alleybeachelectric/Gen6/ACB/ACB/ACB/jpg/ecam test.png

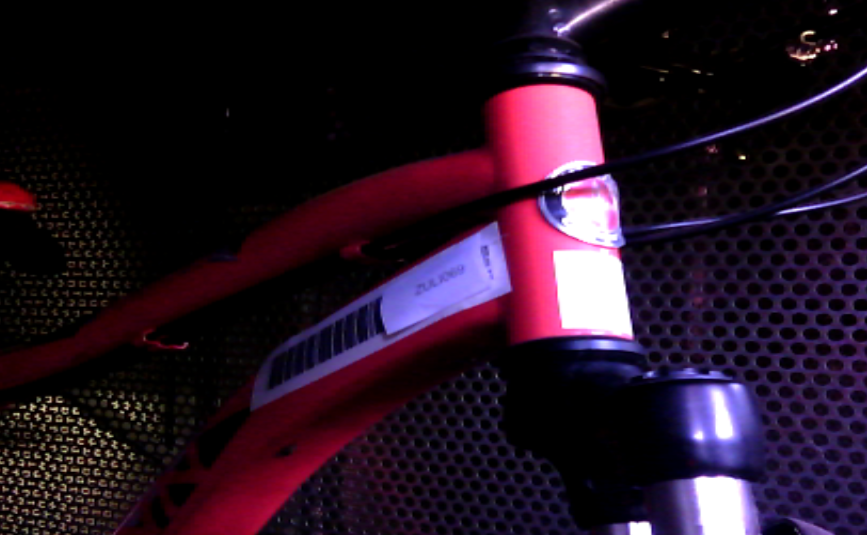
ACB/ACB/ACB/jpg/ecam test.png
