alleybeachelectric/Gen6/ACB/ACB/ACB/jpg/cam1 12 in from top no IR.jpg

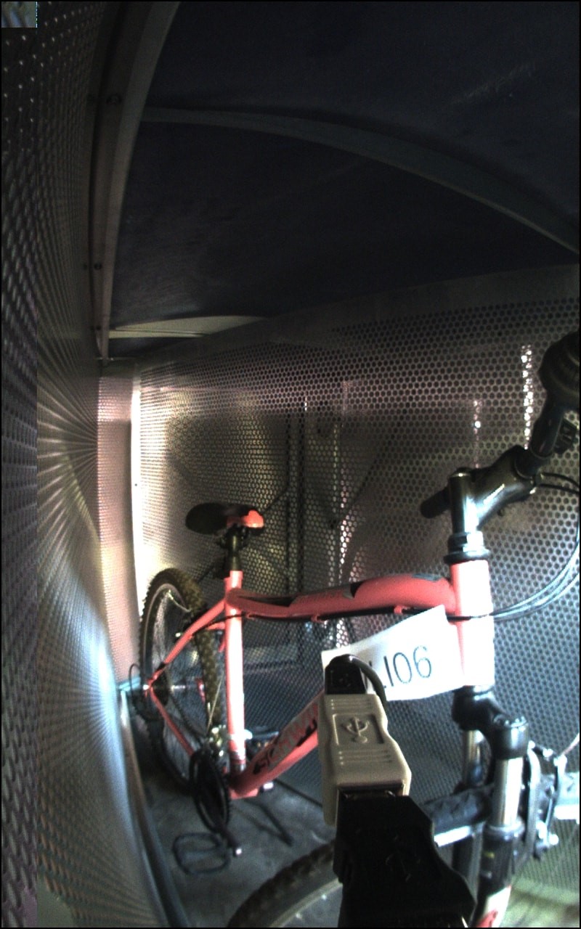
ACB/ACB/ACB/jpg/cam1 12 in from top no IR.jpg
