alleybeachelectric/Gen6/ACB/ACB/ACB/jpg/cam1 12 in from bottom rotated closer to center devider pitched 14.3degrees.jpg

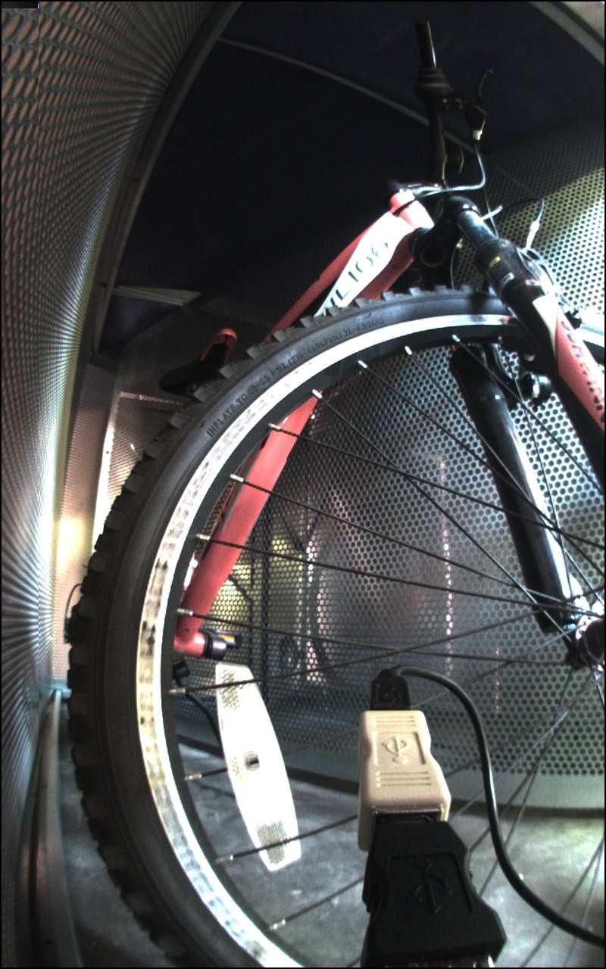
ACB/ACB/ACB/jpg/cam1 12 in from bottom rotated closer to center devider pitched 14.3degrees.jpg
