alleybeachelectric/Gen6/ACB/ACB/ACB/jpg/cam1 12 in from bottom, no IR .jpg

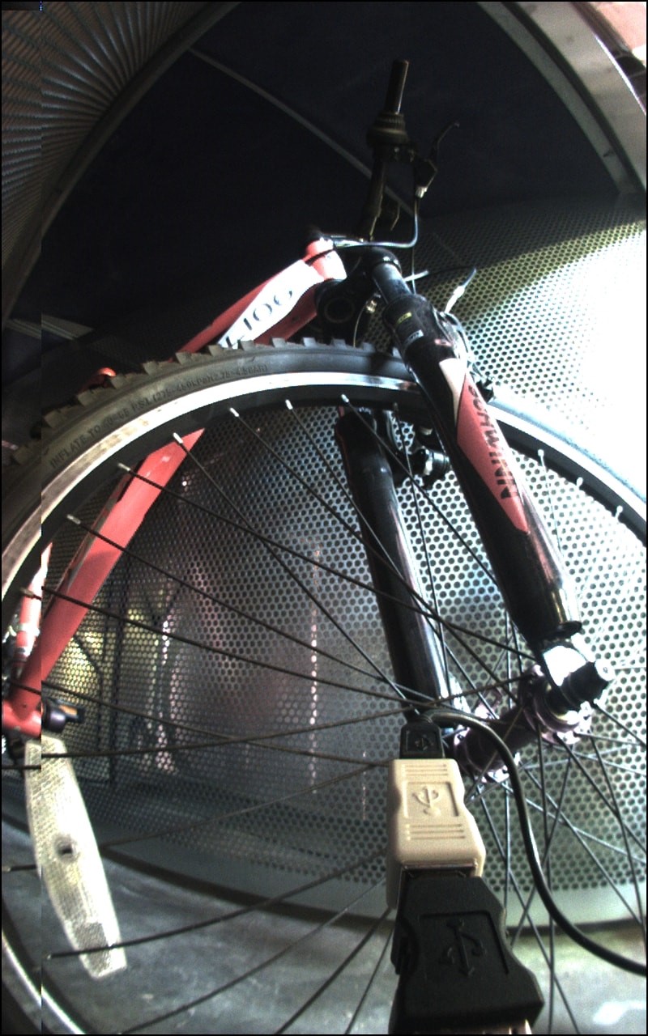
ACB/ACB/ACB/jpg/cam1 12 in from bottom, no IR .jpg
