alleybeachelectric/Gen6/ACB/ACB/ACB/jpg/ecam 1 in.png

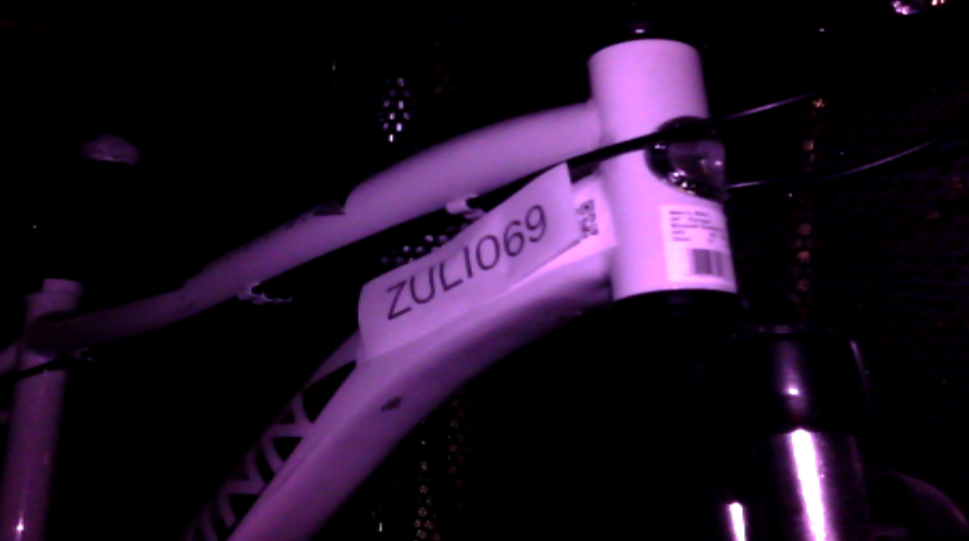
ACB/ACB/ACB/jpg/ecam 1 in.png
