alleybeachelectric/Gen6/ACB/ACB/ACB/jpg/ecam 2 in.png

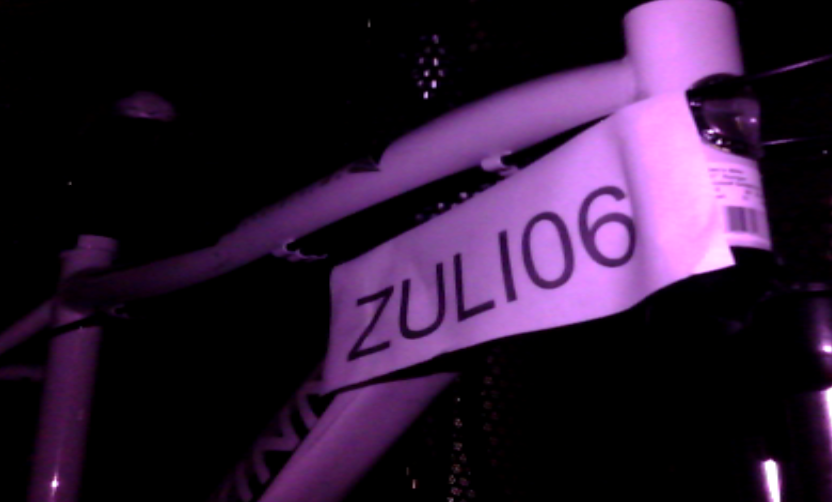
ACB/ACB/ACB/jpg/ecam 2 in.png
