alleybeachelectric/Gen6/ACB/ACB/ACB/jpg/ecam .5 in.png

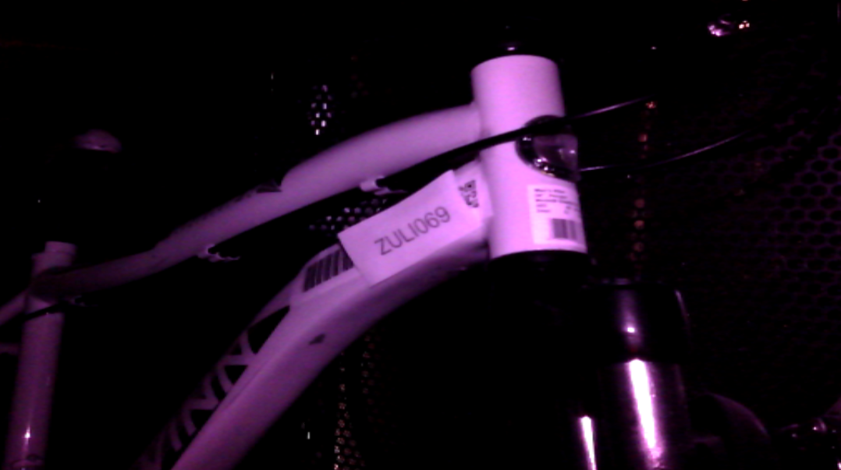
ACB/ACB/ACB/jpg/ecam .5 in.png
