alleybeachelectric/Gen6/ACB/ACB/ACB/jpg/ecam .25 in.png

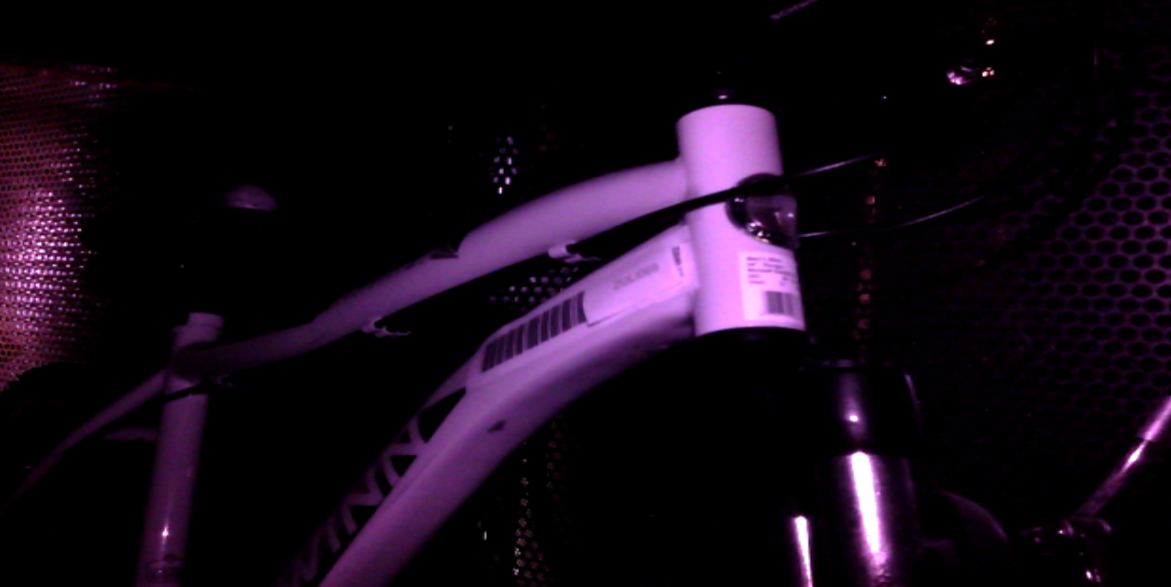
ACB/ACB/ACB/jpg/ecam .25 in.png
