alleybeachelectric/Gen6/ACB/ACB/ACB/jpg/r2/ecam 2 in mid.png

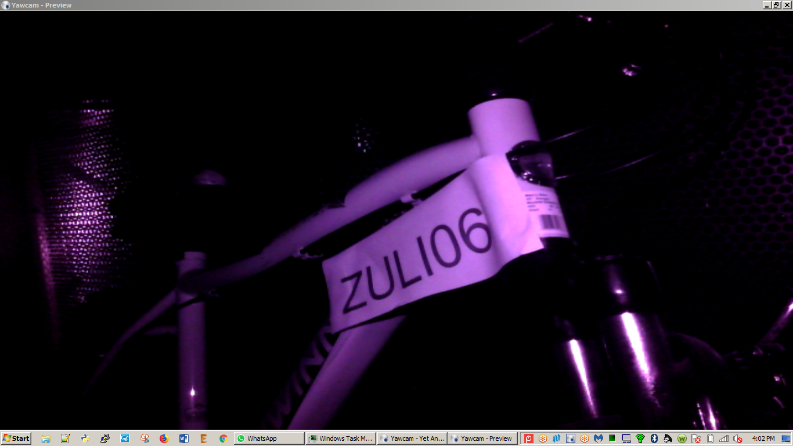
ACB/ACB/ACB/jpg/r2/ecam 2 in mid.png
