alleybeachelectric/Gen6/ACB/ACB/GMB dims.PNG

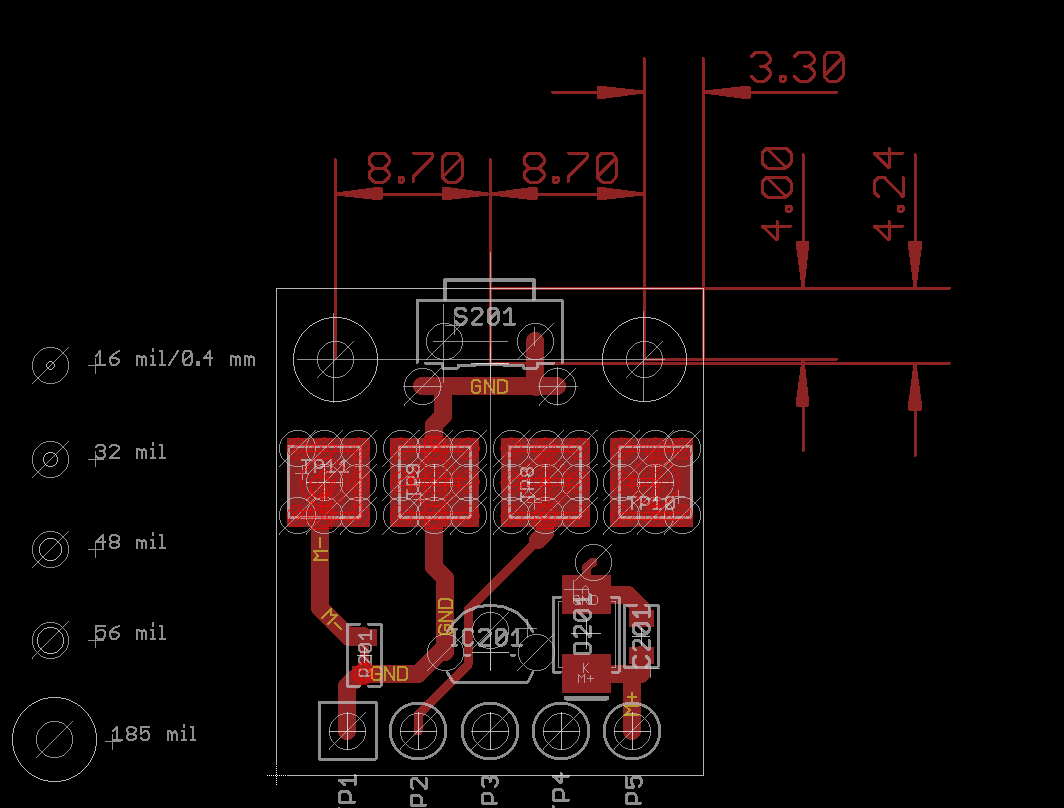
ACB/ACB/GMB dims.PNG
