alleybeachelectric/Gen6/ACB/ACB-LITE-3.2/Fab file release for quote/rd.ACB LITE R3.2 BOM.xlsx

Qty | Value | Device | Package | Parts | Description | digikey link
1 | 0.025R | R-0805 | 0805 | R39 |  | https://www.digikey.com/product-detail/en/vishay-dale/WSL0805R0250FEA18/WSLB-.025CT-ND/713391
2 | 0.12R | R-0805 | 0805 | R4, R5 |  | https://www.digikey.com/product-detail/en/yageo/RL0805FR-070R12L/311-.12SCT-ND/1037213
5 | 100K | EXB-38 | 0603-ARRAY | R1, R9, R50, R53, R54 | Resistor array 4x | https://www.digikey.com/product-detail/en/panasonic-electronic-components/EXB-38V104JV/Y9104CT-ND/256616
1 | 100R | R-0603 | 0603 | R28 |  | https://www.digikey.com/product-detail/en/yageo/RC0603FR-07100RL/311-100HRCT-ND/729835
3 | 100k | R-0603 | 0603 | R24, R75, R130 |  | https://www.digikey.com/product-detail/en/yageo/RC0603FR-07100KL/311-100KHRCT-ND/729836
1 | 100k->180k | R-0603 | 0603 | R47 |  | https://www.digikey.com/product-detail/en/yageo/RC0603JR-07180KL/311-180KGRCT-ND/729670
16 | 100n | C-0603 | 0603 | C8, C27, C28, C33, C35, C36, C39, C40, C41, C47, C49, C51, C55, C58, C64, C85 |  | https://www.digikey.com/product-detail/en/kemet/C0603C104J4RACTU/399-1097-1-ND/411372
1 | 100n->10n | C-0603 | 0603 | C57 |  | https://www.digikey.com/product-detail/en/kemet/C0603C103K5RACTU/399-1091-1-ND/411366
2 | 10K | EXB-38 | 0603-ARRAY | R2, R11 | Resistor array 4x | https://www.digikey.com/product-detail/en/panasonic-electronic-components/EXB-38V103JV/Y9103CT-ND/256604
1 | 10R | R-0603 | 0603 | R92 |  | https://www.digikey.com/product-detail/en/vishay-beyschlag/MCT06030C1009FP500/MCT0603-10.0-CFCT-ND/2607880
7 | 10k | R-0603 | 0603 | R18, R26, R27, R30, R71, R91, R128 |  | https://www.digikey.com/product-detail/en/vishay-beyschlag/MCT06030C1002FP500/MCT0603-10.0K-CFCT-ND/2607933
1 | 10n | C-0603 | 0603 | C66 |  | https://www.digikey.com/product-detail/en/kemet/C0603C103K5RACTU/399-1091-1-ND/411366
13 | 10nF | C-0603 | 0603 | C2, C3, C4, C5, C6, C7, C9, C10, C11, C12, C13, C43, C44 |  | https://www.digikey.com/product-detail/en/kemet/C0603C103K5RACTU/399-1091-1-ND/411366
1 | 10p | C-0603 | 0603 | C26 |  | https://www.digikey.com/product-detail/en/murata-electronics-north-america/GRM1885C1H100JA01D/490-1403-1-ND/587642
3 | 10u | C-0603 | 0603 | C53, C67, C88 |  | https://www.digikey.com/product-detail/en/murata-electronics-north-america/GRM188R61A106KE69D/490-10474-1-ND/5026392
3 | 10uTA | CT-1206 | 1206-POL-C | C54, C56, C86 |  | https://www.digikey.com/product-detail/en/kemet/T491A106K010AT/399-3684-1-ND/819009
1 | 166087-4 | 166087-4 | 166087-4 | CON2 |  | https://www.digikey.com/product-detail/en/te-connectivity-amp-connectors/166087-4/166087-4-ND/2327272
2 | 180k | R-0603 | 0603 | R94, R97 |  | https://www.digikey.com/product-detail/en/yageo/RC0603JR-07180KL/311-180KGRCT-ND/729670
2 | 18p | C-0603 | 0603 | C60, C61 |  | https://www.digikey.com/product-detail/en/samsung-electro-mechanics/CL10C180FB8NNNC/1276-2206-1-ND/3890292
1 | 1M | EXB-38 | 0603-ARRAY | R10 | Resistor array 4x | https://www.mouser.com/ProductDetail/Panasonic/EXB-38V105JV | out of stock on digikey
19 | 1M | R-0603 | 0603 | R12, R13, R20, R21, R23, R25, R31, R32, R34, R41, R42, R44, R45, R48, R65, R72, R73, R82, R132 |  | https://www.digikey.com/product-detail/en/yageo/RC0603FR-071ML/311-1.00MHRCT-ND/729791
2 | 1R | R-0805 | 0805 | R105, R106 |  | https://www.digikey.com/product-detail/en/susumu/RL1220S-1R0-F/RL12S1.00FCT-ND/433032
2 | 1k | R-0603 | 0603 | R90, R102 |  | https://www.digikey.com/product-detail/en/yageo/RC0603FR-071KL/311-1.00KHRCT-ND/729790
4 | 1k | R-0805 | 0805 | R35, R36, R37, R38 |  | https://www.digikey.com/product-detail/en/yageo/RC0805JR-071KL/311-1.0KARCT-ND/731165
7 | 1n | C-0603 | 0603 | C24, C34, C62, C63, C65, C69, C70 |  | https://www.digikey.com/product-detail/en/kemet/C0603C102F3GACTU/399-7825-1-ND/3471548
3 | 1u | C-0603 | 0603 | C48, C50, C52 |  | https://www.digikey.com/product-detail/en/taiyo-yuden/EMK107BJ105KA-T/587-1251-1-ND/931028
1 | 1u->100n | C-0603 | 0603 | C59 |  | https://www.digikey.com/product-detail/en/kemet/C0603C104J4RACTU/399-1097-1-ND/411372
1 | 1u/16V | C-0603 | 0603 | C37 |  | https://www.digikey.com/product-detail/en/taiyo-yuden/EMK107BJ105KA-T/587-1251-1-ND/931028
2 | 220u/25V | CAP-ELEC-SMD-8MM | CAP_8MM_DIA_SMT | C83, C84 |  | https://www.digikey.com/product-detail/en/nichicon/UWT1E221MNL1GS/493-2192-1-ND/590167
2 | 24LC32A-I/MS | 24-I/MS | MSOP-08 | IC7, IC11 | Serial EEPROM | https://www.digikey.com/products/en?keywords=24LC32A-I%2FMS
6 | 2K | R-0603 | 0603 | R6, R8, R15, R16, R51, R52 |  | https://www.digikey.com/product-detail/en/yageo/RC0603FR-072KL/311-2.00KHRCT-ND/729956
2 | 2k2 | R-0603 | 0603 | R100, R101 |  | https://www.digikey.com/product-detail/en/yageo/RC0603FR-072K2L/311-2.20KHRCT-ND/729963
6 | 3-641215-2 | 3-641215-2 | 3-641215-2 | J1, J2, J5, J6, J7, J13 | header 2 pin 100mil spacing | https://www.digikey.com/products/en?keywords=3-641215-2
2 | 3-641215-5 | 3-641215-5 | 3-641215-5 | J14, J15 |  | https://www.digikey.com/products/en?keywords=3-641215-5
1 | 3.3K | EXB-38 | 0603-ARRAY | R7 | Resistor array 4x | https://www.digikey.com/product-detail/en/panasonic-electronic-components/EXB-38V332JV/Y9332CT-ND/256598
4 | 300R | R-0603 | 0603 | R3, R29, R93, R103 |  | https://www.digikey.com/product-detail/en/yageo/RC0603JR-07300RL/311-300GRCT-ND/729712
3 | 300k | R-0603 | 0603 | R14, R40, R43 |  | https://www.digikey.com/product-detail/en/yageo/RC0603FR-07300KL/311-300KHRCT-ND/730092
2 | 4.7u/16V | C-0805 | 0805 | C1, C38 |  | https://www.digikey.com/product-detail/en/yageo/CC0603KRX5R7BB475/311-1785-1-ND/5195687
1 | 470n/25 | C-0603 | 0603 | C25 |  | https://www.digikey.com/product-detail/en/murata-electronics-north-america/GRM188R71E474KA12D/490-3291-1-ND/702832
2 | 47k | R-0603 | 0603 | R17, R77 |  | https://www.digikey.com/product-detail/en/yageo/RC0603JR-0747KL/311-47KGRCT-ND/729741
1 | 47u/6.3 | C-1206 | 1206 | C30 | Capacitor 1206 | https://www.digikey.com/product-detail/en/samsung-electro-mechanics/CL31A476MQHNNNE/1276-1167-1-ND/3889253
2 | 47uTC | CT-C | CT-C | C31, C81 |  | https://www.digikey.com/product-detail/en/avx-corporation/TPSC476K016R0350/478-1773-1-ND/564805
4 | 4M99 | R-0603 | 0603 | R22, R33, R95, R98 |  | https://www.digikey.com/product-detail/en/vishay-dale/CRCW06034M99FKEA/541-4.99MHCT-ND/1180231
3 | 4u7/50 | C-1206 | 1206 | C22, C23, C29 | Capacitor 1206 | https://www.digikey.com/product-detail/en/taiyo-yuden/UMK316AB7475KL-T/587-2994-6-ND/2714203
4 | 560k | R-0603 | 0603 | R19, R49, R96, R99 |  | https://www.digikey.com/product-detail/en/yageo/RC0603FR-07560KL/311-560KHRCT-ND/730252
1 | 560k->750k | R-0603 | 0603 | R46 |  | https://www.digikey.com/product-detail/en/yageo/RC0603JR-07750KL/311-750KGRCT-ND/729773
1 | 8MHz-5x3.2mm | XTAL-7B | 7B | X1 |  | https://www.digikey.com/product-detail/en/abracon-llc/ASFL1-8.000MHZ-EC-T/300-8241-1-ND/687934
1 | AT25SF321-SSHD | M25P16-VMN6P | SO-08 | IC9 | 16Mbit low voltage SPI Flash | https://www.digikey.com/product-detail/en/adesto-technologies/AT25SF321-SSHD-T/1265-1279-1-ND/6827527
1 | BAT54S | BAT54S | SOT-23 | D1 | Schottky diode dual 30V 200mA | https://www.digikey.com/product-detail/en/on-semiconductor/BAT54SLT1G/BAT54SLT1GOSCT-ND/917811
1 | BZX84C6V2 | BZX84C6V2 | SOT-23 | D9 | Diode Zener SOT23 | https://www.digikey.com/product-detail/en/diodes-incorporated/BZX84C6V2S-7-F/BZX84C6V2S-FDICT-ND/815459
1 | DNP | L-0805-0R | 0805-0RTOP | L2 |  | https://www.digikey.com/product-detail/en/yageo/RC0805JR-070RL/311-0.0ARCT-ND/731163
1 | DNP-TestPoint | ROUND_SMD1MM | SMD_ROUND_1MM | TP1 | Generic round SMD testpad
2 | DNP-TestPoint | ROUND_SMDTH1.4MM | TH_ROUND_14MM08MM | TP2, TP4 | Generic round SMD testpad
1 | DNP-open-hole | MA05-1 | MA05-1 | J17
1 | DNP/0R | R-0603 | 0603 | R129 |  | https://www.digikey.com/product-detail/en/yageo/RC0603JR-070RL/311-0.0GRCT-ND/729622
1 | FDC6330L | FDC6330L | SSOT-6 | Q3 | IC LOAD SWITCH INT 20VIN SSOT-6, 80mOhm, 2.5A | https://www.digikey.com/product-detail/en/on-semiconductor/FDC6330L/FDC6330LCT-ND/1626189
2 | FDC6506P | FDC6506D | SSOT-6 | Q5, Q7 | Dual P-Channel Logic Level PowerTrench MOSFET | https://www.digikey.com/product-detail/en/on-semiconductor/FDC6506P/FDC6506PCT-ND/965588
2 | FDG6303N | FDG6303N | SC70-6 | Q4, Q6 | Dual N-channel digital FET 25V/0.5A 0.45Ohm | https://www.digikey.com/product-detail/en/on-semiconductor/FDG6303N/FDG6303NCT-ND/965594
5 | HI1206T500R | L-1206 | 1206 | L7, L8, L10, L11, L12 |  | https://www.digikey.com/product-detail/en/laird-signal-integrity-products/HI1206T500R-10/240-2412-1-ND/806772
1 | JP3CLOSE12 | JP3CLOSE12 | JP3CLOSE12 | JP1
1 | L6227Q | L6227Q | SQFP-S-5X5-32 | IC2 | DMOS dual full bridge driver | https://www.digikey.com/product-detail/en/stmicroelectronics/L6227Q/497-14755-ND/1852199
1 | LED-GREEN | LED-0805 | 0805-POL-D | D5 |  | https://www.digikey.com/product-detail/en/lite-on-inc/LTST-C171GKT/160-1423-1-ND/386792
1 | LQM31PN3R3M00L | L-1206 | 1206 | L13 |  | https://www.digikey.com/product-detail/en/murata-electronics-north-america/LQM31PN3R3M00L/490-6705-1-ND/3845902
1 | LT3971EMSE | LT3971EMSE | MSOP10EXP | IC3 | Stepdown 1,2A 4,3-38Vin 1,2-30Vout 0,2-2Mhz 2,5uAquesc, SS, accurate EN 1,0V 5,6$ | https://www.digikey.com/product-detail/en/linear-technology-analog-devices/LT3971EMSE-5-PBF/LT3971EMSE-5-PBF-ND/2485809
1 | MAX9938HEUK+T | TSM9938HEUK+T | SOT23-5 | IC10 | IC OPAMP CURRENT SENSE SOT23-5 | https://www.digikey.com/product-detail/en/maxim-integrated/MAX9938HEUK-T/MAX9938HEUK-TCT-ND/2234739
1 | MCP6042-I/MS | MCP6042-I/MS | MSOP-08 | IC16 | OAMP 14kHz LowPower 0,6uA G=1 stable OutCapLoad 70p/50k 10n/10k RailToRail VSS+0,4V VDD-0,5V | https://www.digikey.com/products/en?keywords=MCP6042-I%2FMS
1 | MIC841LYC | MIC841LYC | SC-70-5 | IC6 | Comparator intREF 1,24V 1,5-5,5V 1,5uA | https://www.digikey.com/product-detail/en/microchip-technology/MIC841LYC5-TR/576-2924-1-ND/1822084
1 | NR6028T4R7M | NR6028 | NR6028 | L9 | NR6028, NRS6028 6x6x2,5mm, NR6045, NRS6045 6x6x4,5mm | https://www.digikey.com/product-detail/en/taiyo-yuden/NR6028T4R7M/587-2100-1-ND/1866240
1 | P6SMB16A | P6SMB | SMB | D8 | P6SMB20A TVS Unidirectional 17.1V 1uA, 19.0-21.0V@1mA breakdown, 27.7V@22A P6SMB16A TVS Unidirectional 13.6V 1uA, 15.2-16.8V@1mA breakdown, 22.5V@27A | https://www.digikey.com/product-detail/en/littelfuse-inc/P6SMB16A/P6SMB16ALFCT-ND/1766665
2 | P6SMB20A | P6SMB | SMB | D3, D4 | P6SMB20A TVS Unidirectional 17.1V 1uA, 19.0-21.0V@1mA breakdown, 27.7V@22A P6SMB16A TVS Unidirectional 13.6V 1uA, 15.2-16.8V@1mA breakdown, 22.5V@27A | https://www.digikey.com/product-detail/en/vishay-semiconductor-diodes-division/P6SMB20A-E3-52/P6SMB20A-E3-52GICT-ND/3306494
14 | PIC-OUT | PIC-OUT | TEMP-PAD | O1, O23, O31, O44, T1, T5, T7, T15, T27, T32, T33, T36, T42, T44 | Docasna soucastka na smerovani wire k procesoru bez pripojeni k procesoru
19 | PIC-RPX | PIC-RPX | TEMP-PAD | O5, O6, O7, O8, O12, O13, O15, O16, O29, O30, O41, O42, T3, T13, T14, T40, T41, T43, T45 | Docasna soucastka na smerovani wire k procesoru bez pripojeni k procesoru
1 | PIC32MX470F512L-I/PF | PIC32MX470F512L-I/PF | TQFP100_14X14_0,5MM | IC1 | Jara 6.6.2017 sym, pac12x12 a pac 14x14 a zapojeni dev importovano z PIC32MX470F512L-80I_PF.bxl ...._PT.bxl | https://www.digikey.com/products/en?keywords=PIC32MX470F512L-I%2FPF
3 | PIN-AN | PIN-AN | TEMP-PAD | T37, T38, T39 | Docasna soucastka na smerovani wire k procesoru bez pripojeni k procesoru
2 | REF | REF | REF | REF1, REF2
1 | REF3025 | REF3025 | SOT23 | IC13 | REF3025 | https://www.digikey.com/product-detail/en/texas-instruments/REF3025AIDBZR/296-26322-1-ND/2254965
2 | RJ8-8-180 | RJ8-8-180 | RJ8-8-180 | J3, J4
1 | SMLVT3V3 | SMLVT3V3 | SMA | D2 | TVS 600W 4.1 Breakdown | https://www.digikey.com/product-detail/en/stmicroelectronics/SMLVT3V3/497-2496-1-ND/603878
1 | SN65HVD12D | SN65HVD3082ED | SO08 | IC12 | RS-422/485 TRX 1RX 1TX | https://www.digikey.com/product-detail/en/texas-instruments/SN65HVD12DR/296-26338-1-ND/2254975
2 | SS14 | DS-SMA | SMA | D6, D7 | Diody schotki: | https://www.digikey.com/product-detail/en/on-semiconductor/SS14/SS14CT-ND/965729
2 | SSM6P49NU,LFPZ | SSM6P49NU,LFPZ | MICRO_FET | Q1, Q2 | MOSFET P-CH DUAL 30V UDFN6, 4A, 20V | https://www.digikey.com/product-detail/en/toshiba-semiconductor-and-storage/SSM6P49NULF/SSM6P49NULFCT-ND/3522420
1 | T1A-LITTLEFUSE0154 | POJISTKA-LITTLEFUSE0154 | LITTLEFUSE0154 | F1 | Pojistka | https://www.digikey.com/product-detail/en/littelfuse-inc/0154003.DR/F1226CT-ND/183375
2 | TPD2E001DZDR | SR05.TCT | SOT-143 | IC14, IC15 | IC TVS ARRAY 2-LINE 5V SOT-143 | https://www.digikey.com/product-detail/en/texas-instruments/TPD2E001DZDR/296-24770-1-ND/2092592
1 | USB_A_180 | USB_B_180 | USB_B_180 | J12 | USB connector Type A/B 90/180 | https://www.digikey.com/product-detail/en/harwin-inc/M701-330442/952-1767-ND/3727736
238
