alleybeachelectric/Gen6/ACB/ACB/ACB/ACB-R1.0-43-CH04.dxf

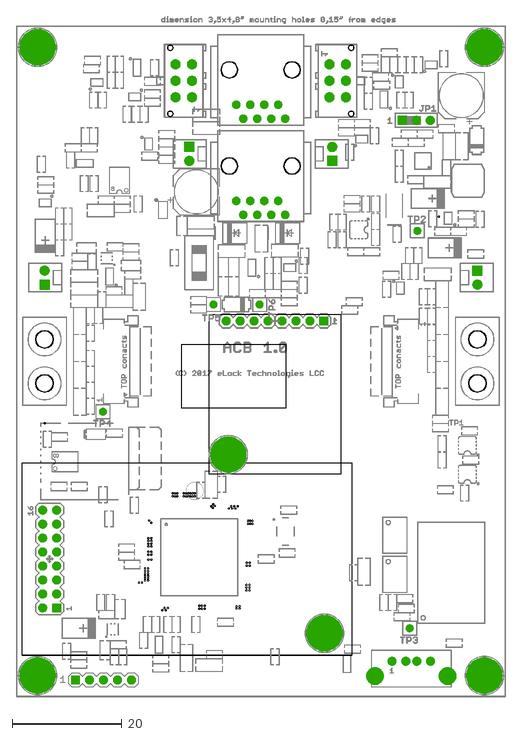
[picture p11: CAD file, 2018-02-02]
ACB/ACB/ACB/ACB-R1.0-43-CH04.dxf
89.1 x 123.9
