alleybeachelectric/Gen6/ACB/ACB/ACB/vps-r2.0-20-with-description.dxf

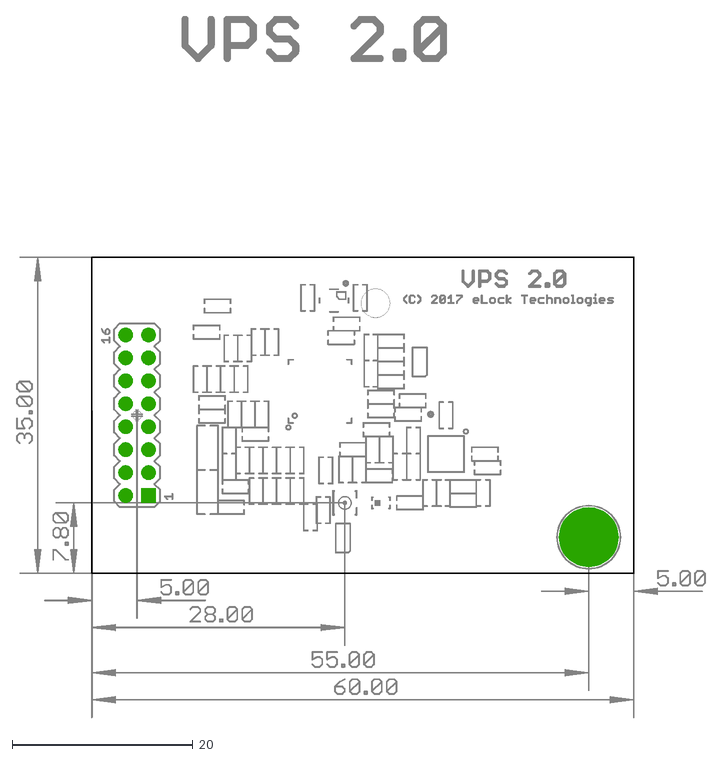
[picture p12: CAD file, 2018-02-02]
ACB/ACB/ACB/vps-r2.0-20-with-description.dxf
76.3 x 77.7
