alleybeachelectric/Gen6/BT BOARD/BlueToothModuleConnectors.02.25.18.PDF

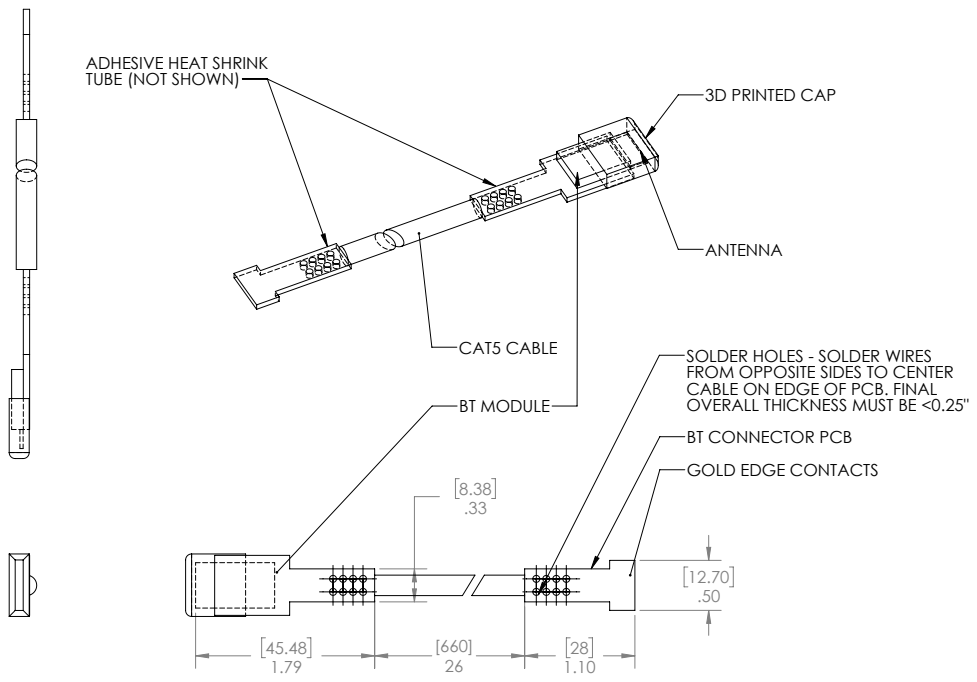
[picture p13: page 1]
3D PRINTED CAP; BT MODULE; OVERALL THICKNESS MUST BE <0.25"; CAT5 CABLE

ADHESIVE HEAT SHRINK
TUBE (NOT SHOWN)

SOLDER HOLES - SOLDER WIRES
FROM OPPOSITE SIDES TO CENTER
CABLE ON EDGE OF PCB. FINAL

BT CONNECTOR PCB
GOLD EDGE CONTACTS
