alleybeachelectric/Gen6/CONSOLE/rev1.0/PCB_ICBExt-R1.0-J36-CH01.brd

## EAGLE design CONSOLE/rev1.0/PCB_ICBExt-R1.0-J36-CH01.brd (2018-03-08)

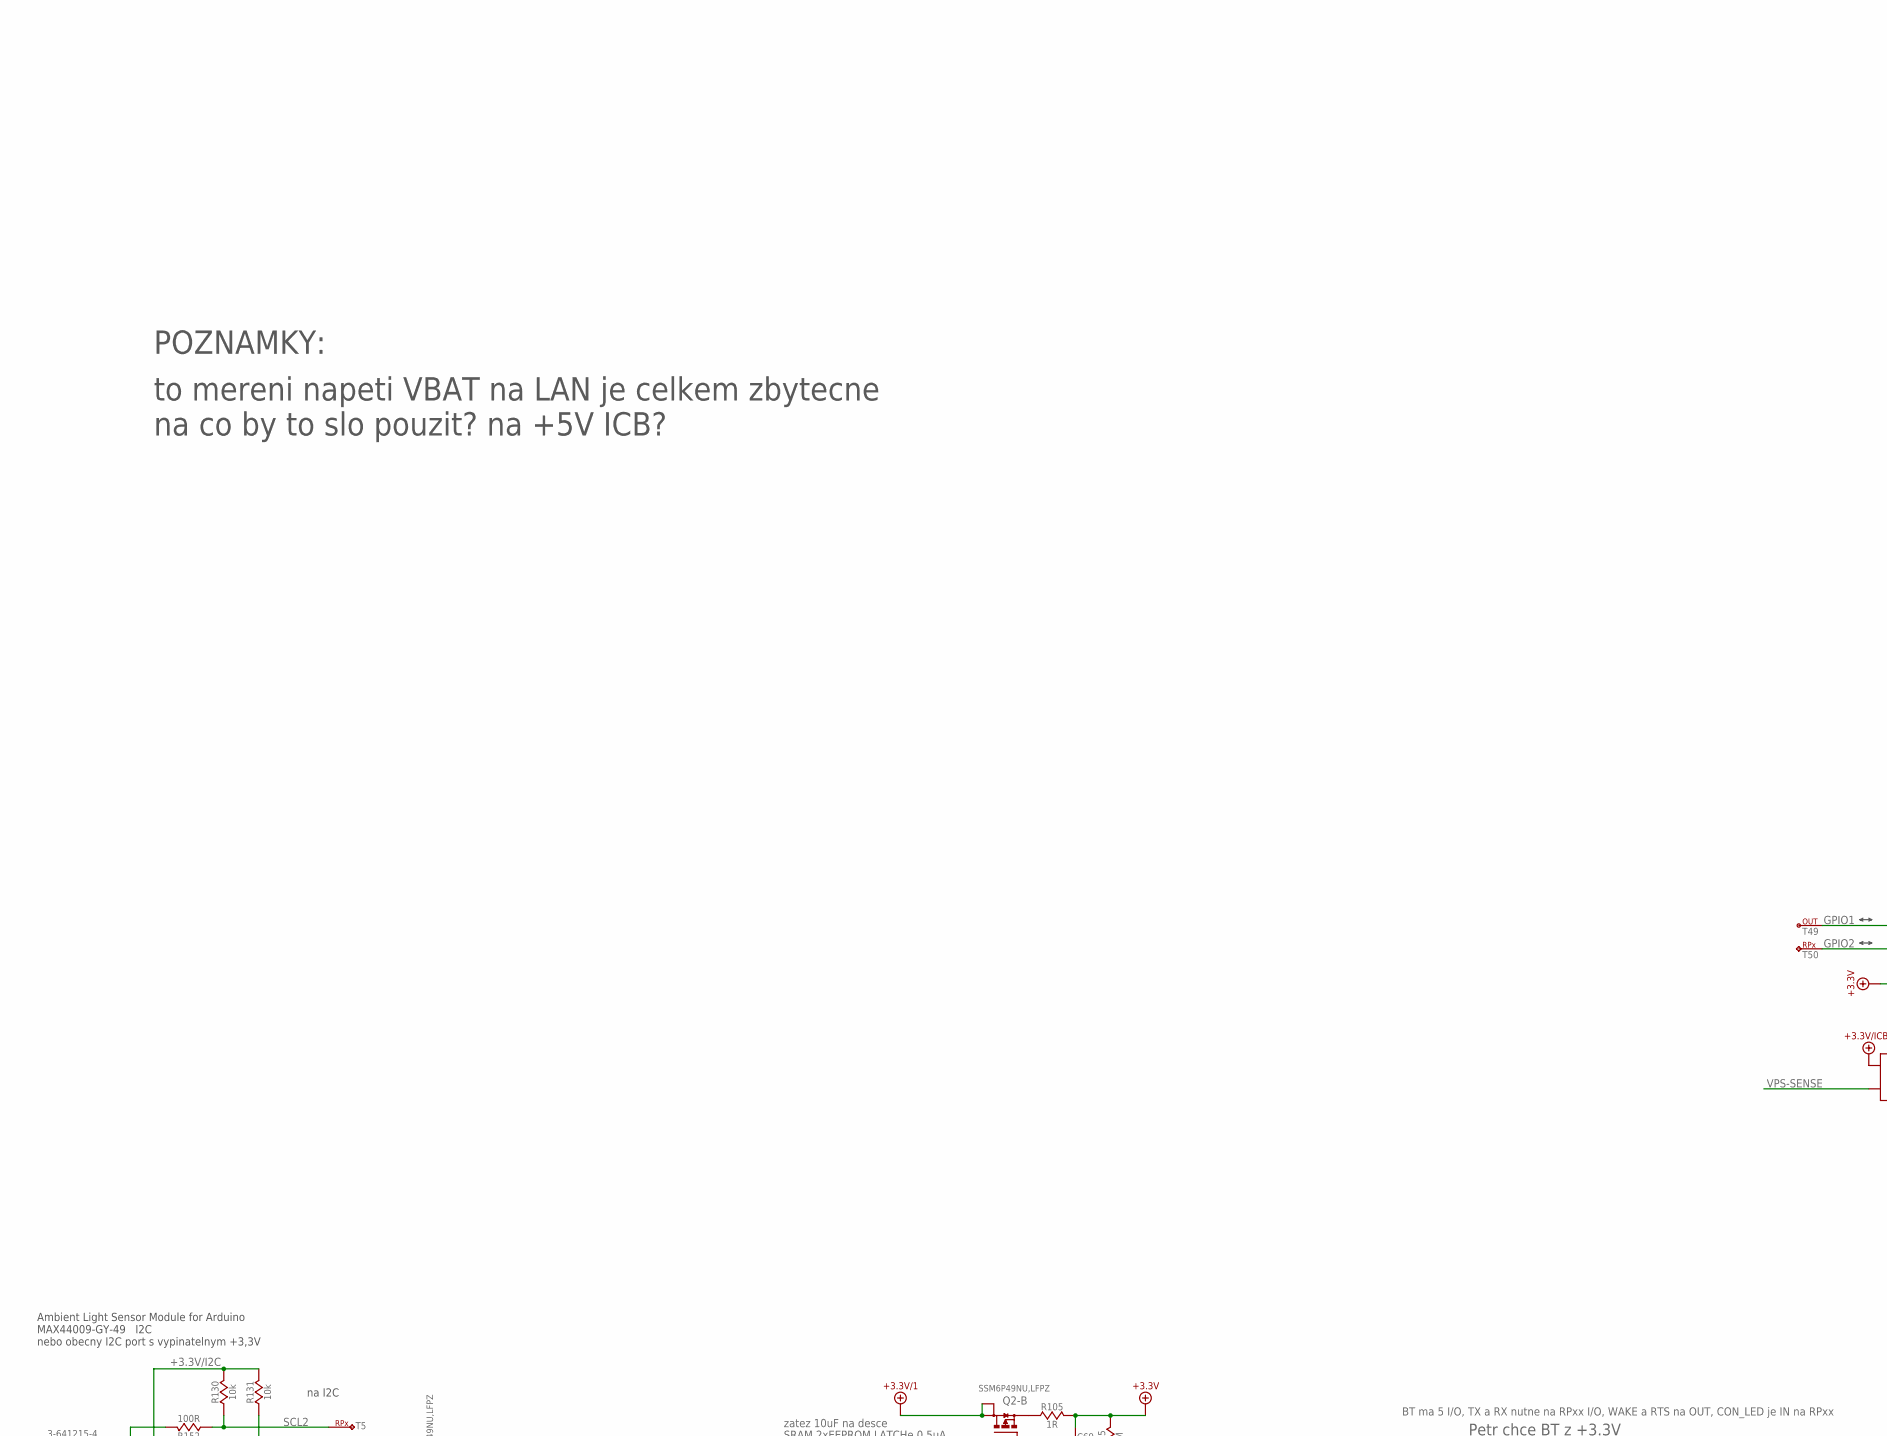
[picture p14: schematic PCB_ICBExt-R1.0-J36-CH01.sch, part in row 1, column 1]

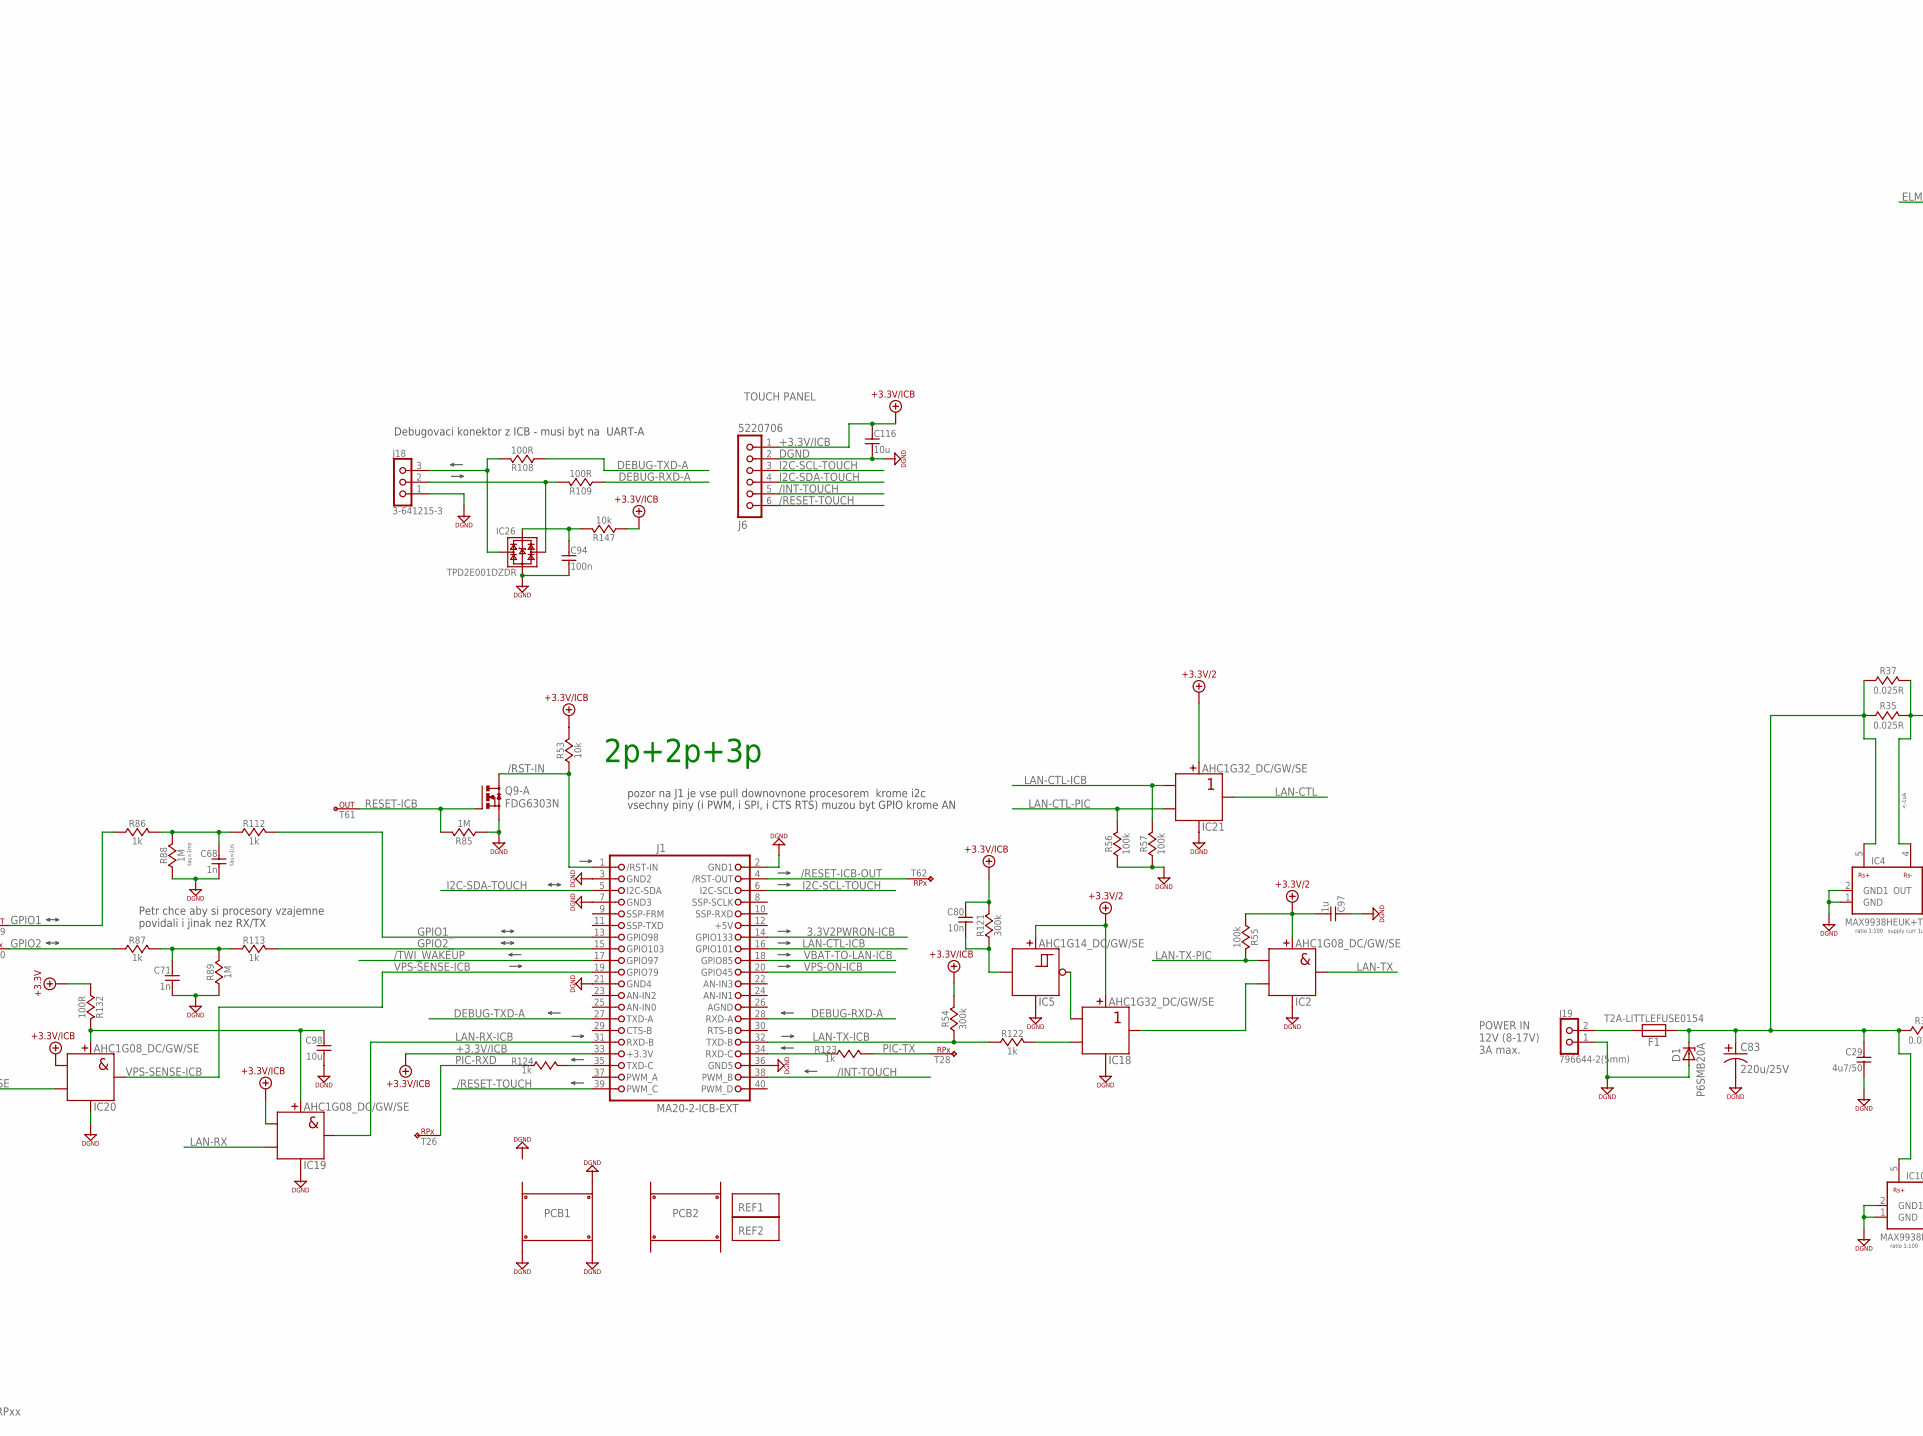
[picture p15: schematic PCB_ICBExt-R1.0-J36-CH01.sch, part in row 1, column 2]

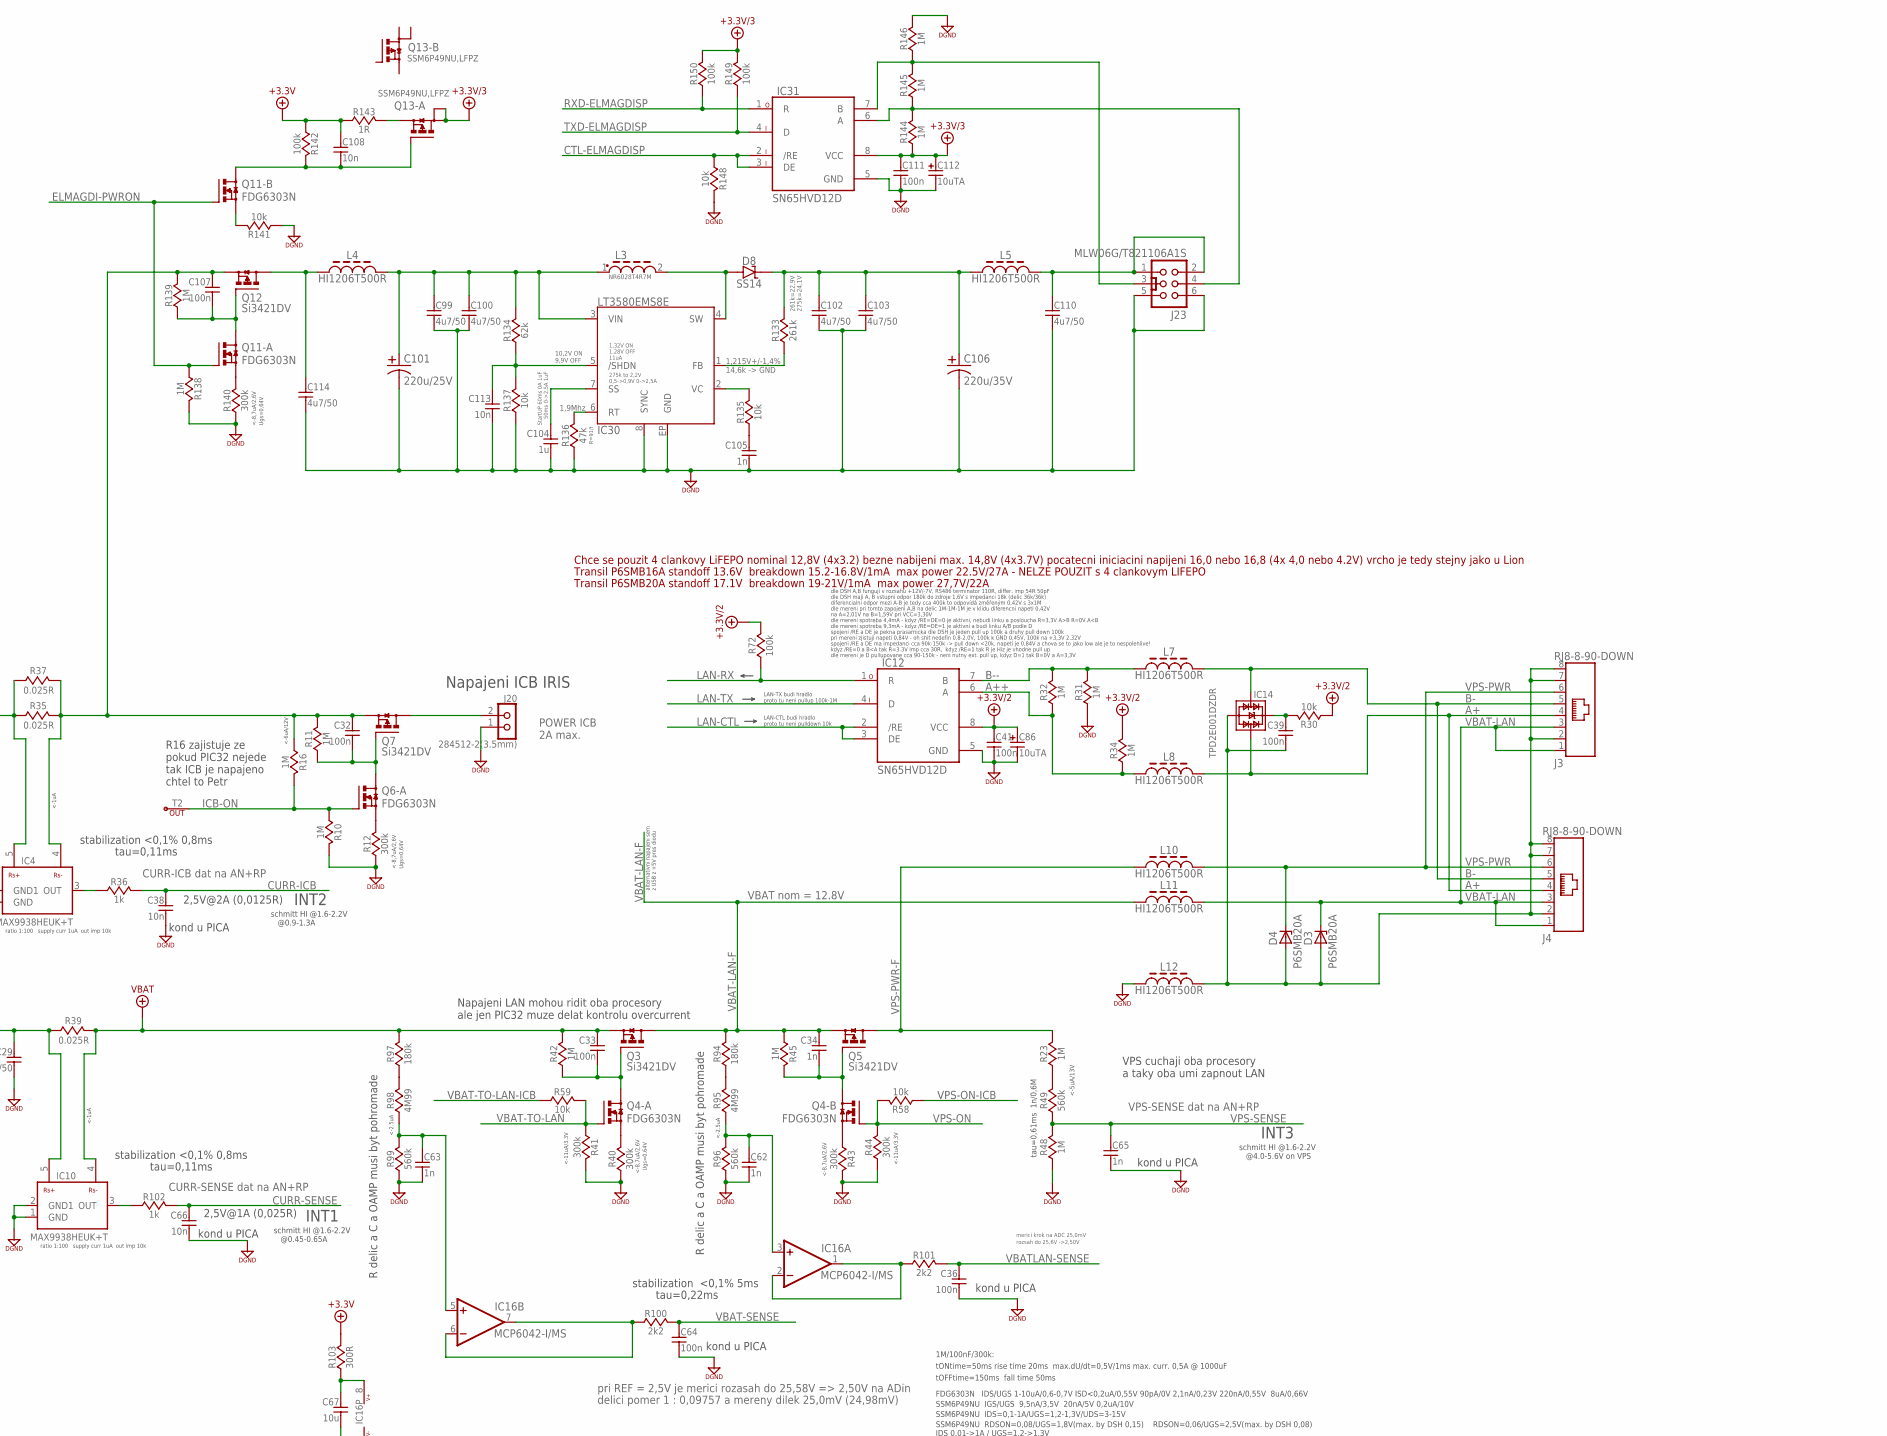
[picture p16: schematic PCB_ICBExt-R1.0-J36-CH01.sch, part in row 1, column 3]

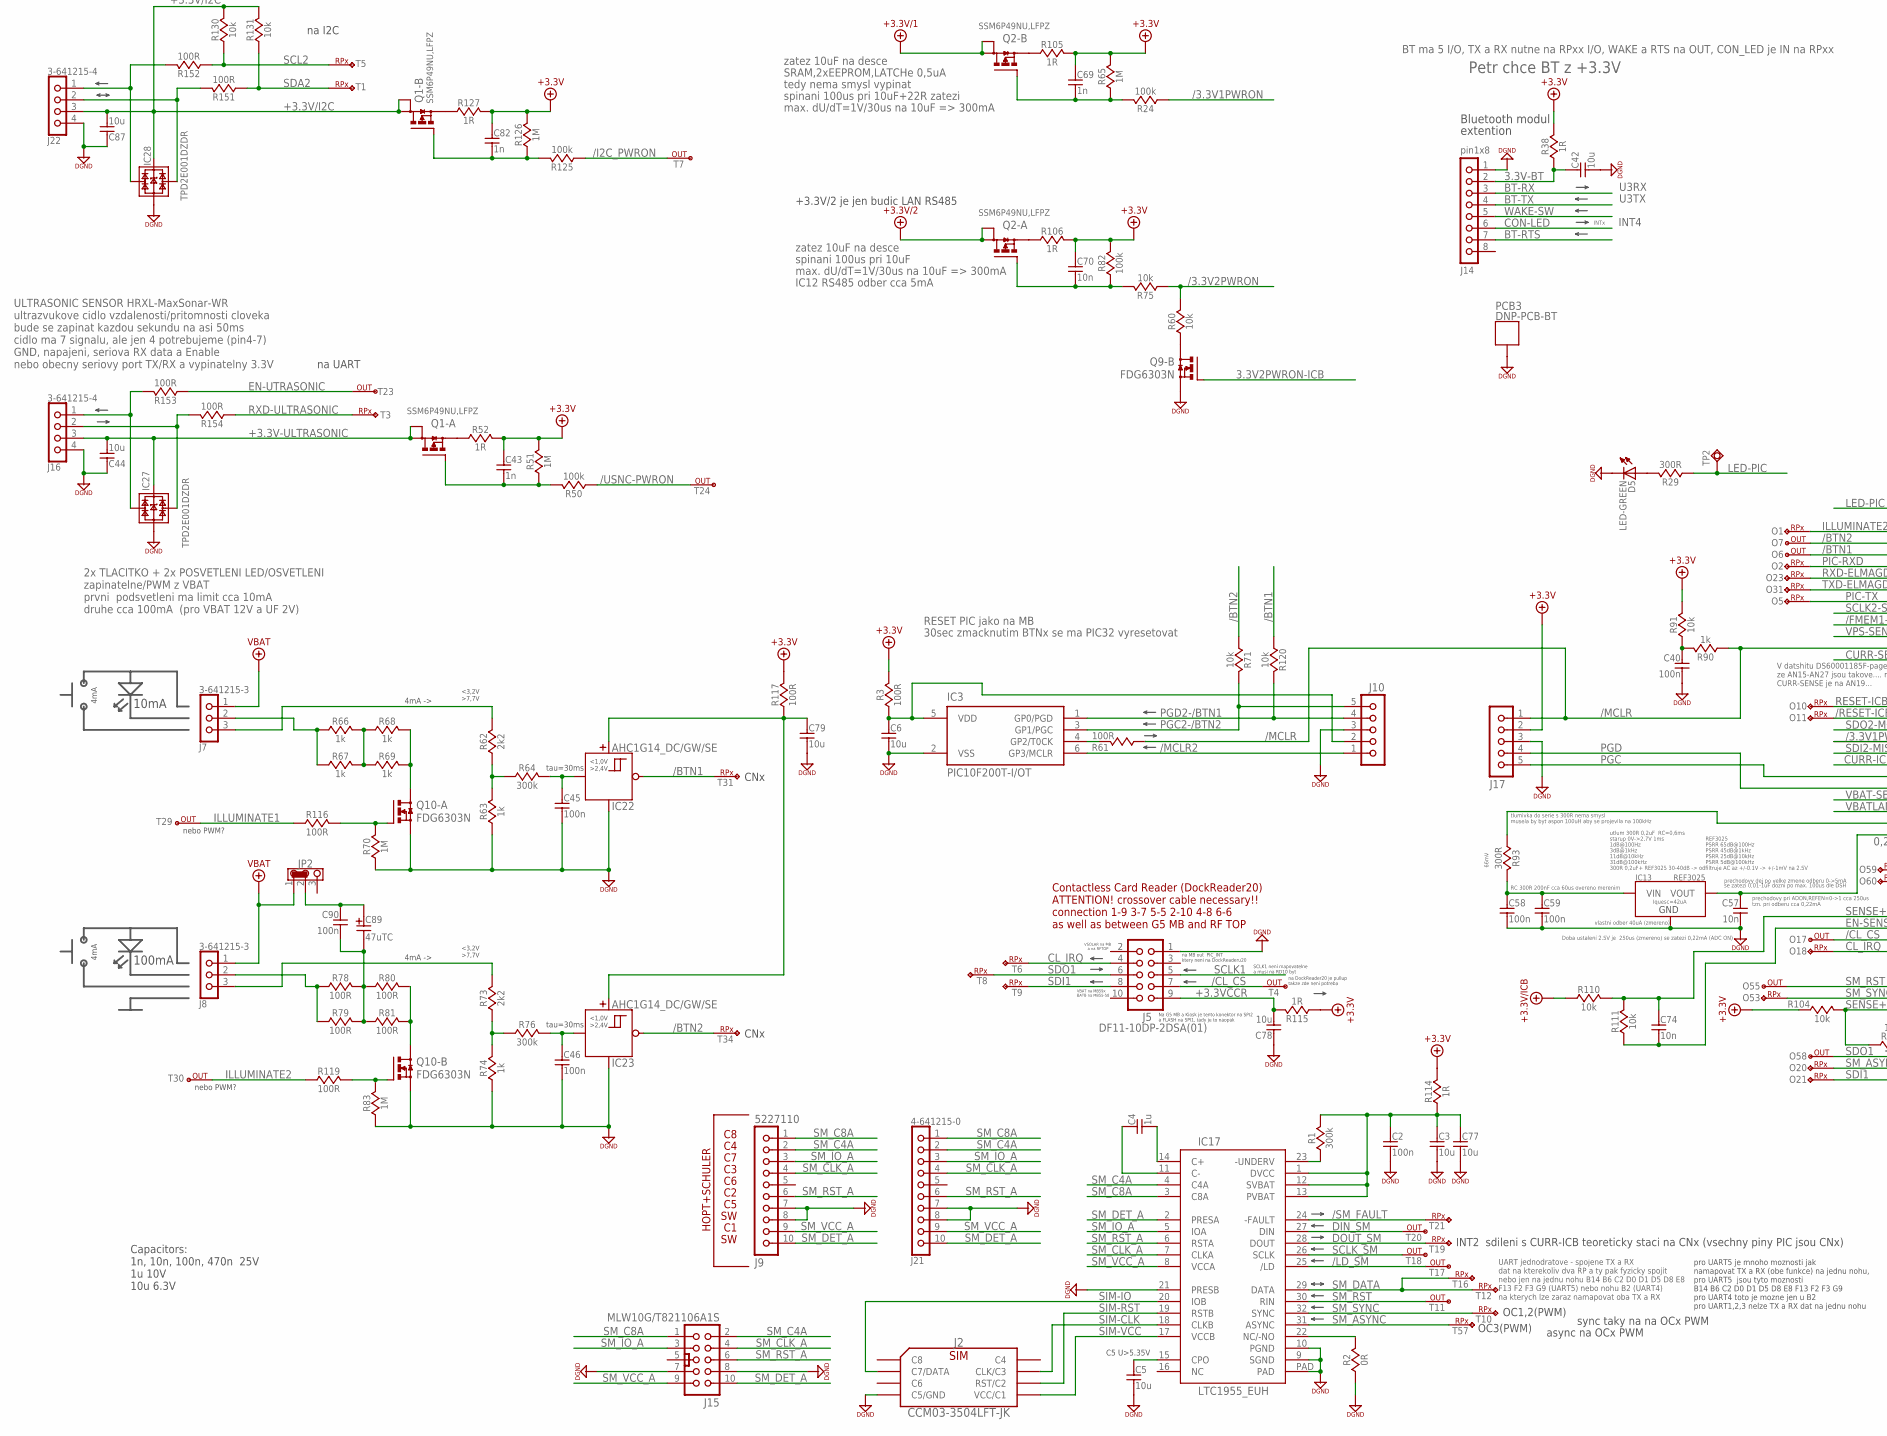
[picture p17: schematic PCB_ICBExt-R1.0-J36-CH01.sch, part in row 2, column 1]

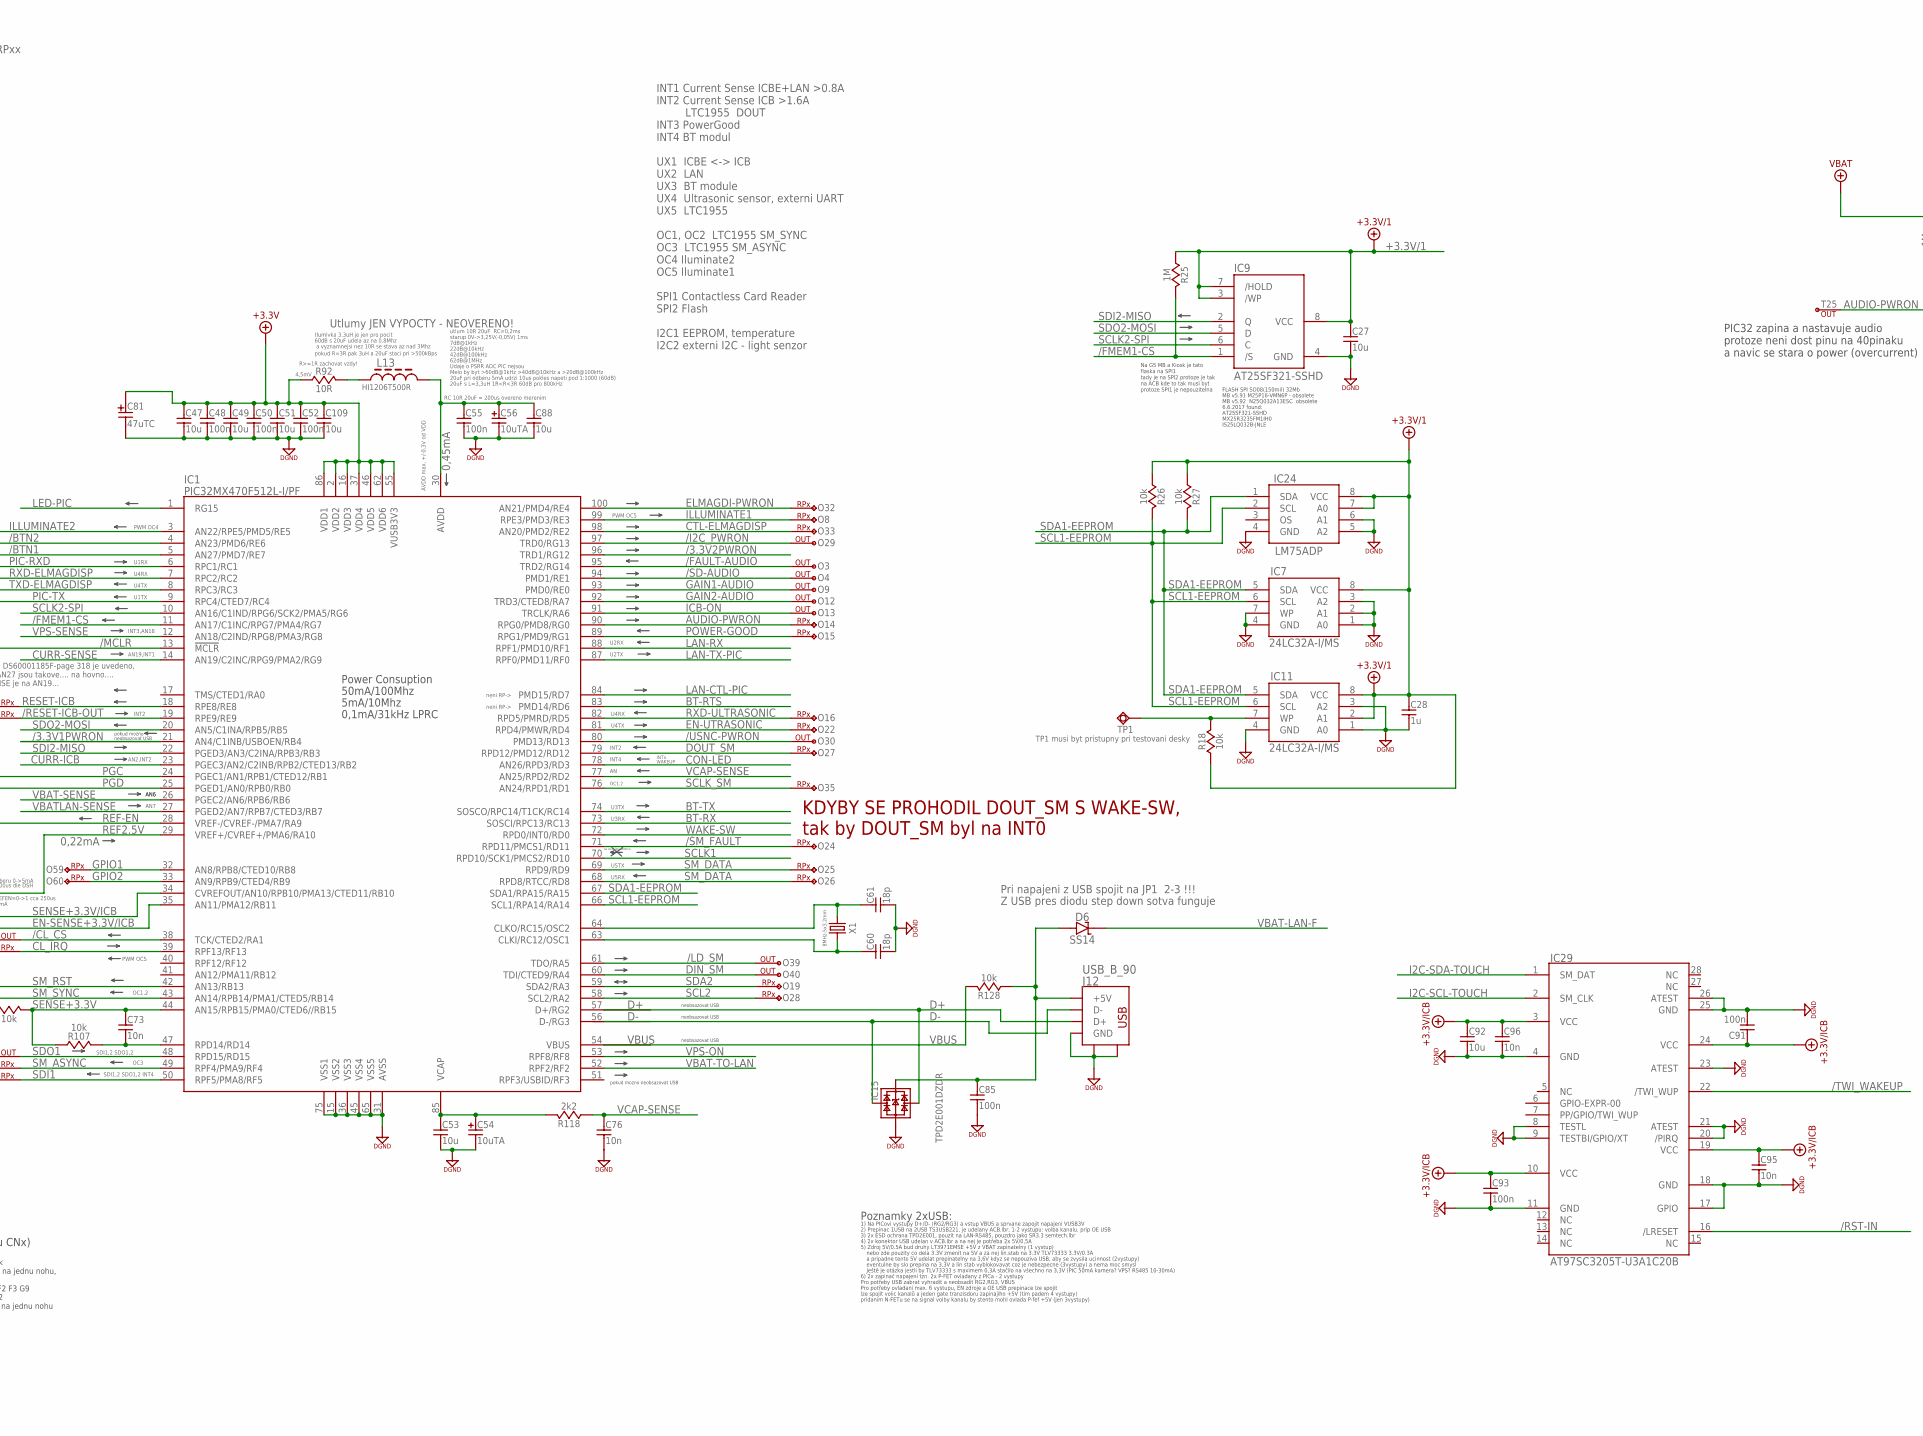
[picture p18: schematic PCB_ICBExt-R1.0-J36-CH01.sch, part in row 2, column 2]

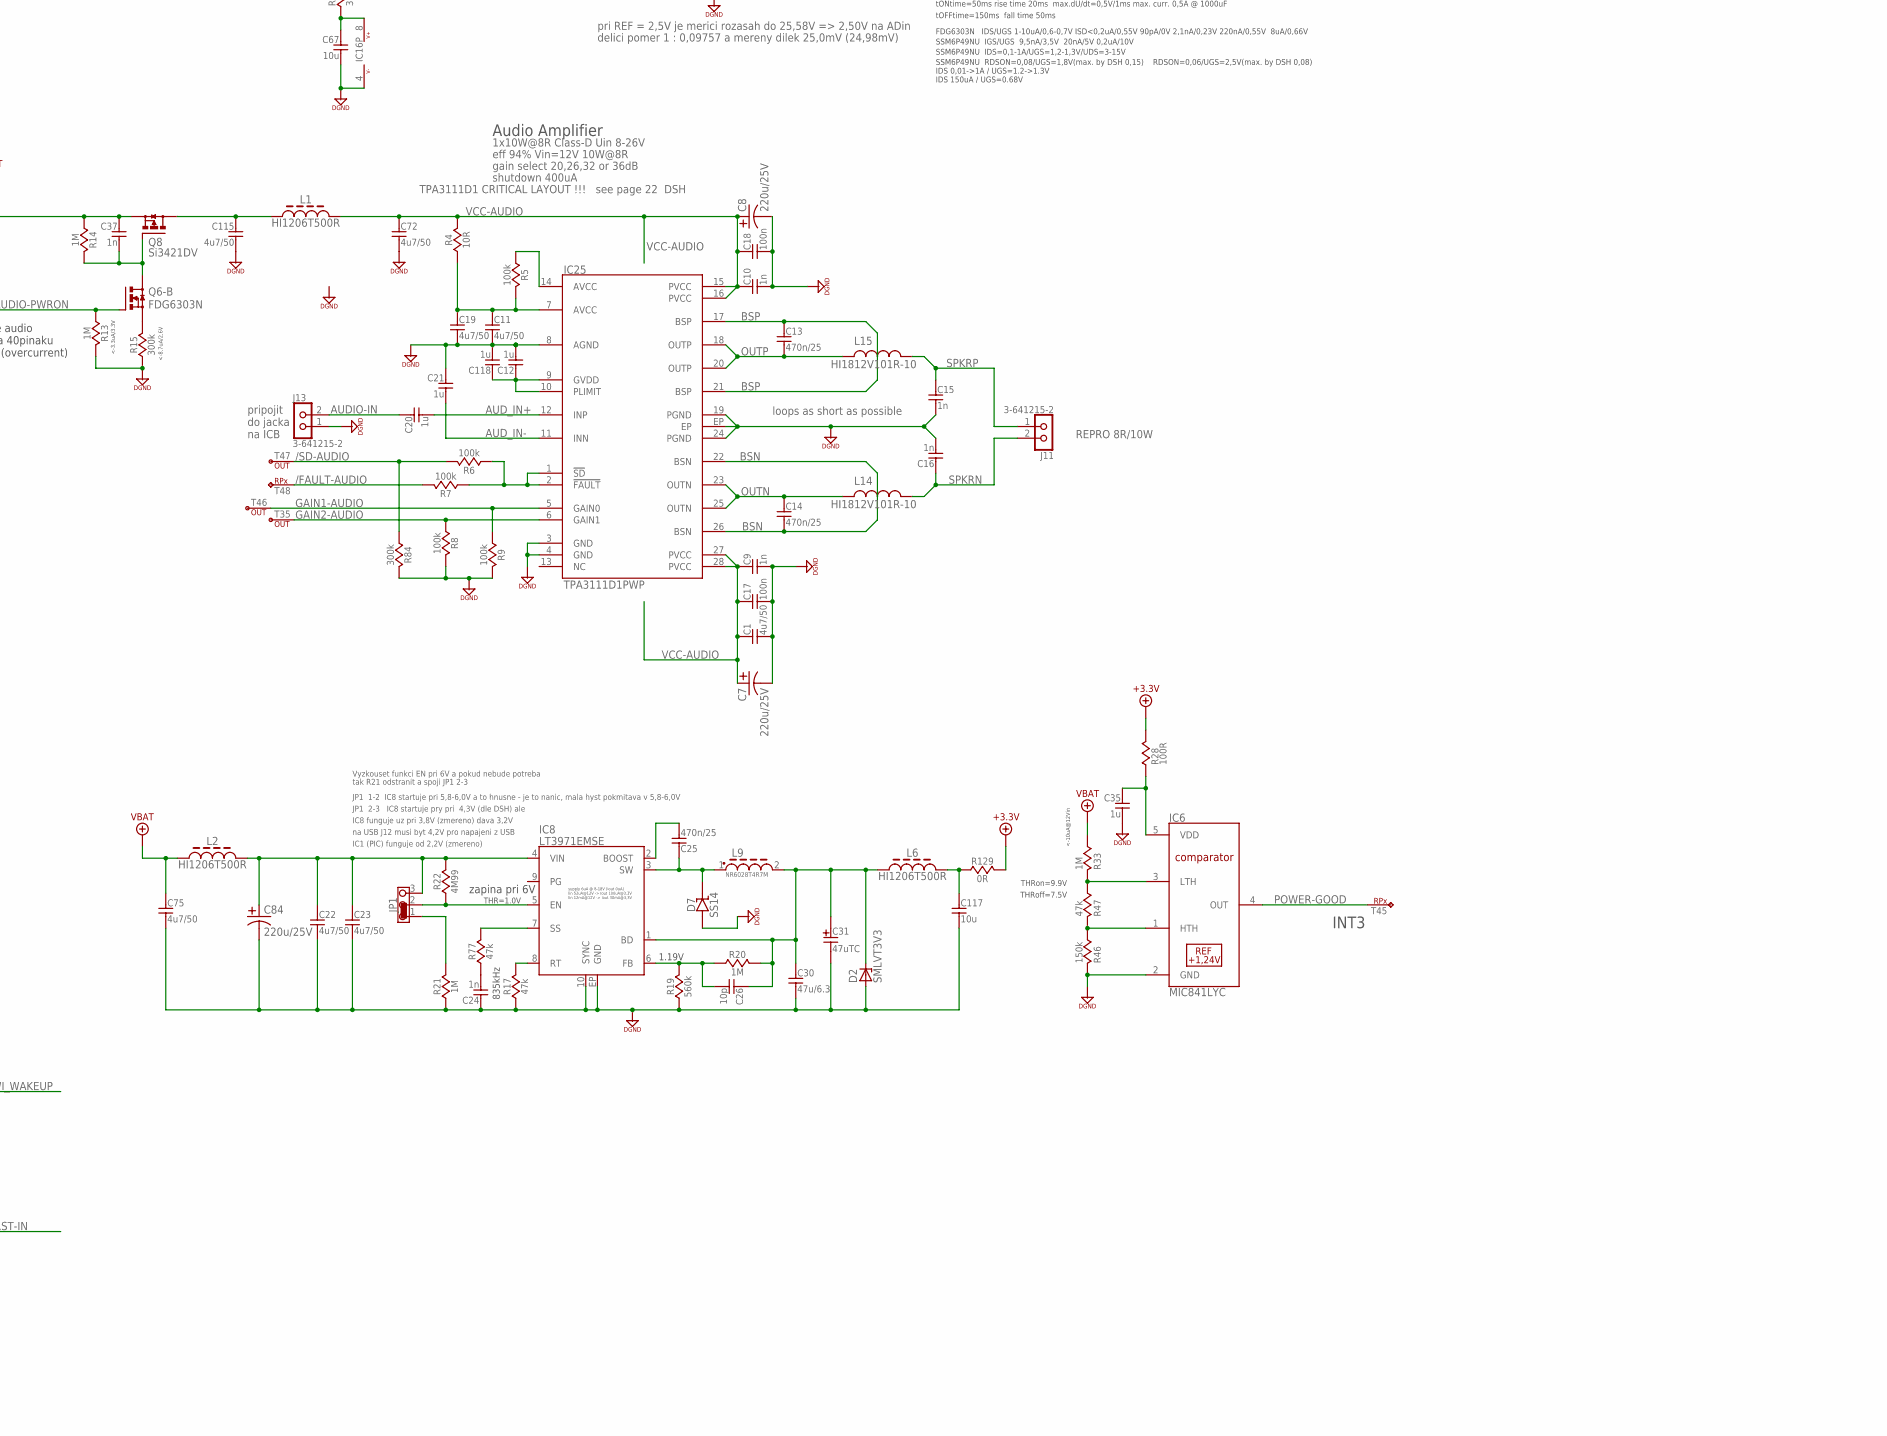
[picture p19: schematic PCB_ICBExt-R1.0-J36-CH01.sch, part in row 2, column 3]

Parts:
C1, C11, C19, C22, C23, C29, C72, C75, C99, C100, C102, C103, C110, C114, C115: 4u7/50; 1206
C2, C17, C18, C32, C33, C36, C39, C40, C41, C45, C46, C48, C50, C52, C55, C58, C59, C64, C85, C90, C91, C93, C94, C107, C111: 100n; 0603
C3, C5, C6, C27, C42, C44, C47, C49, C51, C53, C67, C77, C78, C79, C87, C88, C92, C98, C109, C116, C117: 10u; 0603
C4, C12, C20, C21, C28, C35, C97, C104, C118: 1u; 0603
C7, C8, C83, C84, C101: 220u/25V; CAP_8MM_DIA_SMT
C9, C10, C15, C16, C24, C34, C37, C43, C62, C63, C65, C68, C69, C71, C82, C105: 1n; 0603
C13, C14, C25: 470n/25; 0603
C26: 10p; 0603
C30: 47u/6.3; 1206
C31, C81, C89: 47uTC; CT-C
C38, C57, C66, C70, C73, C74, C76, C80, C95, C96, C108, C113: 10n; 0603
C54, C56, C86, C112: 10uTA; 1206-POL-C
C60, C61: 18p; 0603
C106: 220u/35V; CAP_8MM_DIA_SMT
D1, D3, D4: P6SMB20A; SMB
D2: SMLVT3V3; SMA
D5: LED-GREEN; 0805-POL-D
D6, D7, D8: SS14; SMA
F1: T2A-LITTLEFUSE0154; LITTLEFUSE0154
IC1: PIC32MX470F512L-I/PF; TQFP100_14X14_0,5MM
IC2, IC19, IC20: AHC1G08_DC/GW/SE; SC70-5,SOT353,TSSOP5
IC3: PIC10F200T-I/OT; SOT23-6
IC4, IC10: MAX9938HEUK+T; SOT23-5
IC5, IC22, IC23: AHC1G14_DC/GW/SE; SC70-5,SOT353,TSSOP5
IC6: MIC841LYC; SC-70-5
IC7, IC11: 24LC32A-I/MS; MSOP-08
IC8: LT3971EMSE; MSOP10EXP
IC9: AT25SF321-SSHD; SO-08
IC12, IC31: SN65HVD12D; SO08
IC13: REF3025; SOT23
IC14, IC15, IC26, IC27, IC28: TPD2E001DZDR; SOT-143
IC16: MCP6042-I/MS; MSOP-08
IC17: LTC1955_EUH; QFN32
IC18, IC21: AHC1G32_DC/GW/SE; SC70-5,SOT353,TSSOP5
IC24: LM75ADP; TSSOP08-3
IC25: TPA3111D1PWP; TSSOP28_EP
IC29: AT97SC3205T-U3A1C20B; TSSOP28
IC30: LT3580EMS8E; MSOP8EXP
J1: MA20-2-ICB-EXT; MA20-2
J2: CCM03-3504LFT-JK
J3, J4: RJ8-8-90-DOWN
J5: DF11-10DP-2DSA(01); DF11-10DP-2DSA
J6: 5220706; 5220706/1.LEFT
J7, J8, J18: 3-641215-3
J9: 5227110; 5227110/1.RIGHT
J10, J17: DNP-open-hole; MA05-1
J11, J13: 3-641215-2
J12: USB_B_90
J14: pin1x8; MA08-1-MALE
J15: MLW10G/T821106A1S; MLW10-5X2-PRIMY
J16, J22: 3-641215-4
J19: 796644-2(5mm); 796644-2-5MM
J20: 284512-2(3.5mm); 284512-2-3,5MM
J21: 4-641215-0
J23: MLW06G/T821106A1S; MLW06-3X2-PRIMY
JP1, JP2: JP3CLOSE12
L1, L2, L4, L5, L6, L7, L8, L10, L11, L12, L13: HI1206T500R; 1206
L3, L9: NR6028T4R7M; NR6028
L14, L15: HI1812V101R-10; L1812; MFR_PN HI1812V101R-10
O1, O2, O5, O8, O10, O11, O14, O15, O16, O18, O19, O20, O21, O22, O23, O24, O25, O26, O27, O28, O31, O32, O33, O35, O53, O59, O60: PIC-RPX; TEMP-PAD
O3, O4, O6, O7, O9, O12, O13, O17, O29, O30, O39, O40, O55, O58: PIC-OUT; TEMP-PAD
PCB1: PCB-ICBE
PCB2: DNP-PCB-ICB; PCB-ICB
PCB3: DNP-PCB-BT; BT_MODULE_BRD
Q1, Q2, Q13: SSM6P49NU,LFPZ; MICRO_FET
Q3, Q5, Q7, Q8, Q12: Si3421DV; SSOT-6
Q4, Q6, Q9, Q10, Q11: FDG6303N; SC70-6
R1, R12, R15, R40, R41, R43, R44, R54, R64, R76, R84, R121, R140: 300k; 0603
R2, R129: 0R; 0603
R3, R28, R61, R78, R79, R80, R81, R108, R109, R116, R117, R119, R132, R151, R152, R153, R154: 100R; 0603
R4, R92: 10R; 0603
R5, R6, R7, R8, R9, R24, R50, R55, R56, R57, R72, R82, R125, R142, R149, R150: 100k; 0603
R10, R11, R13, R14, R16, R20, R21, R23, R25, R31, R32, R33, R34, R42, R45, R48, R51, R65, R70, R83, R85, R88, R89, R126, R138, R139, R144, R145, R146: 1M; 0603
R17, R47, R77, R136: 47k; 0603
R18, R26, R27, R30, R53, R58, R59, R60, R71, R75, R91, R104, R107, R110, R111, R120, R128, R130, R131, R135, R137, R141, R147, R148: 10k; 0603
R19, R49, R96, R99: 560k; 0603
R22, R95, R98: 4M99; 0603
R29, R93, R103: 300R; 0603
R35, R37, R39: 0.025R; 0805
R36, R63, R66, R67, R68, R69, R74, R86, R87, R90, R102, R112, R113, R122, R123, R124: 1k; 0603
R38, R52, R105, R106, R114, R115, R127, R143: 1R; 0805
R46: 150k; 0603
R62, R73, R100, R101, R118: 2k2; 0603
R94, R97: 180k; 0603
R133: 261k; 0603
R134: 62k; 0603
REF1, REF2: REF
T1, T3, T5, T6, T8, T9, T10, T12, T16, T19, T21, T26, T28, T31, T34, T45, T48, T50, T57, T62: PIC-RPX; TEMP-PAD
T2, T4, T7, T11, T17, T18, T20, T23, T24, T25, T29, T30, T35, T46, T47, T49, T61: PIC-OUT; TEMP-PAD
TP1: DNP-TestPoint; SMD_ROUND_1MM
TP2: DNP-TestPoint; TH_ROUND_14MM08MM
X1: 8MHz-5x3.2mm; 7B

Connections:
3.3V2PWRON-ICB: J1.14 (GPIO133), Q9.5 (G)
3.3V-BT: C42.1, J14.2, R38.1
+3,3V-FILT: C35.1, IC6.5 (VDD), R28.1
+3.3V: C43.1, C47.1, C48.1, C49.1, C50.1, C51.1, C52.1, C69.1, C70.1, C81.+, C82.1, C108.1, C109.1, IC1.2 (VDD2), IC1.16 (VDD3), IC1.37 (VDD4), IC1.46 (VDD5), IC1.55 (VUSB3V3), IC1.62 (VDD6), IC1.86 (VDD1), J17.2, R3.1, R28.2, R38.2, R51.1, R52.2, R65.1, R82.1, R91.2, R92.1, R103.2, R104.1, R105.2, R106.2, R114.1, R115.2, R117.2, R126.1, R127.2, R129.1, R132.1, R142.1, R143.2
+3.3V-ULTRASONIC: C44.2, IC27.4, J16.3, Q1.6 (D), Q1.P1 (D1)
+3.3V/1: C27.1, C28.1, IC7.8 (VCC), IC9.3 (/WP), IC9.7 (/HOLD), IC9.8 (VCC), IC11.2 (A1), IC11.8 (VCC), IC24.7 (A0), IC24.8 (VCC), Q2.3 (D), Q2.P2 (D1), R18.1, R25.2, R26.1, R27.1
+3.3V/2: C41.1, C86.+, C97.2, IC2.5 (VCC), IC5.5 (VCC), IC12.8 (VCC), IC18.5 (VCC), IC21.5 (VCC), Q2.6 (D), Q2.P1 (D1), R30.2, R34.1, R55.1, R72.1
+3.3V/3: C111.1, C112.+, IC31.8 (VCC), Q13.6 (D), Q13.P1 (D1), R144.2, R149.2, R150.2
+3.3V/I2C: C87.2, IC28.4, J22.3, Q1.3 (D), Q1.P2 (D1), R130.1, R131.1
+3.3V/ICB: C80.1, C91.1, C92.1, C93.1, C95.1, C96.1, C116.1, IC19.1 (A), IC20.1 (A), IC29.3 (VCC), IC29.10 (VCC), IC29.19 (VCC), IC29.24 (VCC), J1.33 (+3.3V), J6.1, R53.2, R54.2, R110.1, R121.2, R147.1
+3.3VCCR: C78.2, J5.9, R115.1
/3.3V1PWRON: IC1.21 (AN4/C1INB/USBOEN/RB4), R24.2
/3.3V2PWRON: IC1.96 (TRD1/RG12), R60.2, R75.2
/BTN1: IC1.5 (AN27/PMD7/RE7), IC22.4 (OUT), O6.P$1, R120.2, T31.P$1
/BTN2: IC1.4 (AN23/PMD6/RE6), IC23.4 (OUT), O7.P$1, R71.2, T34.P$1
/CL_CS: IC1.38 (TCK/CTED2/RA1), J5.7, O17.P$1, T4.P$1
/FAULT-AUDIO: IC1.95 (TRD2/RG14), O3.P$1, R7.1, T48.P$1
/FMEM1-CS: IC1.11 (AN17/C1INC/RPG7/PMA4/RG7), IC9.1 (/S), R25.1
/I2C_PWRON: IC1.97 (TRD0/RG13), O29.P$1, R125.2, T7.P$1
/INT-TOUCH: J1.38 (PWM_B), J6.5
/LD_SM: IC1.61 (TDO/RA5), IC17.25 (/LD), O39.P$1, T17.P$1
/MCLR: IC1.13 (!MCLR), J17.1, R61.2, R90.2
/MCLR2: IC3.6 (GP3/MCLR), J10.1
/RESET-ICB-OUT: IC1.19 (RPE9/RE9), J1.4 (/RST-OUT), O11.P$1, T62.P$1
/RESET-TOUCH: J1.39 (PWM_C), J6.6
/RST-IN: IC29.16 (/LRESET), J1.1 (/RST-IN), Q9.6 (D), R53.1
/SD-AUDIO: IC1.94 (PMD1/RE1), O4.P$1, R6.1, R84.2, T47.P$1
/SM_FAULT: IC1.71 (RPD11/PMCS1/RD11), IC17.24 (-FAULT), O24.P$1, T21.P$1
/TWI_WAKEUP: IC29.22 (/TWI_WUP), J1.17 (GPIO97)
/USNC-PWRON: IC1.80 (PMD13/RD13), O30.P$1, R50.2, T24.P$1
A+: IC14.3, J3.4, J4.4, L8.2
A++: IC12.6 (A), L8.1, R32.2, R34.2
AUD-AVCC: C11.1, C19.1, IC25.7 (AVCC), R4.2, R5.1
AUDIO-IN: C20.1, J13.2
AUDIO-PWRON: IC1.90 (RPG0/PMD8/RG0), O14.P$1, Q6.5 (G), R13.1, T25.P$1
AUD_AMP_FAULT#: IC25.1 (!SD), IC25.2 (!FAULT), R6.2, R7.2
AUD_GVDD: C12.1, C118.1, IC25.9 (GVDD), IC25.10 (PLIMIT)
AUD_IN+: C20.2, IC25.12 (INP)
AUD_IN-: C21.2, IC25.11 (INN)
AVDD: C55.1, C56.+, C88.1, IC1.30 (AVDD), L13.2
B-: IC14.2, J3.5, J4.5, L7.2
B--: IC12.7 (B), L7.1, R31.1, R32.1
BSN: C14.2, IC25.22 (BSN), IC25.26 (BSN)
BSP: C13.1, IC25.17 (BSP), IC25.21 (BSP)
BT-RTS: IC1.83 (PMD14/RD6), J14.7
BT-RX: IC1.73 (SOSCI/RPC13/RC13), J14.3
BT-TX: IC1.74 (SOSCO/RPC14/T1CK/RC14), J14.4
CL_IRQ: IC1.39 (RPF13/RF13), J5.4, O18.P$1, T6.P$1
CON-LED: IC1.78 (AN26/RPD3/RD3), J14.6
CTL-ELMAGDISP: IC1.98 (AN20/PMD2/RE2), IC31.2 (/RE), IC31.3 (DE), O33.P$1, R148.1
CURR-ICB: C38.1, IC1.23 (PGEC3/AN2/C2INB/RPB2/CTED13/RB2), R36.2
CURR-SENSE: C66.1, IC1.14 (AN19/C2INC/RPG9/PMA2/RG9), R102.2
D+: IC1.57 (D+/RG2), IC15.3, J12.3_D+ (D+)
D-: IC1.56 (D-/RG3), IC15.2, J12.2_D- (D-)
DEBUG-RXD-A: J1.28 (RXD-A), R109.1
DEBUG-TXD-A: J1.27 (TXD-A), R108.1
DGND: C1.2, C2.2, C3.2, C5.2, C6.2, C7.2, C8.2, C9.2, C10.2, C11.2, C12.2, C15.2, C16.2, C17.2, C18.2, C19.2, C21.1, C22.2, C23.2, C24.1, C27.2, C28.2, C29.2, C30.2, C31.-, C35.2, C36.2, C38.2, C40.2, C41.2, C42.2, C44.1, C45.2, C46.2, C47.2, C48.2, C49.2, C50.2, C51.2, C52.2, C53.2, C54.-, C55.2, C56.-, C57.2, C58.2, C59.2, C60.2, C61.2, C62.2, C63.2, C64.2, C65.2, C66.2, C67.2, C68.2, C71.2, C72.2, C75.2, C76.2, C77.2, C78.1, C79.2, C81.-, C83.2, C84.2, C85.2, C86.-, C87.1, C88.2, C91.2, C92.2, C93.2, C94.2, C95.2, C96.2, C97.1, C98.2, C99.2, C100.2, C101.2, C102.2, C103.2, C104.2, C105.2, C106.2, C109.2, C110.2, C111.2, C112.-, C113.2, C114.2, C115.2, C116.2, C117.2, C118.2, D1.A, D2.- (A), D5.K, D7.A, IC1.15 (VSS2), IC1.31 (AVSS), IC1.36 (VSS3), IC1.45 (VSS4), IC1.65 (VSS5), IC1.75 (VSS1), IC2.3 (GND), IC3.2 (VSS), IC4.1 (GND), IC4.2 (GND1), IC5.3 (GND), IC6.2 (GND), IC7.1 (A0), IC7.2 (A1), IC7.3 (A2), IC7.4 (GND), IC7.7 (WP), IC8.10 (SYNC), IC8.EP (GND), IC9.4 (GND), IC10.1 (GND), IC10.2 (GND1), IC11.1 (A0), IC11.3 (A2), IC11.4 (GND), IC12.5 (GND), IC13.3 (GND), IC15.1, IC16.4 (V-), IC17.9 (SGND), IC17.10 (PGND), IC17.21 (PRESB), IC17.PAD, IC18.3 (GND), IC19.3 (GND), IC20.3 (GND), IC21.3 (GND), IC22.3 (GND), IC23.3 (GND), IC24.4 (GND), IC24.5 (A2), IC24.6 (A1), IC25.3 (GND), IC25.4 (GND), IC25.8 (AGND), IC25.19 (PGND), IC25.24 (PGND), IC25.EP, IC26.1, IC27.1, IC28.1, IC29.4 (GND), IC29.8 (TESTL), IC29.9 (TESTBI/GPIO/XT), IC29.11 (GND), IC29.17 (GPIO), IC29.18 (GND), IC29.20 (/PIRQ), IC29.21 (ATEST), IC29.23 (ATEST), IC29.25 (GND), IC29.26 (ATEST), IC30.8 (SYNC), IC30.EP (GND), IC31.5 (GND), J1.2 (GND1), J1.3 (GND2), J1.7 (GND3), J1.21 (GND4), J1.36 (GND5), J2.C5 (C5/GND), J5.1, J6.2, J9.7, J9.8, J10.3, J12.4_GND (GND), J12.SH1 (GND_SH1), J12.SH2 (GND_SH2), J13.1, J14.1, J15.7, J15.8, J16.4, J17.3, J18.1, J19.1, J20.1, J21.7, J21.8, J22.4, J23.5, J23.6, L12.1, PCB1.1, PCB1.2, PCB1.4, PCB3.1, Q9.1 (S), Q9.4 (S), Q10.1 (S), Q10.4 (S), R2.2, R8.1, R9.1, R10.2, R12.1, R13.2, R15.1, R17.2, R19.2, R21.2, R31.2, R40.1, R41.2, R43.1, R44.2, R46.1, R48.1, R56.1, R57.1, R63.2, R70.1, R74.2, R83.1, R84.1, R85.1, R88.1, R89.1, R96.2, R99.2, R136.2, R137.2, R138.2, R140.1, R141.1, R146.1, R148.2
DGND-F: C39.2, D3.A, D4.A, IC14.1, J3.2, J3.7, J3.8, J4.2, J4.7, J4.8, L12.2
DIN_SM: IC1.60 (TDI/CTED9/RA4), IC17.27 (DIN), O40.P$1, T20.P$1
DOUT_SM: IC1.79 (RPD12/PMD12/RD12), IC17.28 (DOUT), O27.P$1, T19.P$1
ELMAGDI-PWRON: IC1.100 (AN21/PMD4/RE4), O32.P$1, Q11.2 (G), Q11.5 (G), R138.1
EN-SENSE+3.3V/ICB: C74.2, IC1.35 (AN11/PMA12/RB11), R111.1
EN-UTRASONIC: IC1.81 (RPD4/PMWR/RD4), O22.P$1, R153.1, T23.P$1
GAIN1-AUDIO: IC1.93 (PMD0/RE0), IC25.5 (GAIN0), O9.P$1, R9.2, T46.P$1
GAIN2-AUDIO: IC1.92 (TRD3/CTED8/RA7), IC25.6 (GAIN1), O12.P$1, R8.2, T35.P$1
GATE-Q1: C107.2, Q11.6 (D), Q12.3 (G), R139.2
GATE-Q3: C33.2, Q3.3 (G), Q4.6 (D), R42.2
GATE-Q5: C34.2, Q4.3 (D), Q5.3 (G), R45.2
GATE-Q7: C32.2, Q6.6 (D), Q7.3 (G), R11.2
GATE-Q8: C37.2, Q6.3 (D), Q8.3 (G), R14.2
GPIO1: IC1.32 (AN8/RPB8/CTED10/RB8), O59.P$1, R86.1, T49.P$1
GPIO1_: J1.13 (GPIO98), R112.2
GPIO2: IC1.33 (AN9/RPB9/CTED4/RB9), O60.P$1, R87.1, T50.P$1
GPIO2_: J1.15 (GPIO103), R113.2
I2C-SCL-TOUCH: IC29.2 (SM_CLK), J1.6 (I2C-SCL), J6.3
I2C-SDA-TOUCH: IC29.1 (SM_DAT), J1.5 (I2C-SDA), J6.4
ICB-ON: IC1.91 (TRCLK/RA6), O13.P$1, Q6.2 (G), R10.1, R16.2, T2.P$1
ILLUMINATE1: IC1.99 (RPE3/PMD3/RE3), O8.P$1, R116.1, T29.P$1
ILLUMINATE2: IC1.3 (AN22/RPE5/PMD5/RE5), O1.P$1, R119.1, T30.P$1
LAN-CTL: IC12.2 (/RE), IC12.3 (DE), IC21.4 (Y)
LAN-CTL-ICB: IC21.1 (A), J1.16 (GPIO101), R57.2
LAN-CTL-PIC: IC1.84 (PMD15/RD7), IC21.2 (B), R56.2
LAN-RX: IC1.88 (RPF1/PMD10/RF1), IC12.1 (R), IC19.2 (B), R72.2
LAN-RX-ICB: IC19.4 (Y), J1.31 (RXD-B)
LAN-TX: IC2.4 (Y), IC12.4 (D)
LAN-TX-ICB: J1.32 (TXD-B), R54.1, R122.1
LAN-TX-PIC: IC1.87 (RPF0/PMD11/RF0), IC2.1 (A), R55.2
LED-PIC: IC1.1 (RG15), R29.1, TP2.P$1
unnamed: C4.1, IC17.11 (C-)
unnamed: C5.1, IC17.15 (CPO)
unnamed: C4.2, IC17.14 (C+)
unnamed: IC17.23 (-UNDERV), R1.1
unnamed: IC5.4 (OUT), IC18.1 (A)
unnamed: IC2.2 (B), IC18.4 (Y)
unnamed: Q9.3 (D), R60.1
unnamed: IC3.4 (GP2/T0CK), R61.1
unnamed: C43.2, Q1.2 (G), R50.1, R51.2
unnamed: IC25.14 (AVCC), R5.2
unnamed: IC11.7 (WP), R18.2, TP1.P$1
unnamed: D5.A, R29.2
unnamed: Q4.1 (S), R40.2
unnamed: Q4.4 (S), R43.2
unnamed: C39.1, IC14.4, R30.1
unnamed: F1.1, J19.2
unnamed: J20.2, Q7.1 (D), Q7.2 (D), Q7.5 (D), Q7.6 (D)
unnamed: Q6.1 (S), R12.2
unnamed: L13.1, R92.2
unnamed: IC17.22 (NC/-NO), R2.1
unnamed: Q6.4 (S), R15.2
unnamed: IC6.1 (HTH), R46.2, R47.1
unnamed: IC6.3 (LTH), R33.1, R47.2
unnamed: Q1.1 (S), R52.1
unnamed: C115.1, L1.1, Q8.1 (D), Q8.2 (D), Q8.5 (D), Q8.6 (D)
unnamed: R62.2, R63.1, R64.2
unnamed: C61.1, IC1.64 (CLKO/RC15/OSC2), X1.1
unnamed: C80.2, IC5.2 (IN), R121.1
unnamed: C22.1, C23.1, C84.1, IC8.4 (VIN), JP1.3, L2.2, R22.1
unnamed: C45.1, IC22.2 (IN), R64.1
unnamed: Q2.1 (S), R106.1
unnamed: IC4.3 (OUT), R36.1
unnamed: R73.2, R74.1, R76.2
unnamed: C60.1, IC1.63 (CLKI/RC12/OSC1), X1.3 (2)
unnamed: C32.1, C107.1, IC4.4 (VIN-), Q7.4 (S), Q12.4 (S), R11.1, R16.1, R35.1, R37.1, R139.1
unnamed: R66.1, R67.1, R68.2, R69.2
unnamed: C46.1, IC23.2 (IN), R76.1
unnamed: C6.1, IC3.5 (VDD), J10.2, R3.2
unnamed: C58.1, C59.1, IC13.1 (VIN), R93.2
unnamed: Q10.6 (D), R68.1, R69.1
unnamed: J7.2, R66.2, R67.2
unnamed: J7.3, R62.1
unnamed: R94.2, R95.1
unnamed: C62.1, IC16.3 (+IN), R95.2, R96.1
unnamed: C26.2, IC8.6 (FB), R19.1, R20.2
unnamed: C24.2, R77.2
unnamed: C25.1, D7.K, IC8.3 (SW), L9.1
unnamed: IC8.8 (RT), R17.1
unnamed: IC8.7 (SS), R77.1
unnamed: IC8.5 (EN), JP1.2, R22.2
unnamed: Q2.4 (S), R105.1
unnamed: C25.2, IC8.2 (BOOST)
unnamed: C89.+, C90.1, JP2.2
unnamed: C117.1, L6.2, R129.2
unnamed: R97.2, R98.1
unnamed: Q10.3 (D), R80.1, R81.1
unnamed: R23.1, R49.2
unnamed: C63.1, IC16.5 (+IN), R98.2, R99.1
unnamed: IC16.6 (-IN), IC16.7 (OUT), R100.2
unnamed: C67.1, IC16.8 (V+), R103.1
unnamed: IC16.1 (OUT), IC16.2 (-IN), R101.2
unnamed: C69.2, Q2.5 (G), R24.1, R65.2
unnamed: IC10.3 (OUT), R102.1
unnamed: C98.1, IC19.5 (VCC), IC20.5 (VCC), R132.2
unnamed: C40.1, R90.1, R91.1
unnamed: J8.3, R73.1
unnamed: C82.2, Q1.5 (G), R125.1, R126.2
unnamed: C70.2, Q2.2 (G), R75.1, R82.2
unnamed: Q1.4 (S), R127.1
unnamed: Q11.1 (S), R140.2
unnamed: C104.1, IC30.7 (SS)
unnamed: C113.1, IC30.5 (/SHDN), R134.2, R137.1
unnamed: J8.2, R78.2, R79.2
unnamed: C89.-, C90.2, R78.1, R79.1, R80.2, R81.2
unnamed: J1.34 (RXD-C), R123.1
unnamed: IC30.2 (VC), R135.1
unnamed: C85.1, D6.A, IC15.4, J12.1_+5V (+5V), R128.1
unnamed: C94.1, IC26.4, R147.2
unnamed: JP1.1, R21.1
unnamed: IC30.6 (RT), R136.1
unnamed: C105.1, R135.2
unnamed: D8.A, IC30.4 (SW), L3.2
unnamed: C99.1, C100.1, C101.1, IC30.3 (VIN), L3.1, L4.2, R134.1
unnamed: IC30.1 (FB), R133.2
unnamed: C102.1, C103.1, C106.1, D8.K, L5.1, R133.1
unnamed: C73.2, IC1.47 (RPD14/RD14), R107.2
unnamed: C114.1, L4.1, Q12.1 (D), Q12.2 (D), Q12.5 (D), Q12.6 (D)
unnamed: C108.2, Q11.3 (D), Q13.2 (G), R142.2
unnamed: Q13.1 (S), R143.1
unnamed: C110.1, J23.1, J23.2, L5.2
unnamed: Q11.4 (S), R141.2
unnamed: IC31.6 (A), J23.4, R144.1, R145.2
unnamed: J1.35 (TXD-C), R124.2
unnamed: IC31.7 (B), J23.3, R145.1, R146.2
unnamed: IC28.2, J22.1, R152.2
unnamed: IC26.2, J18.2, R109.2
unnamed: IC26.3, J18.3, R108.2
unnamed: C71.1, R87.2, R89.2, R113.1
unnamed: C68.1, R86.2, R88.2, R112.1
unnamed: IC28.3, J22.2, R151.2
unnamed: C2.1, C3.1, C77.1, IC17.1 (DVCC), IC17.12 (SVBAT), IC17.13 (PVBAT), R1.2, R114.2
unnamed: Q10.2 (G), R70.2, R116.2
unnamed: C79.1, IC22.5 (VCC), IC23.5 (VCC), R117.1
unnamed: Q10.5 (G), R83.2, R119.2
unnamed: IC18.2 (B), R122.2
unnamed: IC27.2, J16.1, R153.2
unnamed: IC27.3, J16.2, R154.2
OUT+3.3V: C26.1, C30.1, C31.+, D2.+ (C), IC8.1 (BD), L6.1, L9.2, R20.1
OUTN: C14.1, IC25.23 (OUTN), IC25.25 (OUTN), L14.2
OUTP: C13.2, IC25.18 (OUTP), IC25.20 (OUTP), L15.2
PGC: IC1.24 (PGEC1/AN1/RPB1/CTED12/RB1), J17.5
PGC2-/BTN2: IC3.3 (GP1/PGC), J10.5, R71.1
PGD: IC1.25 (PGED1/AN0/RPB0/RB0), J17.4
PGD2-/BTN1: IC3.1 (GP0/PGD), J10.4, R120.1
PIC-RXD: IC1.6 (RPC1/RC1), O2.P$1, R124.1, T26.P$1
PIC-TX: IC1.9 (RPC4/CTED7/RC4), O5.P$1, R123.2, T28.P$1
POWER-GOOD: IC1.89 (RPG1/PMD9/RG1), IC6.4 (OUT), O15.P$1, T45.P$1
REF2,5V: C57.1, IC1.29 (VREF+/CVREF+/PMA6/RA10), IC13.2 (VOUT)
REF-EN: IC1.28 (VREF-/CVREF-/PMA7/RA9), R93.1
RESET-ICB: IC1.18 (RPE8/RE8), O10.P$1, Q9.2 (G), R85.2, T61.P$1
RXD-ELMAGDISP: IC1.7 (RPC2/RC2), IC31.1 (R), O23.P$1, R150.1
RXD-ULTRASONIC: IC1.82 (RPD5/PMRD/RD5), O16.P$1, R154.1, T3.P$1
SCL1-EEPROM: IC1.66 (SCL1/RPA14/RA14), IC7.6 (SCL), IC11.6 (SCL), IC24.2 (SCL), R26.2
SCL2: IC1.58 (SCL2/RA2), O28.P$1, R130.2, R152.1, T5.P$1
SCLK1: IC1.70 (RPD10/SCK1/PMCS2/RD10), J5.5
SCLK2-SPI: IC1.10 (AN16/C1IND/RPG6/SCK2/PMA5/RG6), IC9.6 (C)
SCLK_SM: IC1.76 (AN24/RPD1/RD1), IC17.26 (SCLK), O35.P$1, T18.P$1
SDA1-EEPROM: IC1.67 (SDA1/RPA15/RA15), IC7.5 (SDA), IC11.5 (SDA), IC24.1 (SDA), R27.2
SDA2: IC1.59 (SDA2/RA3), O19.P$1, R131.2, R151.1, T1.P$1
SDI1: IC1.50 (RPF5/PMA8/RF5), J5.8, O21.P$1, T9.P$1
SDI2-MISO: IC1.22 (PGED3/AN3/C2INA/RPB3/RB3), IC9.2 (Q)
SDO1: IC1.48 (RPD15/RD15), J5.6, O58.P$1, T8.P$1
SDO2-MOSI: IC1.20 (AN5/C1INA/RPB5/RB5), IC9.5 (D)
SENSE+3.3V: C73.1, IC1.44 (AN15/RPB15/PMA0/CTED6//RB15), R104.2, R107.1
SENSE+3.3V/ICB: C74.1, IC1.34 (CVREFOUT/AN10/RPB10/PMA13/CTED11/RB10), R110.2, R111.2
SIM-CLK: IC17.18 (CLKB), J2.C3 (CLK/C3)
SIM-IO: IC17.20 (IOB), J2.C7 (C7/DATA)
SIM-RST: IC17.19 (RSTB), J2.C2 (RST/C2)
SIM-VCC: IC17.17 (VCCB), J2.C1 (VCC/C1)
SM_ASYNC: IC1.49 (RPF4/PMA9/RF4), IC17.31 (ASYNC), O20.P$1, T57.P$1
SM_C4A: IC17.4 (C4A), J9.2, J15.2, J21.2
SM_C8A: IC17.3 (C8A), J9.1, J15.1, J21.1
SM_CLK_A: IC17.7 (CLKA), J9.4, J15.4, J21.4
SM_DATA: IC1.68 (RPD8/RTCC/RD8), IC1.69 (RPD9/RD9), IC17.29 (DATA), O25.P$1, O26.P$1, T12.P$1, T16.P$1
SM_DET_A: IC17.2 (PRESA), J9.10, J15.10, J21.10
SM_IO_A: IC17.5 (IOA), J9.3, J15.3, J21.3
SM_RST: IC1.42 (AN13/RB13), IC17.30 (RIN), O55.P$1, T11.P$1
SM_RST_A: IC17.6 (RSTA), J9.6, J15.6, J21.6
SM_SYNC: IC1.43 (AN14/RPB14/PMA1/CTED5/RB14), IC17.32 (SYNC), O53.P$1, T10.P$1
SM_VCC_A: IC17.8 (VCCA), J9.9, J15.9, J21.9
SPKRN: C16.1, J11.2, L14.1
SPKRP: C15.1, J11.1, L15.1
TXD-ELMAGDISP: IC1.8 (RPC3/RC3), IC31.4 (D), O31.P$1, R149.1
VBAT: C33.1, C37.1, C75.1, IC10.4 (VIN-), J7.1, J8.1, JP2.1, L2.1, Q3.4 (S), Q8.4 (S), R14.1, R33.2, R39.1, R42.1, R97.1
VBAT-LAN: D3.C, J3.1, J3.3, J4.1, J4.3, L11.2
VBAT-LAN-F: C34.1, D6.K, L11.1, Q3.1 (D), Q3.2 (D), Q3.5 (D), Q3.6 (D), Q5.4 (S), R45.1, R94.1
VBAT-POJ: C29.1, C83.1, D1.C, F1.2, IC4.5 (VIN+), IC10.5 (VIN+), R35.2, R37.2, R39.2
VBAT-SENSE: C64.1, IC1.26 (PGEC2/AN6/RPB6/RB6), R100.1
VBAT-TO-LAN: IC1.52 (RPF2/RF2), Q4.2 (G), R41.1, R59.1
VBAT-TO-LAN-ICB: J1.18 (GPIO85), R59.2
VBATLAN-SENSE: C36.1, IC1.27 (PGED2/AN7/RPB7/CTED3/RB7), R101.1
VBUS: IC1.54 (VBUS), R128.2
VCAP: C53.1, C54.+, IC1.85 (VCAP), R118.2
VCAP-SENSE: C76.1, IC1.77 (AN25/RPD2/RD2), R118.1
VCC-AUDIO: C1.1, C7.1, C8.1, C9.1, C10.1, C17.1, C18.1, C72.1, IC25.15 (PVCC), IC25.16 (PVCC), IC25.27 (PVCC), IC25.28 (PVCC), L1.2, R4.1
VPS-ON: IC1.53 (RPF8/RF8), Q4.5 (G), R44.1, R58.1
VPS-ON-ICB: J1.20 (GPIO45), R58.2
VPS-PWR: D4.C, J3.6, J4.6, L10.2
VPS-PWR-F: L10.1, Q5.1 (D), Q5.2 (D), Q5.5 (D), Q5.6 (D), R23.2
VPS-SENSE: C65.1, IC1.12 (AN18/C2IND/RPG8/PMA3/RG8), IC20.2 (B), R48.2, R49.1
VPS-SENSE-ICB: IC20.4 (Y), J1.19 (GPIO79)
WAKE-SW: IC1.72 (RPD0/INT0/RD0), J14.5

Notes on the sheet:
MB v5.91 M25P16-VMN6P - obsolete
MB v5.92 N25Q032A13ESC obsolete
THRon=9.9V
THRoff=7.5V
<-8,7uA/2,6V
Ugs=0,64V
<-5uA/13V
<-11uA/3.3V
tau=0,61ms 1n/0,6M
Chce se pouzit 4 clankovy LiFEPO nominal 12,8V (4x3.2) bezne nabijeni max. 14,8V (4x3.7V) pocatecni iniciacini napijeni 16,0 nebo 16,8 (4x 4,0 nebo 4.2V) vrcho je tedy stejny jako u Lion
Transil P6SMB16A standoff 13.6V breakdown 15.2-16.8V/1mA max power 22.5V/27A - NELZE POUZIT s 4 clankovym LIFEPO
Transil P6SMB20A standoff 17.1V breakdown 19-21V/1mA max power 27,7V/22A
FDG6303N IDS/UGS 1-10uA/0,6-0,7V ISD<0,2uA/0,55V 90pA/0V 2,1nA/0,23V 220nA/0,55V 8uA/0,66V
SSM6P49NU IGS/UGS 9,5nA/3,5V 20nA/5V 0,2uA/10V
SSM6P49NU IDS=0,1-1A/UGS=1,2-1,3V/UDS=3-15V
SSM6P49NU RDSON=0,08/UGS=1,8V(max. by DSH 0,15) RDSON=0,06/UGS=2,5V(max. by DSH 0,08)
tONtime=50ms rise time 20ms max.dU/dt=0,5V/1ms max. curr. 0,5A @ 1000uF
tOFFtime=150ms fall time 50ms
1M/100nF/300k:
IDS 150uA / UGS=0.68V
IDS 0,01->1A / UGS=1.2->1.3V
ratio 1:100 supply curr 1uA out imp 10k
2,5V@1A (0,025R)
AT25SF321-SSHD
MX25R3235FM1IH0
IS25LQ032B-JNLE
FLASH SPI SO08(150mil) 32Mb
6.6.2017 found:
VBAT nom = 12.8V
835kHz
1.19V
THR=1.0V
Poznamky 2xUSB:
nebo zde pouzity co dela 3.3V zmenit na 5V a za nej lin.stab na 3.3V TLV73333 3.3V/0.3A
5) Zdroj 5V/0.5A bud druhy LT3971EMSE +5V z VBAT zapinatelny (1 vystup)
a pripadne tento 5V udelat prepinatelny na 3,6V kdyz se nepouziva USB, aby se zvysila ucinnost (2vystupy)
2) Prepinac 1USB na 2USB TS3USB221, je udelany ACB.lbr, 1-2 vystupu: volba kanalu, prip OE USB
3) 2x ESD ochrana TPD2E001, pouzit na LAN-RS485, pouzdro jako SR3.3 semtech.lbr
6) 2x zapinač napajení tzn. 2x P-FET ovladany z PICa - 2 vystupy
1) Na PICovi vystupy D+/D- (RG2/RG3) a vstup VBUS a sprvane zapojit napajeni VUSB3V
4) 2x konektor USB udelan v ACB.lbr a na nej je potřeba 2x 5V/0,5A
eventulne by slo prepina na 3,3V a lin stab vyblokovavat coz je nebezpecne (3vystupy) a nema moc smysl
Pro potřeby USB zabrat vyhradit a neobsadit RG2,RG3, VBUS
Pro potřeby ovladani max. 6 vystupu, EN zdroje a OE USB prepinace lze spojit
Power Consuption
50mA/100Mhz
5mA/10Mhz
0,1mA/31kHz LPRC
Ještě je otázka jestli by TLV73333 s maximem 0,3A stačilo na všechno na 3,3V (PIC 50mA kamera? VPS? RS485 10-30mA)
lze spojit volic kanalů a jeden gate tranzisdoru zapinajiho +5V (tim padem 4 vystupy)
pridanim N-FETu se na signal volby kanalu by stento mohl ovlada P-fef +5V (jen 3vystupy)
pokud mozno
tau=0,22ms
stabilization <0,1% 5ms
tau=0,11ms
stabilization <0,1% 0,8ms
<-2.5uA
<-1uA
TP1 musi byt pristupny pri testovani desky
neobsazovat USB
R delic a C a OAMP musi byt pohromade
kond u PICA
VPS-SENSE dat na AN+RP
Bluetooth modul
extention
Petr chce BT z +3.3V
Z USB pres diodu step down sotva funguje
BT ma 5 I/O, TX a RX nutne na RPxx I/O, WAKE a RTS na OUT, CON_LED je IN na RPxx
pri REF = 2,5V je merici rozasah do 25,58V => 2,50V na ADin
delici pomer 1 : 0,09757 a mereny dilek 25,0mV (24,98mV)
INTx
OC1,2
WAKEUP
PSRR 25dB@10kHz
PSRR 65dB@100Hz
PSRR 45dB@1kHz
PSRR 5dB@100kHz
300R 0,2uF+ REF3025 30-40dB -> odfiltruje AC az +/-0.1V -> +/-1mV na 2.5V
tlumivka do serie s 300R nema smysl
musela by byt aspon 100uH aby se projevila na 100kHz
REF3025
prechodovy dej po velke zmene odberu 0->5mA
se zatezi 0,01-1uF dozni po max. 100us dle DSH
Iquesc=42uA
7dB@1kHz
utlum 10R 20uF RC=0,2ms
42dB@100kHz
22dB@10kHz
62dB@1MHz
starup 0V->3,25V(-0,05V) 1ms
Udaje o PSRR ADC PIC nejsou
Melo by byt >60dB@1kHz >40dB@10kHz a >20dB@100kHz
tlumivka 3.3uH je jen pro pocit
60dB s 20uF udela az na 0,8Mhz
a vyznamnejsi nez 10R se stava az nad 3Mhz
20uF pri odberu 5mA udrzi 10us pokles napeti pod 1:1000 (60dB)
20uF s L=3,3uH 1R<R<3R 60dB pro 800kHz
rozsah do 25,6V ->2,50V
merici krok na ADC 25,0mV
U4RX
INT3,AN18
AN19,INT1
U1RX
U4TX
INT2
PWM OC5
OC3
AN6
AN7
SDI1,2 SDO1,2 INT4
neni RP->
pokud R=3R pak 3uH a 20uF staci pri >500kBps
Utlumy JEN VYPOCTY - NEOVERENO!
R>=1R zachovat vzdy!
AVDD max. +/-0.3V od VDD
4,5mV
INT4
U3TX
U3RX
U2RX
U2TX
JP1 1-2 IC8 startuje pri 5,8-6,0V a to hnusne - je to nanic, mala hyst pokmitava v 5,8-6,0V
JP1 2-3 IC8 startuje pry pri 4,3V (dle DSH) ale
Vyzkouset funkci EN pri 6V a pokud nebude potreba
tak R21 odstranit a spoji JP1 2-3
Pri napajeni z USB spojit na JP1 2-3 !!!
zatez 10uF na desce
SRAM,2xEEPROM,LATCHe 0,5uA
spinani 100us pri 10uF+22R zatezi
max. dU/dT=1V/30us na 10uF => 300mA
spinani 100us pri 10uF
IC12 RS485 odber cca 5mA
IC8 funguje uz pri 3,8V (zmereno) dava 3,2V
IC1 (PIC) funguje od 2,2V (zmereno)
na USB J12 musi byt 4,2V pro napajeni z USB
vlastni odber 40uA (zmereno)
Doba ustaleni 2.5V je 250us (zmereno) se zatezi 0,22mA (ADC ON)
0,22mA
0,45mA
RC 10R 20uF = 200us overeno merenim
RC 300R 200nF cca 60us overeno merenim
66mV
prechodovy pri ADON,REFEN=0->1 cca 250us
tzn. pri odberu cca 0,22mA
V datshitu DS60001185F-page 318 je uvedeno, ze AN15-AN27 jsou takove.... na hovno.... CURR-SENSE je na AN19...
1dB@100Hz
utlum 300R 0,2uF RC=0,6ms
11dB@10kHz
3dB@1kHz
31dB@100kHz
starup 0V->2,7V 1ms
tedy nema smysl vypinat
C5 U>5.35V
Contactless Card Reader (DockReader20) ATTENTION! crossover cable necessary!! connection 1-9 3-7 5-5 2-10 4-8 6-6 as well as between G5 MB and RF TOP
HOPT+SCHULER
diferencialni odpor mezi A-B je tedy cca 400k to odpovídá změřeným 0,42V s 3x1M
dle mereni spotreba 4,4mA - kdyz /RE=DE=0 je aktivni, nebudi linku a posloucha R=3,3V A>B R=0V A<B
dle mereni pri tomto zapojeni A,B na delic 1M-1M-1M je v klidu diferencni napeti 0,42V
spojeni /RE a DE ma impedanci cca 90k-150k -> pull down <20k, napeti je 0,84V a chova se to jako low ale je to nespolehlive!
spojeni /RE a DE je pekna prasarnicka dle DSH je jeden pull up 100k a druhy pull down 100k
dle mereni spotreba 9,3mA - kdyz /RE=DE=1 je aktivni a budi linku A/B podle D
pri mereni zjistuji napeti 0,84V - oh shit nedefin 0.8-2.0V, 100k k GND 0,45V, 100k na +3,3V 2,32V
dle mereni je D pullupovane cca 90-150k - neni nutny ext. pull up, kdyz D=1 tak B=0V a A=3,3V
kdyz /RE=0 a B<A tak R=3.3V imp cca 30R, kdyz /RE=1 tak R je Hiz je vhodne pull up
dle DSH maji A, B vstupni odpor 180k do zdroje 1,6V s impedanci 18k (delic 36k/36k)
na A=2,01V na B=1,59V pri VCC=3,30V
dle DSH A,B funguji v rozsahu +12V/-7V, RS486 terminator 110R, differ. imp 54R 50pF
to mereni napeti VBAT na LAN je celkem zbytecne na co by to slo pouzit? na +5V ICB?
TOUCH PANEL
2x TLACITKO + 2x POSVETLENI LED/OSVETLENI zapinatelne/PWM z VBAT prvni podsvetleni ma limit cca 10mA druhe cca 100mA (pro VBAT 12V a UF 2V)
Audio Amplifier
eff 94% Vin=12V 10W@8R
gain select 20,26,32 or 36dB
shutdown 400uA
1x10W@8R Class-D Uin 8-26V
TPA3111D1 CRITICAL LAYOUT !!! see page 22 DSH
loops as short as possible
RESET PIC jako na MB
30sec zmacknutim BTNx se ma PIC32 vyresetovat
UART jednodratove - spojene TX a RX dat na kterekoliv dva RP a ty pak fyzicky spojit nebo jen na jednu nohu B14 B6 C2 D0 D1 D5 D8 E8 F13 F2 F3 G9 (UART5) nebo nohu B2 (UART4) na kterych lze zaraz namapovat oba TX a RX
<-6uA/12V
<-3.3uA/3.3V
pripojit do jacka na ICB
na ACB jina funkce
pokud mozno neobsazovat USB
<-10uA@12Vin
CURR-SENSE dat na AN+RP
2,5V@2A (0,0125R)
CURR-ICB dat na AN+RP
Napajeni ICB IRIS
R16 zajistuje ze pokud PIC32 nejede tak ICB je napajeno chtel to Petr
na DockReader20 je pullup takze zde neni potreba
Na G5 MB a Kiosk je tento konektor na SPI2 a FLASH na SPI1, tady je to naopak
Na G5 MB a Kiosk je tato flaska na SPI1 tady je na SPI2 protoze je tak na ACB kde to tak musi byt protoze SPI1 je nepouzitelna
VSOLAR na MB a na RFTOP
VBAT na MB59x BATB na MB55-58
SCLK1 neni mapovatelne a musi na RD10 byt
INT2 sdileni s CURR-ICB teoreticky staci na CNx (vsechny piny PIC jsou CNx)
pro UART5 je mnoho moznosti jak namapovat TX a RX (obe funkce) na jednu nohu, pro UART5 jsou tyto moznosti B14 B6 C2 D0 D1 D5 D8 E8 F13 F2 F3 G9 pro UART4 toto je mozne jen u B2 pro UART1,2,3 nelze TX a RX dat na jednu nohu
ULTRASONIC SENSOR HRXL-MaxSonar-WR ultrazvukove cidlo vzdalenosti/pritomnosti cloveka bude se zapinat kazdou sekundu na asi 50ms cidlo ma 7 signalu, ale jen 4 potrebujeme (pin4-7) GND, napajeni, seriova RX data a Enable nebo obecny seriovy port TX/RX a vypinatelny 3.3V
