alleybeachelectric/Gen6/CONSOLE/rev1.0/PCB_ICBExt-R1.0-J36-CH01.brd

## EAGLE design CONSOLE/rev1.0/PCB_ICBExt-R1.0-J36-CH01.brd (continued)

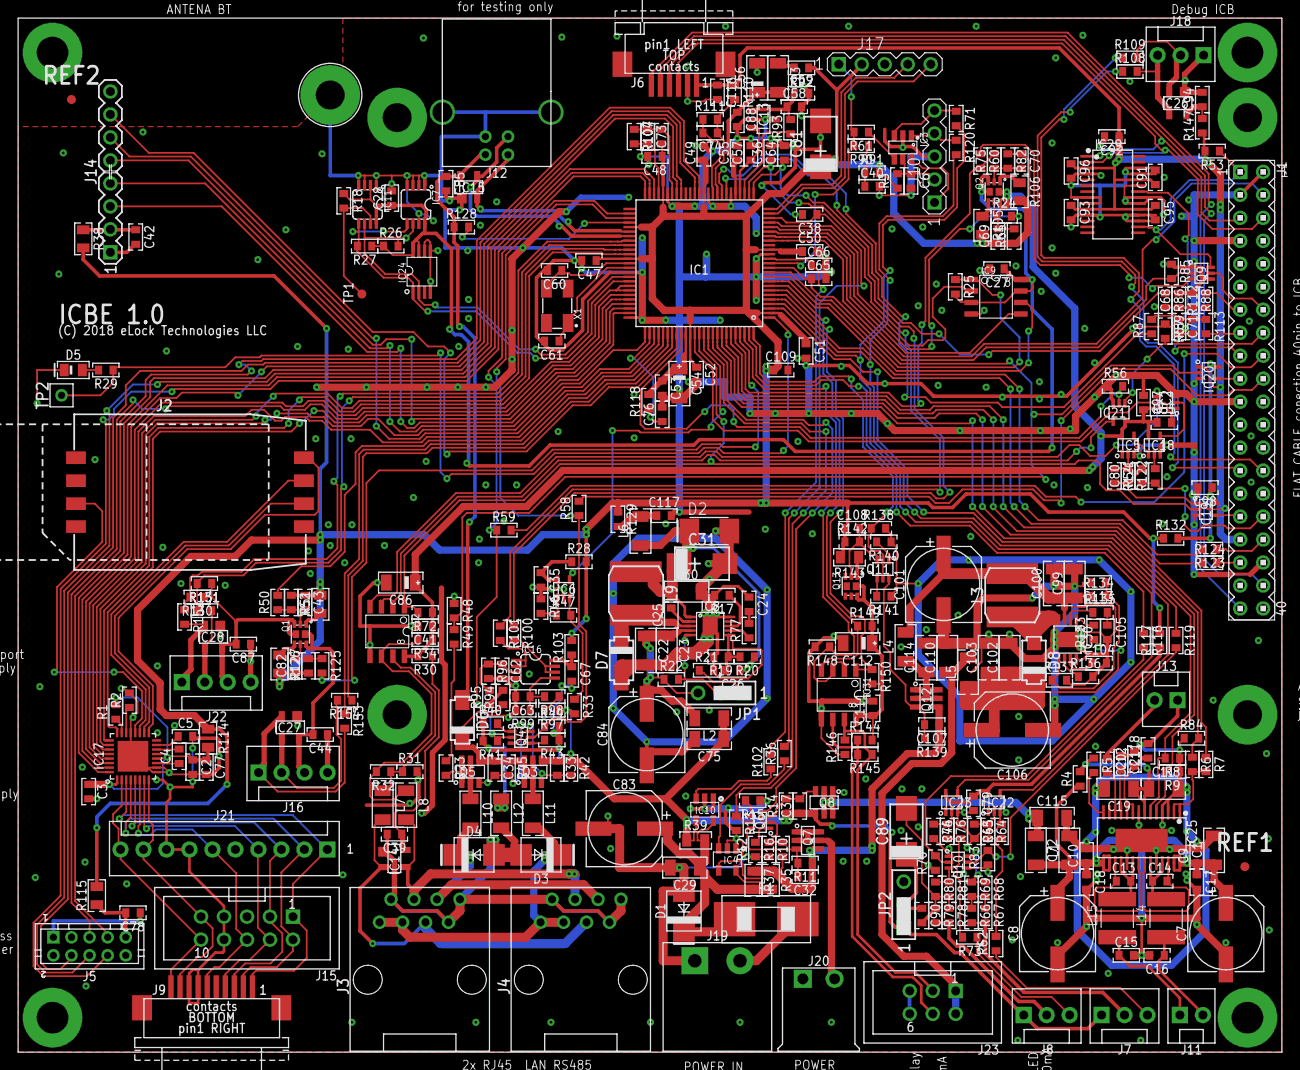
[picture p20: board PCB_ICBExt-R1.0-J36-CH01.brd from above]

Board: 2 copper layers, 139.7 x 114.3 mm, 451 parts (0 on the bottom side), 260 nets.
