alleybeachelectric/Gen6/CONSOLE/rev1.0/FFC_Adapters_10.brd

## EAGLE design CONSOLE/rev1.0/FFC_Adapters_10.brd (2018-03-08)

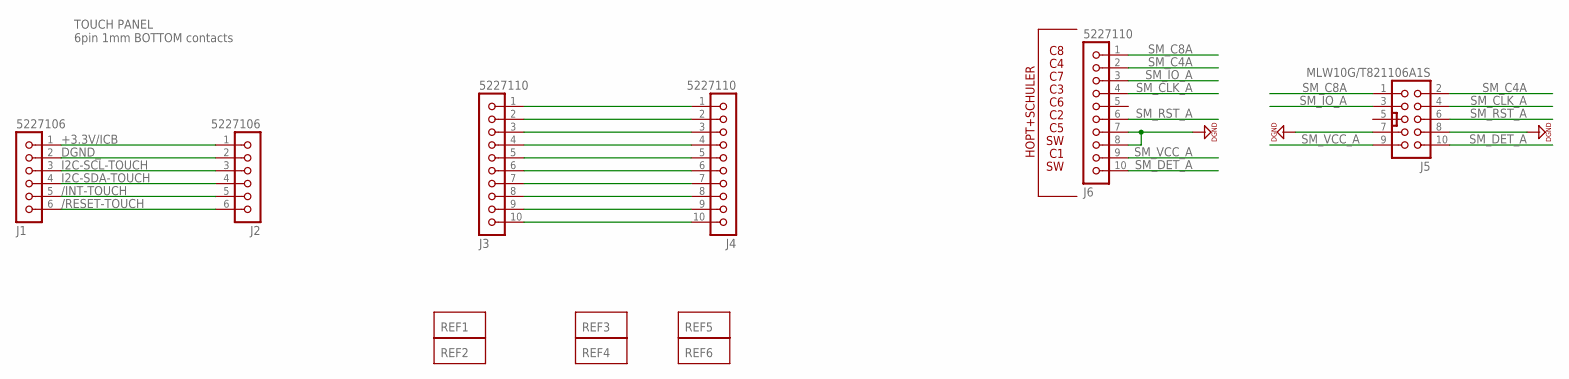
[picture p21: schematic FFC_Adapters_10.sch]

Parts:
J1: 5227106; 5227106/1.LEFT
J2: 5227106; 5227106/1.RIGHT
J3: 5227110; 5227110/1.LEFT
J4, J6: 5227110; 5227110/1.RIGHT
J5: MLW10G/T821106A1S; MLW10-5X2-PRIMY
REF1, REF2, REF3, REF4, REF5, REF6: REF

Connections:
+3.3V/ICB: J1.1, J2.1
/INT-TOUCH: J1.5, J2.5
/RESET-TOUCH: J1.6, J2.6
DGND: J5.7, J5.8, J6.7, J6.8
DGND_: J1.2, J2.2
I2C-SCL-TOUCH: J1.3, J2.3
I2C-SDA-TOUCH: J1.4, J2.4
unnamed: J3.1, J4.1
unnamed: J3.2, J4.2
unnamed: J3.3, J4.3
unnamed: J3.4, J4.4
unnamed: J3.5, J4.5
unnamed: J3.6, J4.6
unnamed: J3.7, J4.7
unnamed: J3.8, J4.8
unnamed: J3.9, J4.9
unnamed: J3.10, J4.10
SM_C4A: J5.2, J6.2
SM_C8A: J5.1, J6.1
SM_CLK_A: J5.4, J6.4
SM_DET_A: J5.10, J6.10
SM_IO_A: J5.3, J6.3
SM_RST_A: J5.6, J6.6
SM_VCC_A: J5.9, J6.9

Notes on the sheet:
TOUCH PANEL 6pin 1mm BOTTOM contacts
HOPT+SCHULER

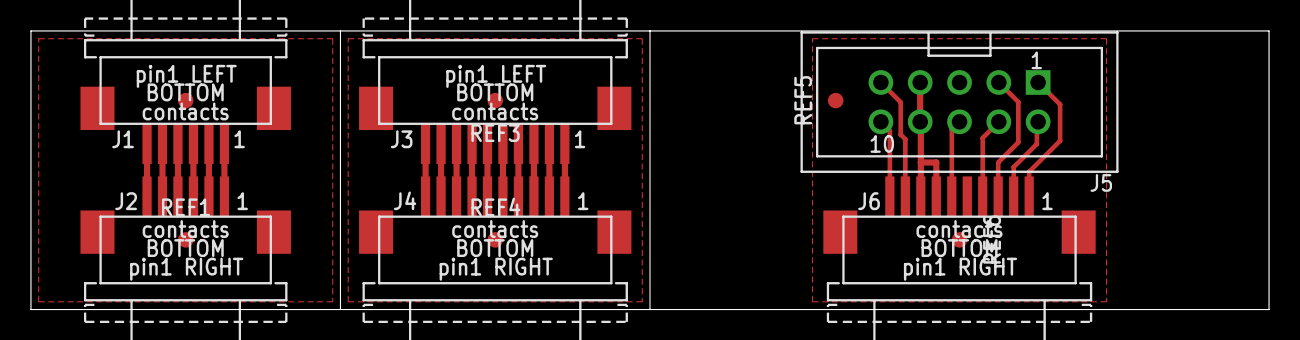
[picture p22: board FFC_Adapters_10.brd from above]

Board: 2 copper layers, 80.0 x 18.0 mm, 12 parts (0 on the bottom side), 24 nets.
