alleybeachelectric/Gen6/ACB/ACB-LITE-3.2/ACB-Lite 3.2.brd

## EAGLE design ACB/ACB-LITE-3.2/ACB-Lite 3.2.brd (2018-02-24)

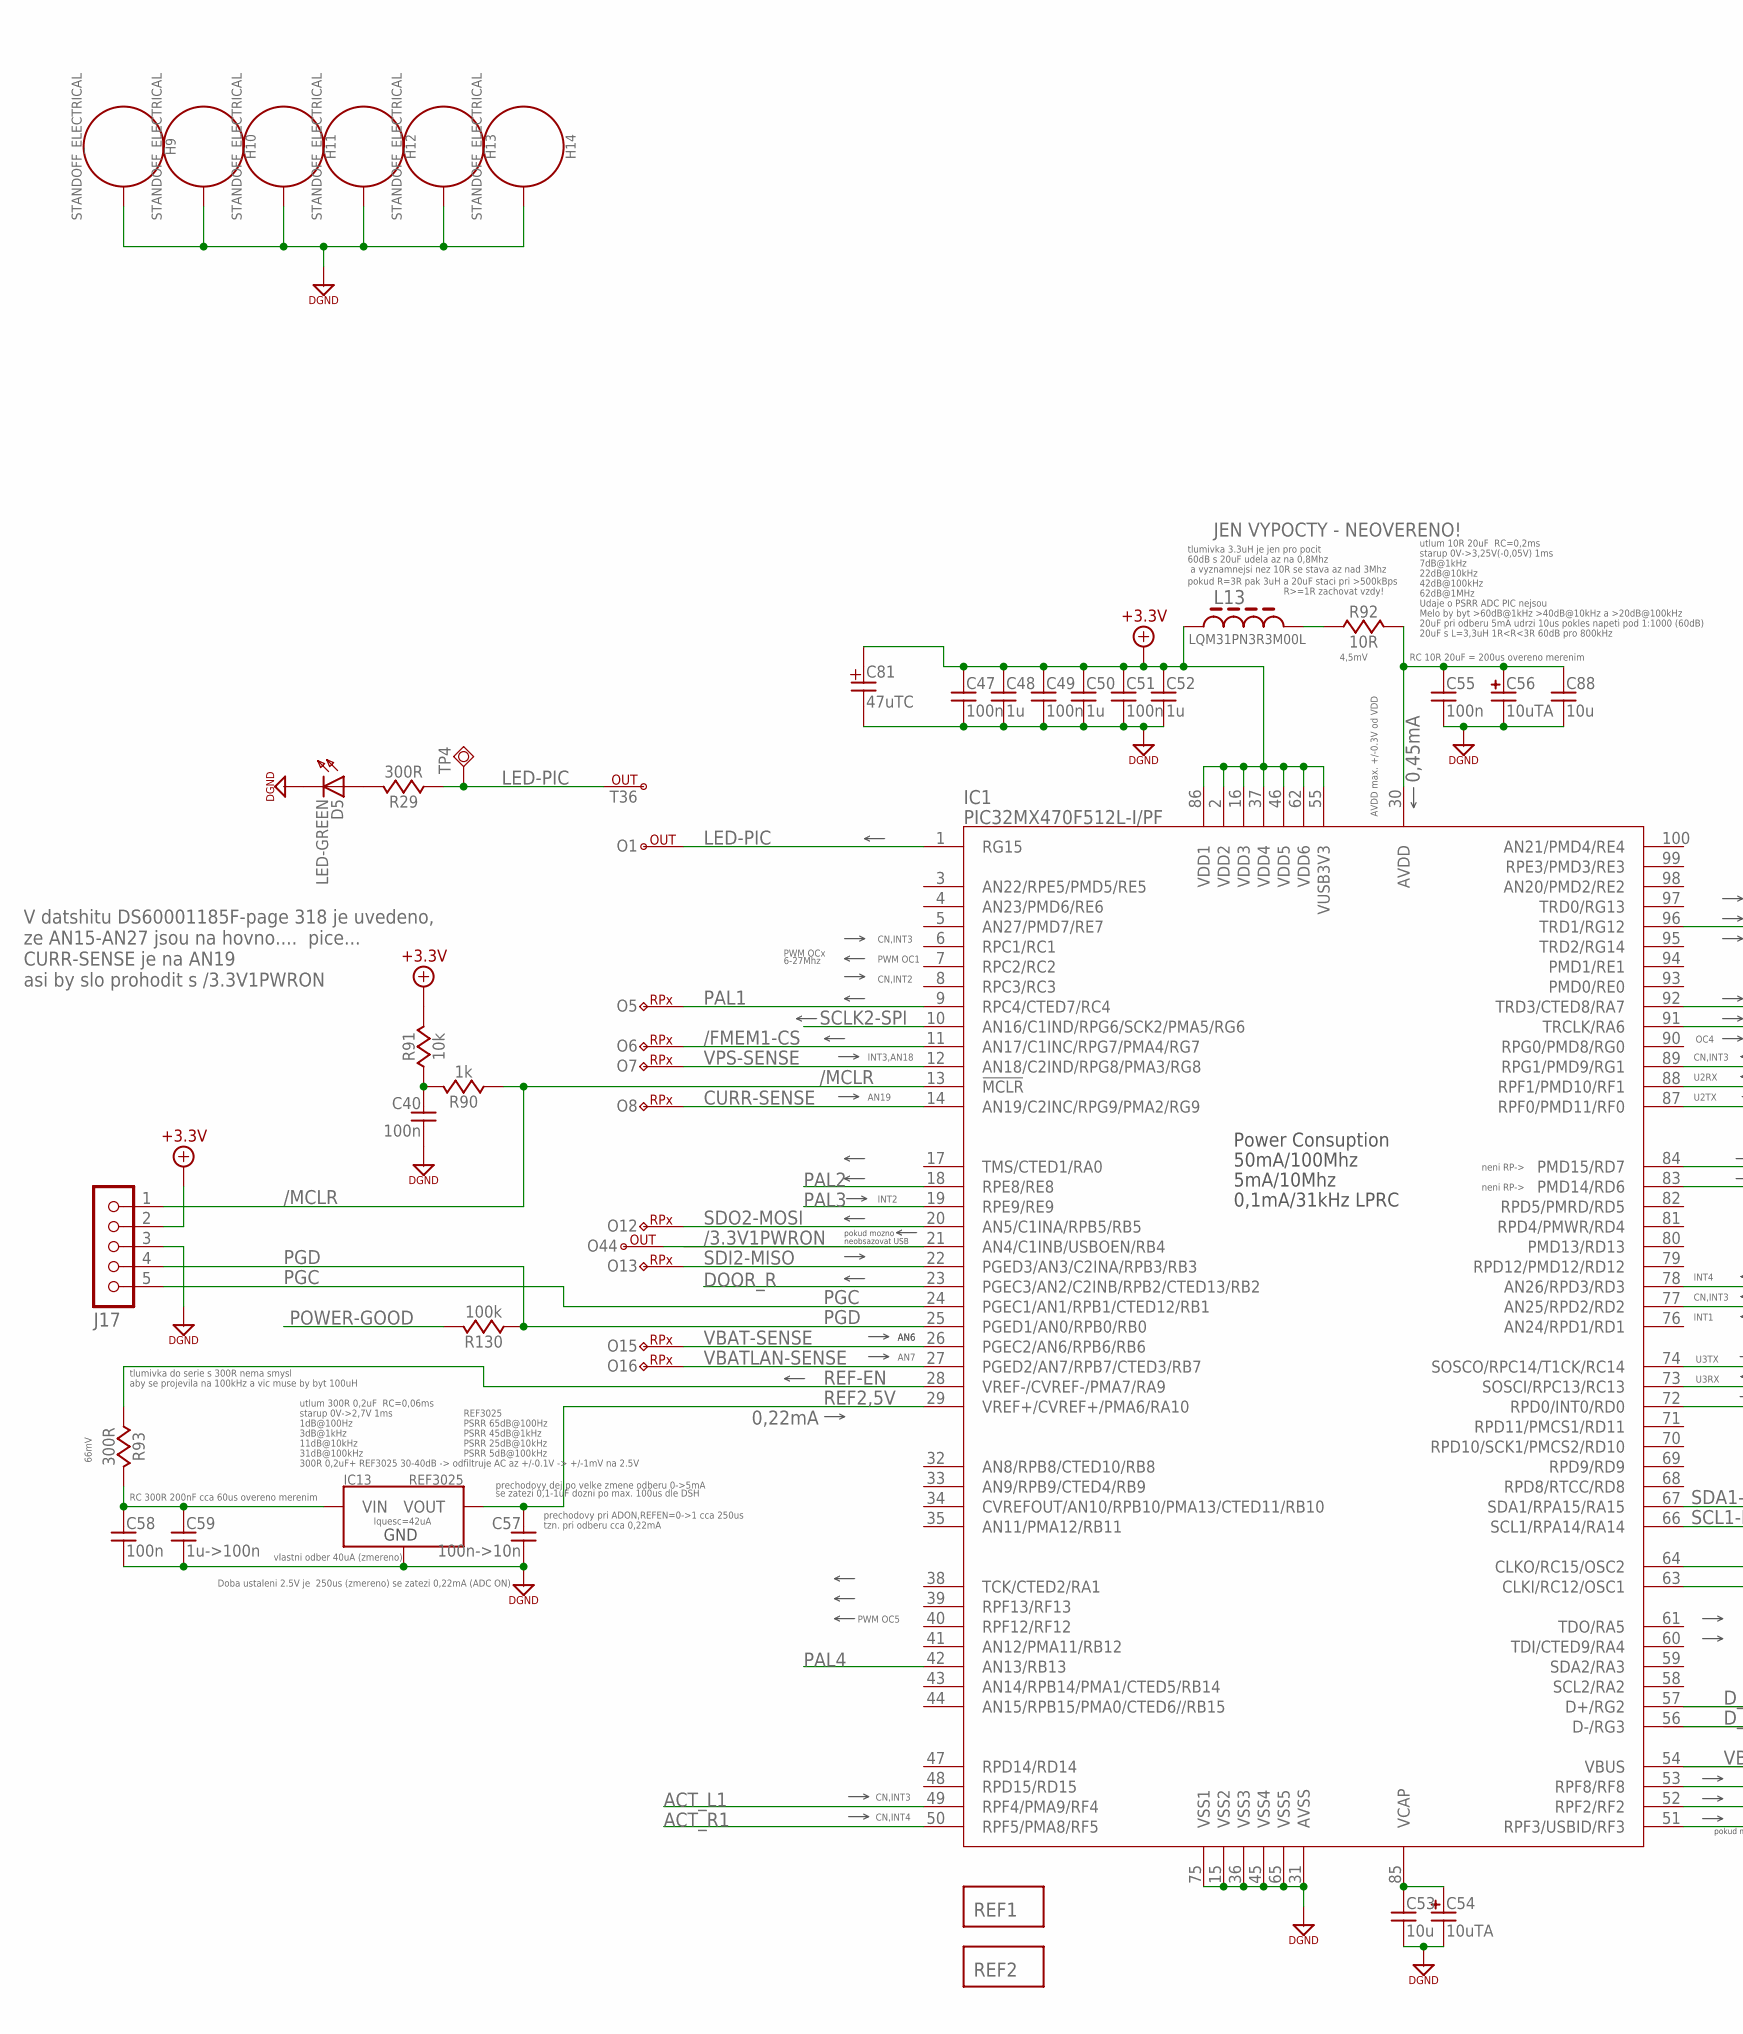
[picture p23: schematic ACB-Lite 3.2.sch, sheet 1, part in row 1, column 1]

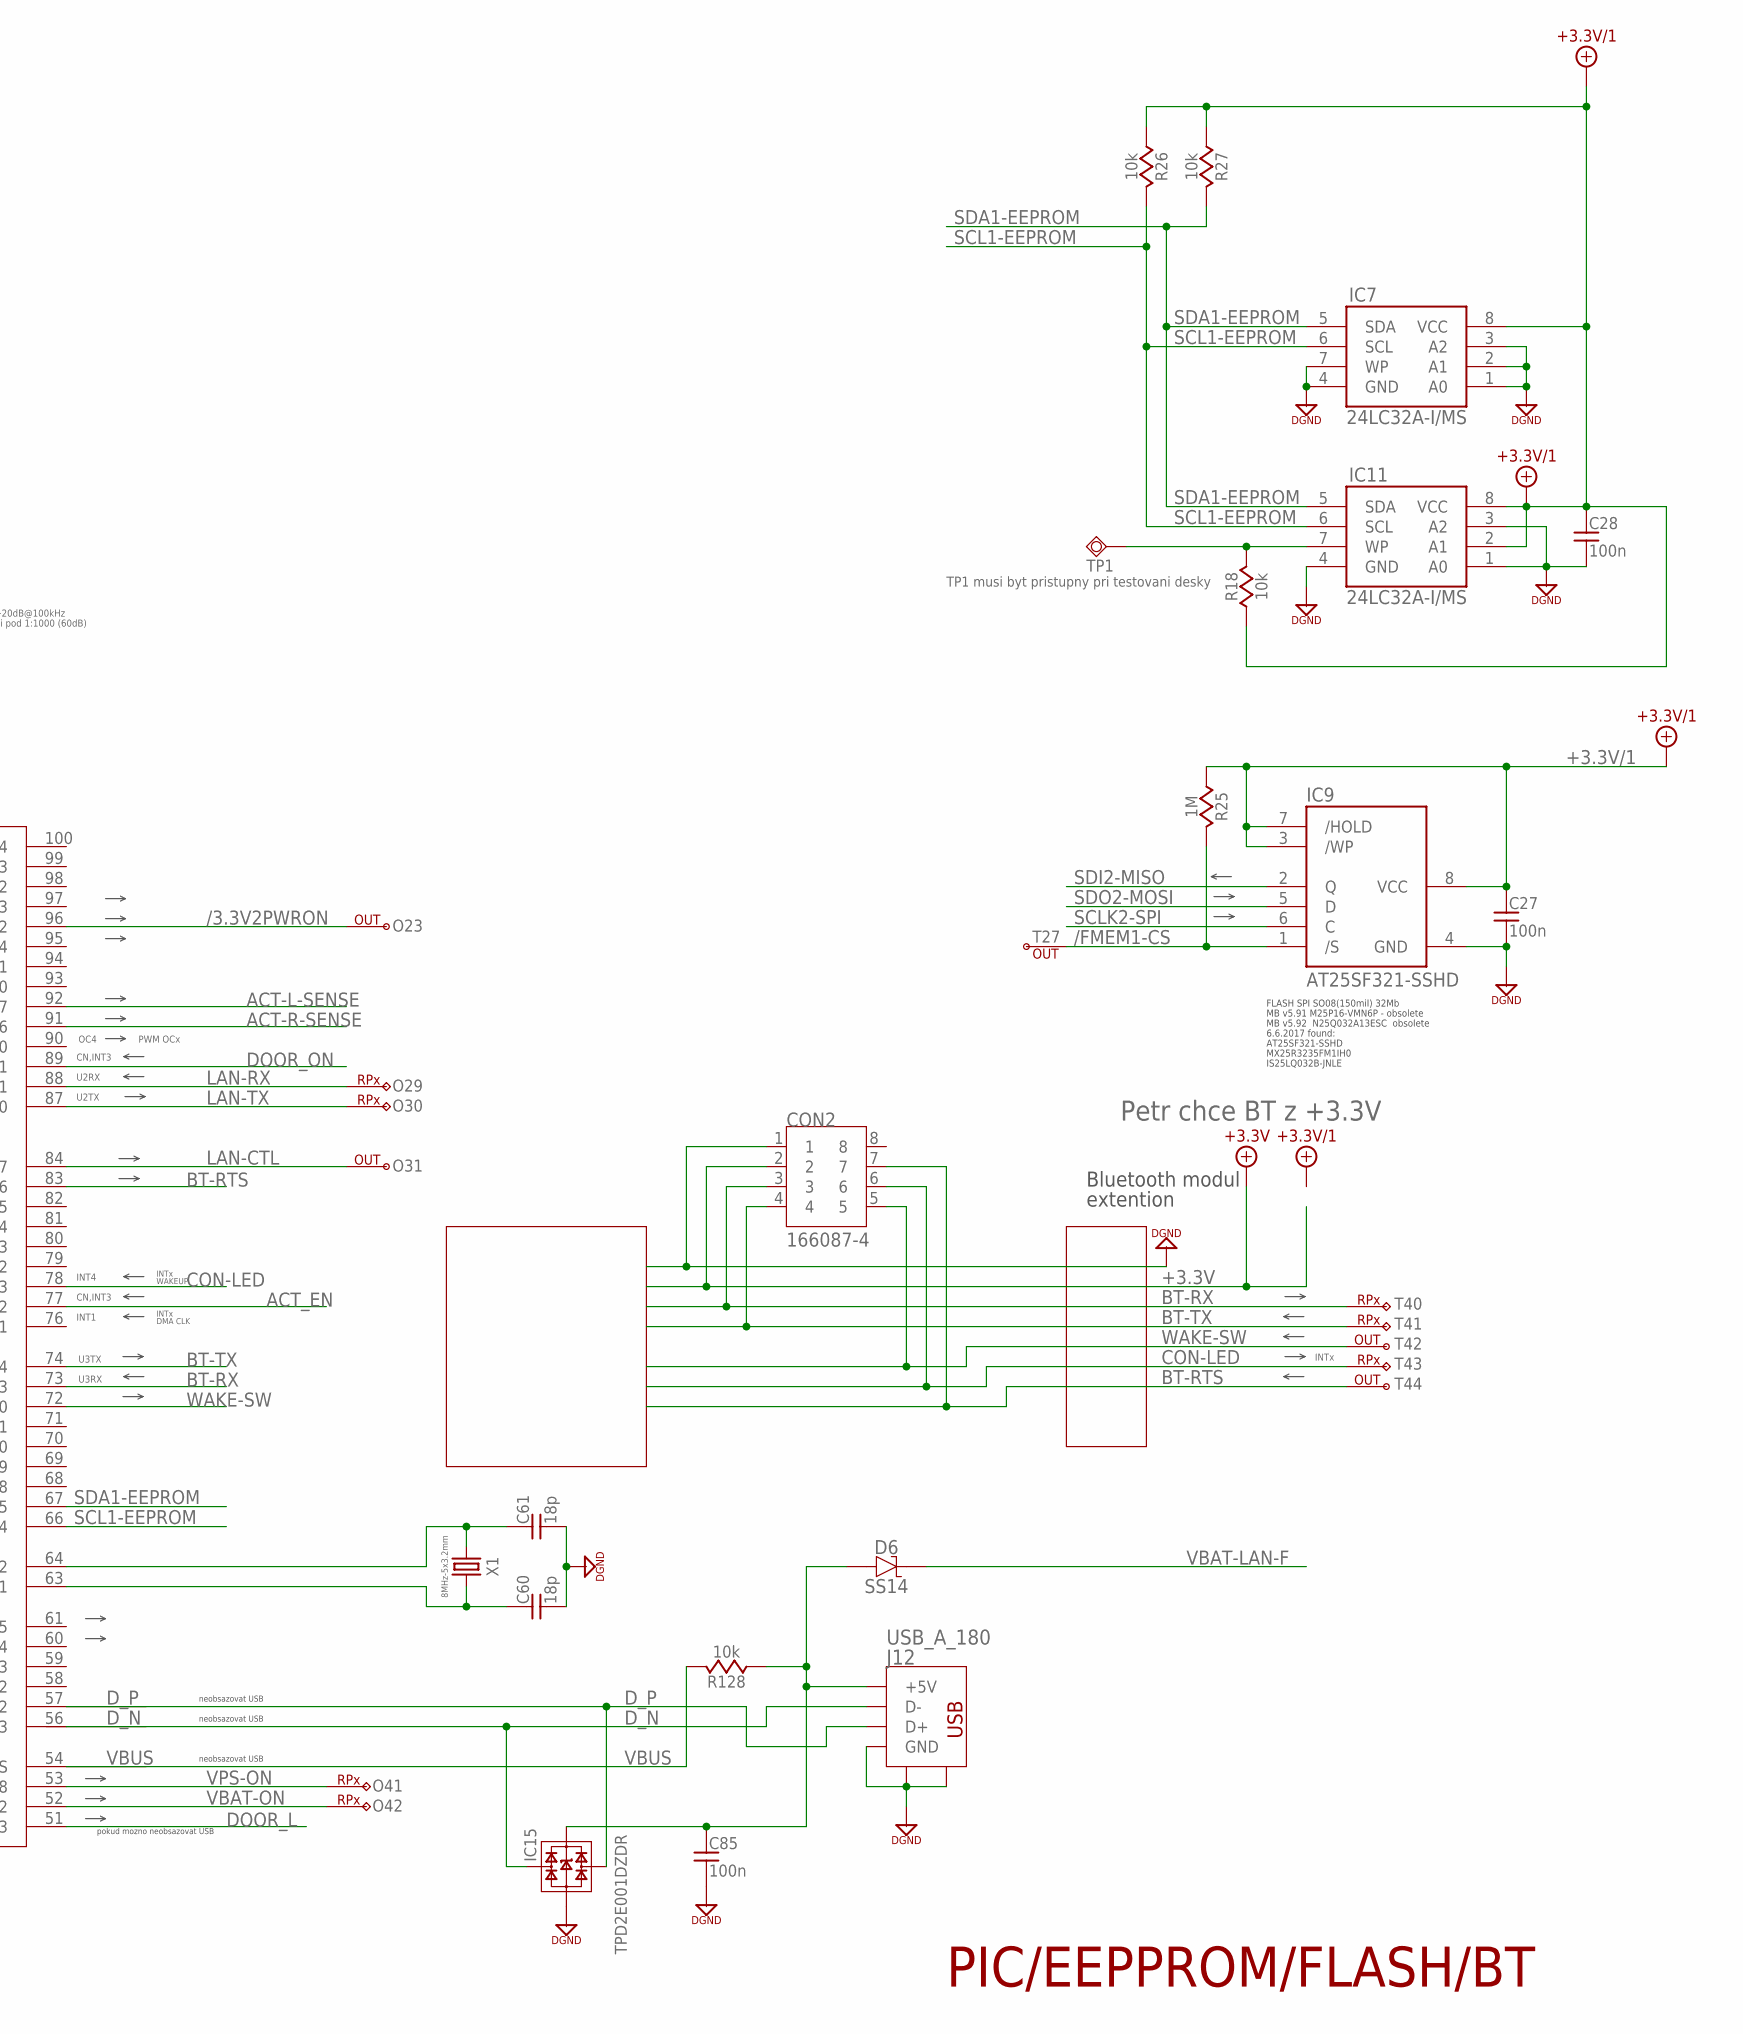
[picture p24: schematic ACB-Lite 3.2.sch, sheet 1, part in row 1, column 2]

Parts:
C27, C28, C40, C47, C49, C51, C55, C58, C85: 100n; 0603
C48, C50, C52: 1u; 0603
C53, C88: 10u; 0603
C54, C56: 10uTA; 1206-POL-C
C57: 100n->10n; 0603
C59: 1u->100n; 0603
C60, C61: 18p; 0603
C81: 47uTC; CT-C
CON2: 166087-4
D5: LED-GREEN; 0805-POL-D
D6: SS14; SMA
H9, H10, H11, H12, H13, H14: STANDOFF_ELECTRICAL; STANDOFF-ELECTRICAL
IC1: PIC32MX470F512L-I/PF; TQFP100_14X14_0,5MM
IC7, IC11: 24LC32A-I/MS; MSOP-08
IC9: AT25SF321-SSHD; SO-08
IC13: REF3025; SOT23
IC15: TPD2E001DZDR; SOT-143
J12: USB_A_180; USB_B_180
J17: DNP-open-hole; MA05-1
L13: LQM31PN3R3M00L; 1206
O1, O23, O31, O44: PIC-OUT; TEMP-PAD
O5, O6, O7, O8, O12, O13, O15, O16, O29, O30, O41, O42: PIC-RPX; TEMP-PAD
R18, R26, R27, R91, R128: 10k; 0603
R25: 1M; 0603
R29, R93: 300R; 0603
R90: 1k; 0603
R92: 10R; 0603
R130: 100k; 0603
REF1, REF2: REF
T27, T36, T42, T44: PIC-OUT; TEMP-PAD
T40, T41, T43: PIC-RPX; TEMP-PAD
TP1: DNP-TestPoint; SMD_ROUND_1MM
TP4: DNP-TestPoint; TH_ROUND_14MM08MM
X1: 8MHz-5x3.2mm; 7B

Connections:
+3.3V: C47.1, C48.1, C49.1, C50.1, C51.1, C52.1, C81.+, CON2.2, IC1.2 (VDD2), IC1.16 (VDD3), IC1.37 (VDD4), IC1.46 (VDD5), IC1.55 (VUSB3V3), IC1.62 (VDD6), IC1.86 (VDD1), J17.2, L13.1, R91.2; also elsewhere on the board
+3.3V/1: C27.1, C28.1, IC7.8 (VCC), IC9.3 (/WP), IC9.7 (/HOLD), IC9.8 (VCC), IC11.2 (A1), IC11.8 (VCC), R18.1, R25.2, R26.1, R27.1; also elsewhere on the board
/3.3V1PWRON: IC1.21 (AN4/C1INB/USBOEN/RB4), O44.P$1; also elsewhere on the board
/3.3V2PWRON: IC1.96 (TRD1/RG12), O23.P$1; also elsewhere on the board
/FMEM1-CS: IC1.11 (AN17/C1INC/RPG7/PMA4/RG7), IC9.1 (/S), O6.P$1, R25.1, T27.P$1
/MCLR: IC1.13 (!MCLR), J17.1, R90.2
ACT-L-SENSE: IC1.92 (TRD3/CTED8/RA7); also elsewhere on the board
ACT-R-SENSE: IC1.91 (TRCLK/RA6); also elsewhere on the board
ACT_EN: IC1.77 (AN25/RPD2/RD2); also elsewhere on the board
ACT_L1: IC1.49 (RPF4/PMA9/RF4); also elsewhere on the board
ACT_R1: IC1.50 (RPF5/PMA8/RF5); also elsewhere on the board
AVDD: C55.1, C56.+, C88.1, IC1.30 (AVDD), R92.2
BT-RTS: CON2.7, IC1.83 (PMD14/RD6), T44.P$1
BT-RX: CON2.3, IC1.73 (SOSCI/RPC13/RC13), T40.P$1
BT-TX: CON2.4, IC1.74 (SOSCO/RPC14/T1CK/RC14), T41.P$1
CON-LED: CON2.6, IC1.78 (AN26/RPD3/RD3), T43.P$1
CURR-SENSE: IC1.14 (AN19/C2INC/RPG9/PMA2/RG9), O8.P$1; also elsewhere on the board
DGND: C27.2, C28.2, C40.2, C47.2, C48.2, C49.2, C50.2, C51.2, C52.2, C53.2, C54.-, C55.2, C56.-, C57.2, C58.2, C59.2, C60.2, C61.2, C81.-, C85.2, C88.2, CON2.1, D5.K, H9.P1, H10.P1, H11.P1, H12.P1, H13.P1, H14.P1, IC1.15 (VSS2), IC1.31 (AVSS), IC1.36 (VSS3), IC1.45 (VSS4), IC1.65 (VSS5), IC1.75 (VSS1), IC7.1 (A0), IC7.2 (A1), IC7.3 (A2), IC7.4 (GND), IC7.7 (WP), IC9.4 (GND), IC11.1 (A0), IC11.3 (A2), IC11.4 (GND), IC13.3 (GND), IC15.1, J12.4_GND (GND), J12.SH1 (GND_SH1), J12.SH2 (GND_SH2), J17.3; also elsewhere on the board
DOOR_L: IC1.51 (RPF3/USBID/RF3); also elsewhere on the board
DOOR_ON: IC1.89 (RPG1/PMD9/RG1); also elsewhere on the board
DOOR_R: IC1.23 (PGEC3/AN2/C2INB/RPB2/CTED13/RB2); also elsewhere on the board
D_N: IC1.56 (D-/RG3), IC15.2, J12.2_D- (D-)
D_P: IC1.57 (D+/RG2), IC15.3, J12.3_D+ (D+)
LAN-CTL: IC1.84 (PMD15/RD7), O31.P$1; also elsewhere on the board
LAN-RX: IC1.88 (RPF1/PMD10/RF1), O29.P$1; also elsewhere on the board
LAN-TX: IC1.87 (RPF0/PMD11/RF0), O30.P$1; also elsewhere on the board
LED-PIC: IC1.1 (RG15), O1.P$1, R29.1, T36.P$1, TP4.P$1
unnamed: IC11.7 (WP), R18.2, TP1.P$1
unnamed: D5.A, R29.2
unnamed: L13.2, R92.1
unnamed: C61.1, IC1.64 (CLKO/RC15/OSC2), X1.1
unnamed: C60.1, IC1.63 (CLKI/RC12/OSC1), X1.3 (2)
unnamed: C58.1, C59.1, IC13.1 (VIN), R93.2
unnamed: C40.1, R90.1, R91.1
unnamed: C85.1, D6.A, IC15.4, J12.1_+5V (+5V), R128.1
PAL1: IC1.9 (RPC4/CTED7/RC4), O5.P$1; also elsewhere on the board
PAL2: IC1.18 (RPE8/RE8); also elsewhere on the board
PAL3: IC1.19 (RPE9/RE9); also elsewhere on the board
PAL4: IC1.42 (AN13/RB13); also elsewhere on the board
PGC: IC1.24 (PGEC1/AN1/RPB1/CTED12/RB1), J17.5
PGD: IC1.25 (PGED1/AN0/RPB0/RB0), J17.4, R130.2
POWER-GOOD: R130.1; also elsewhere on the board
REF2,5V: C57.1, IC1.29 (VREF+/CVREF+/PMA6/RA10), IC13.2 (VOUT)
REF-EN: IC1.28 (VREF-/CVREF-/PMA7/RA9), R93.1
SCL1-EEPROM: IC1.66 (SCL1/RPA14/RA14), IC7.6 (SCL), IC11.6 (SCL), R26.2
SCLK2-SPI: IC1.10 (AN16/C1IND/RPG6/SCK2/PMA5/RG6), IC9.6 (C)
SDA1-EEPROM: IC1.67 (SDA1/RPA15/RA15), IC7.5 (SDA), IC11.5 (SDA), R27.2
SDI2-MISO: IC1.22 (PGED3/AN3/C2INA/RPB3/RB3), IC9.2 (Q), O13.P$1
SDO2-MOSI: IC1.20 (AN5/C1INA/RPB5/RB5), IC9.5 (D), O12.P$1
VBAT-LAN-F: D6.K; also elsewhere on the board
VBAT-ON: IC1.52 (RPF2/RF2), O42.P$1; also elsewhere on the board
VBAT-SENSE: IC1.26 (PGEC2/AN6/RPB6/RB6), O15.P$1; also elsewhere on the board
VBATLAN-SENSE: IC1.27 (PGED2/AN7/RPB7/CTED3/RB7), O16.P$1; also elsewhere on the board
VBUS: IC1.54 (VBUS), R128.2
VCAP: C53.1, C54.+, IC1.85 (VCAP)
VPS-ON: IC1.53 (RPF8/RF8), O41.P$1; also elsewhere on the board
VPS-SENSE: IC1.12 (AN18/C2IND/RPG8/PMA3/RG8), O7.P$1; also elsewhere on the board
WAKE-SW: CON2.5, IC1.72 (RPD0/INT0/RD0), T42.P$1

Notes on the sheet:
MB v5.91 M25P16-VMN6P - obsolete
MB v5.92 N25Q032A13ESC obsolete
AT25SF321-SSHD
MX25R3235FM1IH0
IS25LQ032B-JNLE
FLASH SPI SO08(150mil) 32Mb
6.6.2017 found:
Power Consuption
50mA/100Mhz
5mA/10Mhz
0,1mA/31kHz LPRC
pokud mozno
TP1 musi byt pristupny pri testovani desky
neobsazovat USB
pokud mozno neobsazovat USB
PWM OCx
6-27Mhz
INTx
DMA CLK
WAKEUP
PSRR 25dB@10kHz
PSRR 65dB@100Hz
PSRR 45dB@1kHz
PSRR 5dB@100kHz
300R 0,2uF+ REF3025 30-40dB -> odfiltruje AC az +/-0.1V -> +/-1mV na 2.5V
REF3025
prechodovy dej po velke zmene odberu 0->5mA
se zatezi 0,1-1uF dozni po max. 100us dle DSH
Iquesc=42uA
tlumivka 3.3uH je jen pro pocit
PWM OC1
INT3,AN18
AN19
CN,INT3
CN,INT2
INT2
PWM OC5
AN6
AN7
CN,INT4
neni RP->
JEN VYPOCTY - NEOVERENO!
AVDD max. +/-0.3V od VDD
4,5mV
OC4
INT1
INT4
U3TX
U3RX
U2RX
U2TX
vlastni odber 40uA (zmereno)
Doba ustaleni 2.5V je 250us (zmereno) se zatezi 0,22mA (ADC ON)
0,22mA
0,45mA
RC 10R 20uF = 200us overeno merenim
RC 300R 200nF cca 60us overeno merenim
66mV
prechodovy pri ADON,REFEN=0->1 cca 250us
tzn. pri odberu cca 0,22mA
V datshitu DS60001185F-page 318 je uvedeno, ze AN15-AN27 jsou na hovno.... pice... CURR-SENSE je na AN19 asi by slo prohodit s /3.3V1PWRON
1dB@100Hz
utlum 300R 0,2uF RC=0,06ms
11dB@10kHz
3dB@1kHz
31dB@100kHz
starup 0V->2,7V 1ms
tlumivka do serie s 300R nema smysl
aby se projevila na 100kHz a vic muse by byt 100uH
7dB@1kHz
utlum 10R 20uF RC=0,2ms
42dB@100kHz
22dB@10kHz
62dB@1MHz
starup 0V->3,25V(-0,05V) 1ms
Udaje o PSRR ADC PIC nejsou
Melo by byt >60dB@1kHz >40dB@10kHz a >20dB@100kHz
60dB s 20uF udela az na 0,8Mhz
a vyznamnejsi nez 10R se stava az nad 3Mhz
20uF pri odberu 5mA udrzi 10us pokles napeti pod 1:1000 (60dB)
20uF s L=3,3uH 1R<R<3R 60dB pro 800kHz
pokud R=3R pak 3uH a 20uF staci pri >500kBps
R>=1R zachovat vzdy!
Bluetooth modul
extention
Petr chce BT z +3.3V
PIC/EEPPROM/FLASH/BT

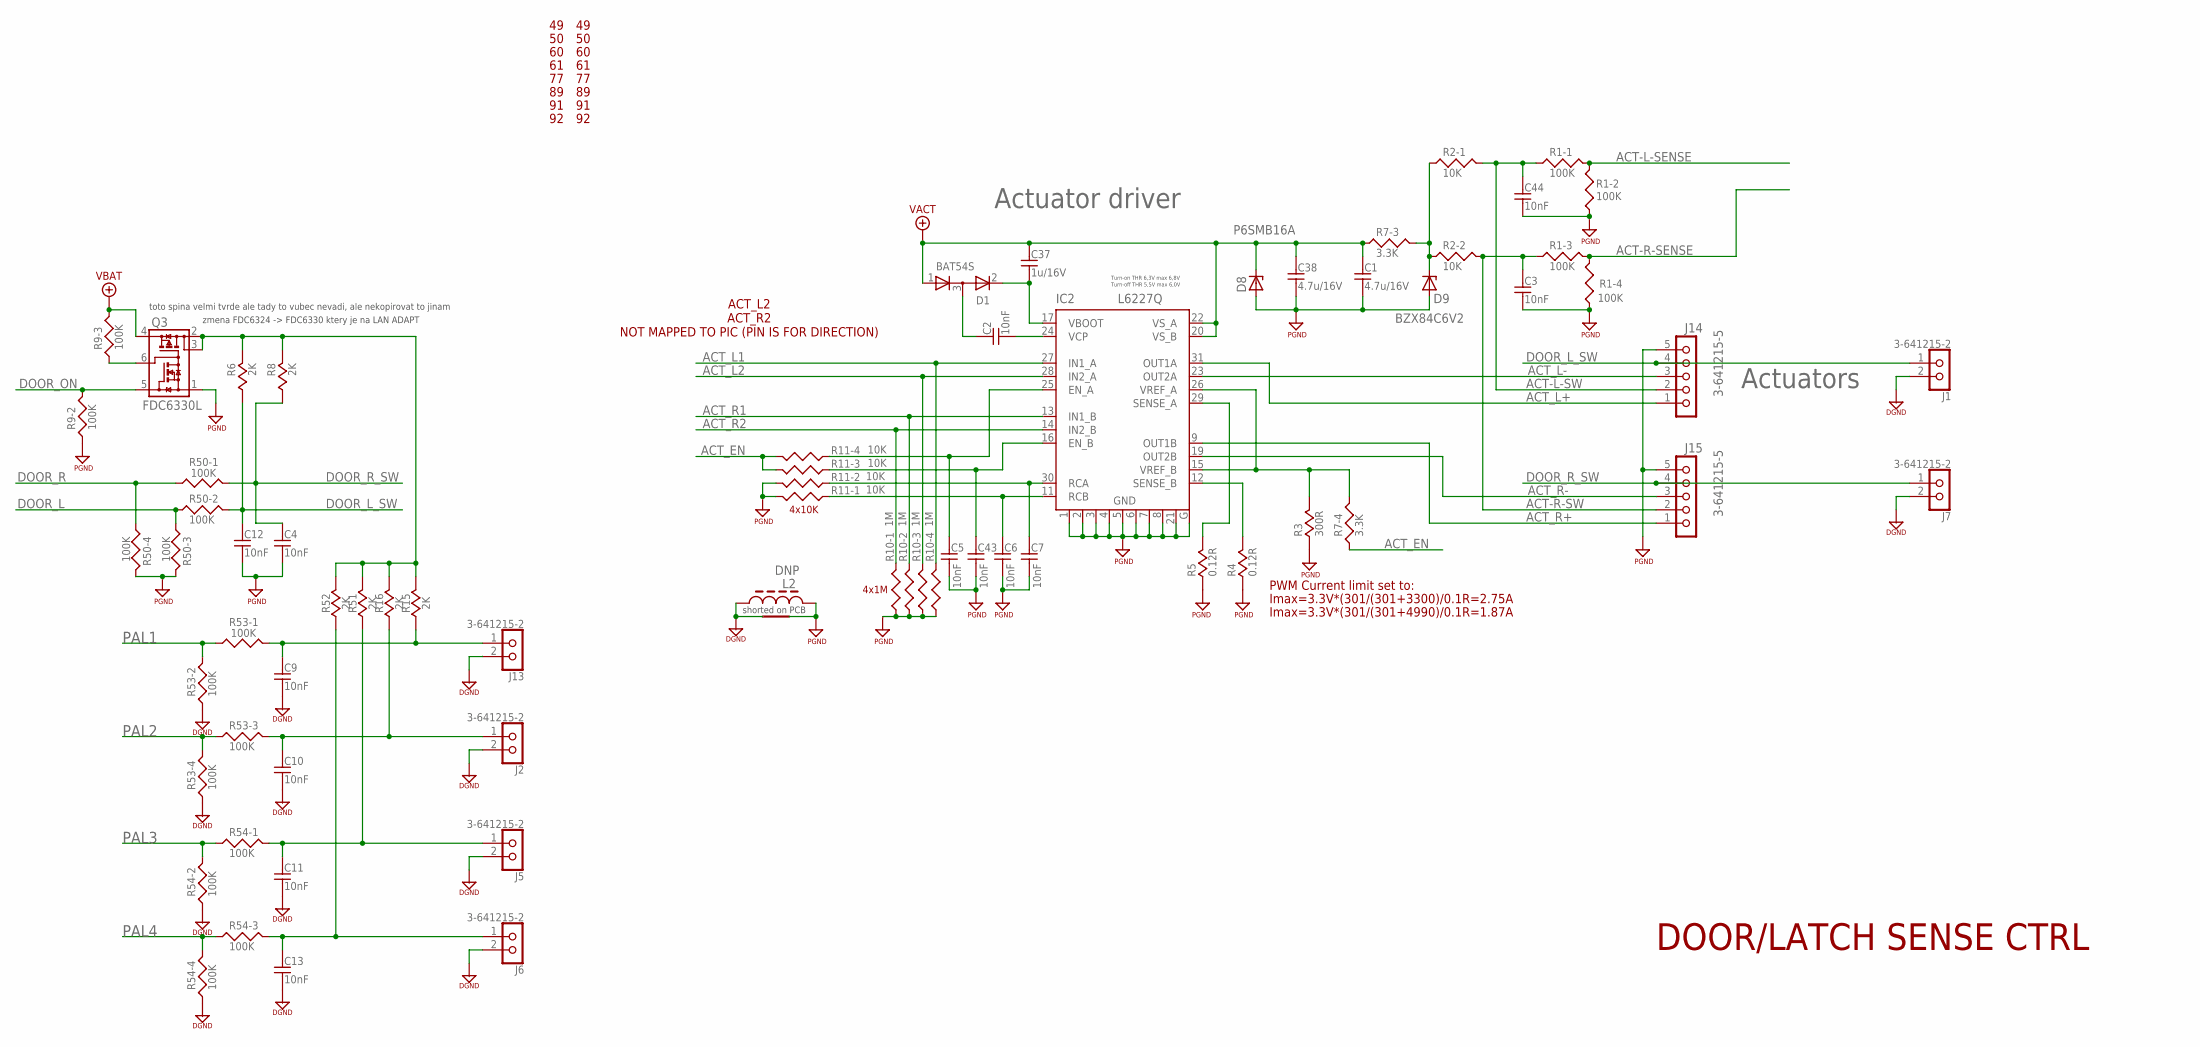
[picture p25: schematic ACB-Lite 3.2.sch, sheet 2]

Parts:
C1, C38: 4.7u/16V; 0805
C2, C3, C4, C5, C6, C7, C9, C10, C11, C12, C13, C43, C44: 10nF; 0603
C37: 1u/16V; 0603
D1: BAT54S; SOT-23
D8: P6SMB16A; SMB
D9: BZX84C6V2; SOT-23
IC2: L6227Q; SQFP-S-5X5-32
J1, J2, J5, J6, J7, J13: 3-641215-2
J14, J15: 3-641215-5
L2: DNP; 0805-0RTOP
Q3: FDC6330L; SSOT-6
R1, R9, R50, R53, R54: 100K; 0603-ARRAY
R2, R11: 10K; 0603-ARRAY
R3: 300R; 0603
R4, R5: 0.12R; 0805
R6, R8, R15, R16, R51, R52: 2K; 0603
R7: 3.3K; 0603-ARRAY
R10: 1M; 0603-ARRAY

Connections:
ACT-L-SENSE: R1.7 (2), R1.8 (2); also elsewhere on the board
ACT-L-SW: C44.1, J14.2, R1.1, R2.8 (2)
ACT-R-SENSE: R1.5 (2), R1.6 (2); also elsewhere on the board
ACT-R-SW: C3.1, J15.2, R1.3 (1), R2.7 (2)
ACT_EN: R7.4 (1), R11.5 (2), R11.6 (2); also elsewhere on the board
ACT_L1: IC2.27 (IN1_A), R10.5 (2); also elsewhere on the board
ACT_L2: IC2.28 (IN2_A), R10.6 (2)
ACT_L+: IC2.31 (OUT1A), J14.1
ACT_L-: IC2.23 (OUT2A), J14.3
ACT_R1: IC2.13 (IN1_B), R10.7 (2); also elsewhere on the board
ACT_R2: IC2.14 (IN2_B), R10.8 (2)
ACT_R+: IC2.9 (OUT1B), J15.1
ACT_R-: IC2.19 (OUT2B), J15.3
DGND: C9.2, C10.2, C11.2, C13.2, J1.2, J2.2, J5.2, J6.2, J7.2, J13.2, L2.2, R53.2 (1), R53.4 (1), R54.2 (1), R54.4 (1); also elsewhere on the board
DOOR_L: R50.2 (1), R50.3 (1); also elsewhere on the board
DOOR_L_SW: C12.1, J1.1, J14.4, R6.2, R50.7 (2)
DOOR_ON: Q3.5 (Q1G), R9.7 (2); also elsewhere on the board
DOOR_R: R50.1, R50.4 (1); also elsewhere on the board
DOOR_R_SW: C4.1, J7.1, J15.4, R8.2, R50.8 (2)
unnamed: C5.1, IC2.25 (EN_A), R11.4 (1)
unnamed: C43.1, IC2.16 (EN_B), R11.3 (1)
unnamed: C6.1, IC2.11 (RCB), R11.1
unnamed: C9.1, J13.1, R15.2, R53.8 (2)
unnamed: C2.2, IC2.24 (VCP)
unnamed: C10.1, J2.1, R16.2, R53.6 (2)
unnamed: C11.1, J5.1, R51.2, R54.8 (2)
unnamed: C13.1, J6.1, R52.2, R54.6 (2)
unnamed: C2.1, D1.3 (KA)
unnamed: D9.3 (C), R2.1, R2.2 (1), R7.6 (2)
unnamed: IC2.12 (SENSE_B), R4.2
unnamed: Q3.6 (Q2G), R9.3 (1)
unnamed: Q3.2 (Q2D1), Q3.3 (Q2D2), R6.1, R8.1, R15.1, R16.1, R51.1, R52.1
unnamed: IC2.29 (SENSE_A), R5.2
unnamed: C37.2, D1.2 (K), IC2.17 (VBOOT)
unnamed: C7.1, IC2.30 (RCA), R11.2 (1)
unnamed: IC2.15 (VREF_B), IC2.26 (VREF_A), R3.2, R7.5 (2)
PAL1: R53.1, R53.7 (2); also elsewhere on the board
PAL2: R53.3 (1), R53.5 (2); also elsewhere on the board
PAL3: R54.1, R54.7 (2); also elsewhere on the board
PAL4: R54.3 (1), R54.5 (2); also elsewhere on the board
PGND: C1.2, C3.2, C4.2, C5.2, C6.2, C7.2, C12.2, C38.2, C43.2, C44.2, D8.A, D9.1 (A), IC2.1 (GND1), IC2.2 (GND2), IC2.3 (GND3), IC2.4 (GND4), IC2.5 (GND5), IC2.6 (GND6), IC2.7 (GND7), IC2.8 (GND8), IC2.21 (GND21), IC2.G (GNEXP), J14.5, J15.5, L2.1, Q3.1 (Q1S), R1.2 (1), R1.4 (1), R3.1, R4.1, R5.1, R9.2 (1), R10.1, R10.2 (1), R10.3 (1), R10.4 (1), R11.7 (2), R11.8 (2), R50.5 (2), R50.6 (2)
VACT: C1.1, C37.1, C38.1, D1.1 (A), D8.C, IC2.20 (VS_B), IC2.22 (VS_A), R7.3 (1); also elsewhere on the board
VBAT: Q3.4 (Q2S), R9.6 (2); also elsewhere on the board

Notes on the sheet:
Actuator driver
Actuators
4x10K
4x1M
PWM Current limit set to:
Imax=3.3V*(301/(301+3300)/0.1R=2.75A
Imax=3.3V*(301/(301+4990)/0.1R=1.87A
Turn-on THR 6,3V max 6,8V
Turn-off THR 5,5V max 6,0V
toto spina velmi tvrde ale tady to vubec nevadi, ale nekopirovat to jinam
zmena FDC6324 -> FDC6330 ktery je na LAN ADAPT
shorted on PCB
DOOR/LATCH SENSE CTRL
ACT_L2 ACT_R2 NOT MAPPED TO PIC (PIN IS FOR DIRECTION)
