alleybeachelectric/Gen6/ACB/ACB-LITE-3.2/ACB-Lite 3.2.brd

## EAGLE design ACB/ACB-LITE-3.2/ACB-Lite 3.2.brd (continued)

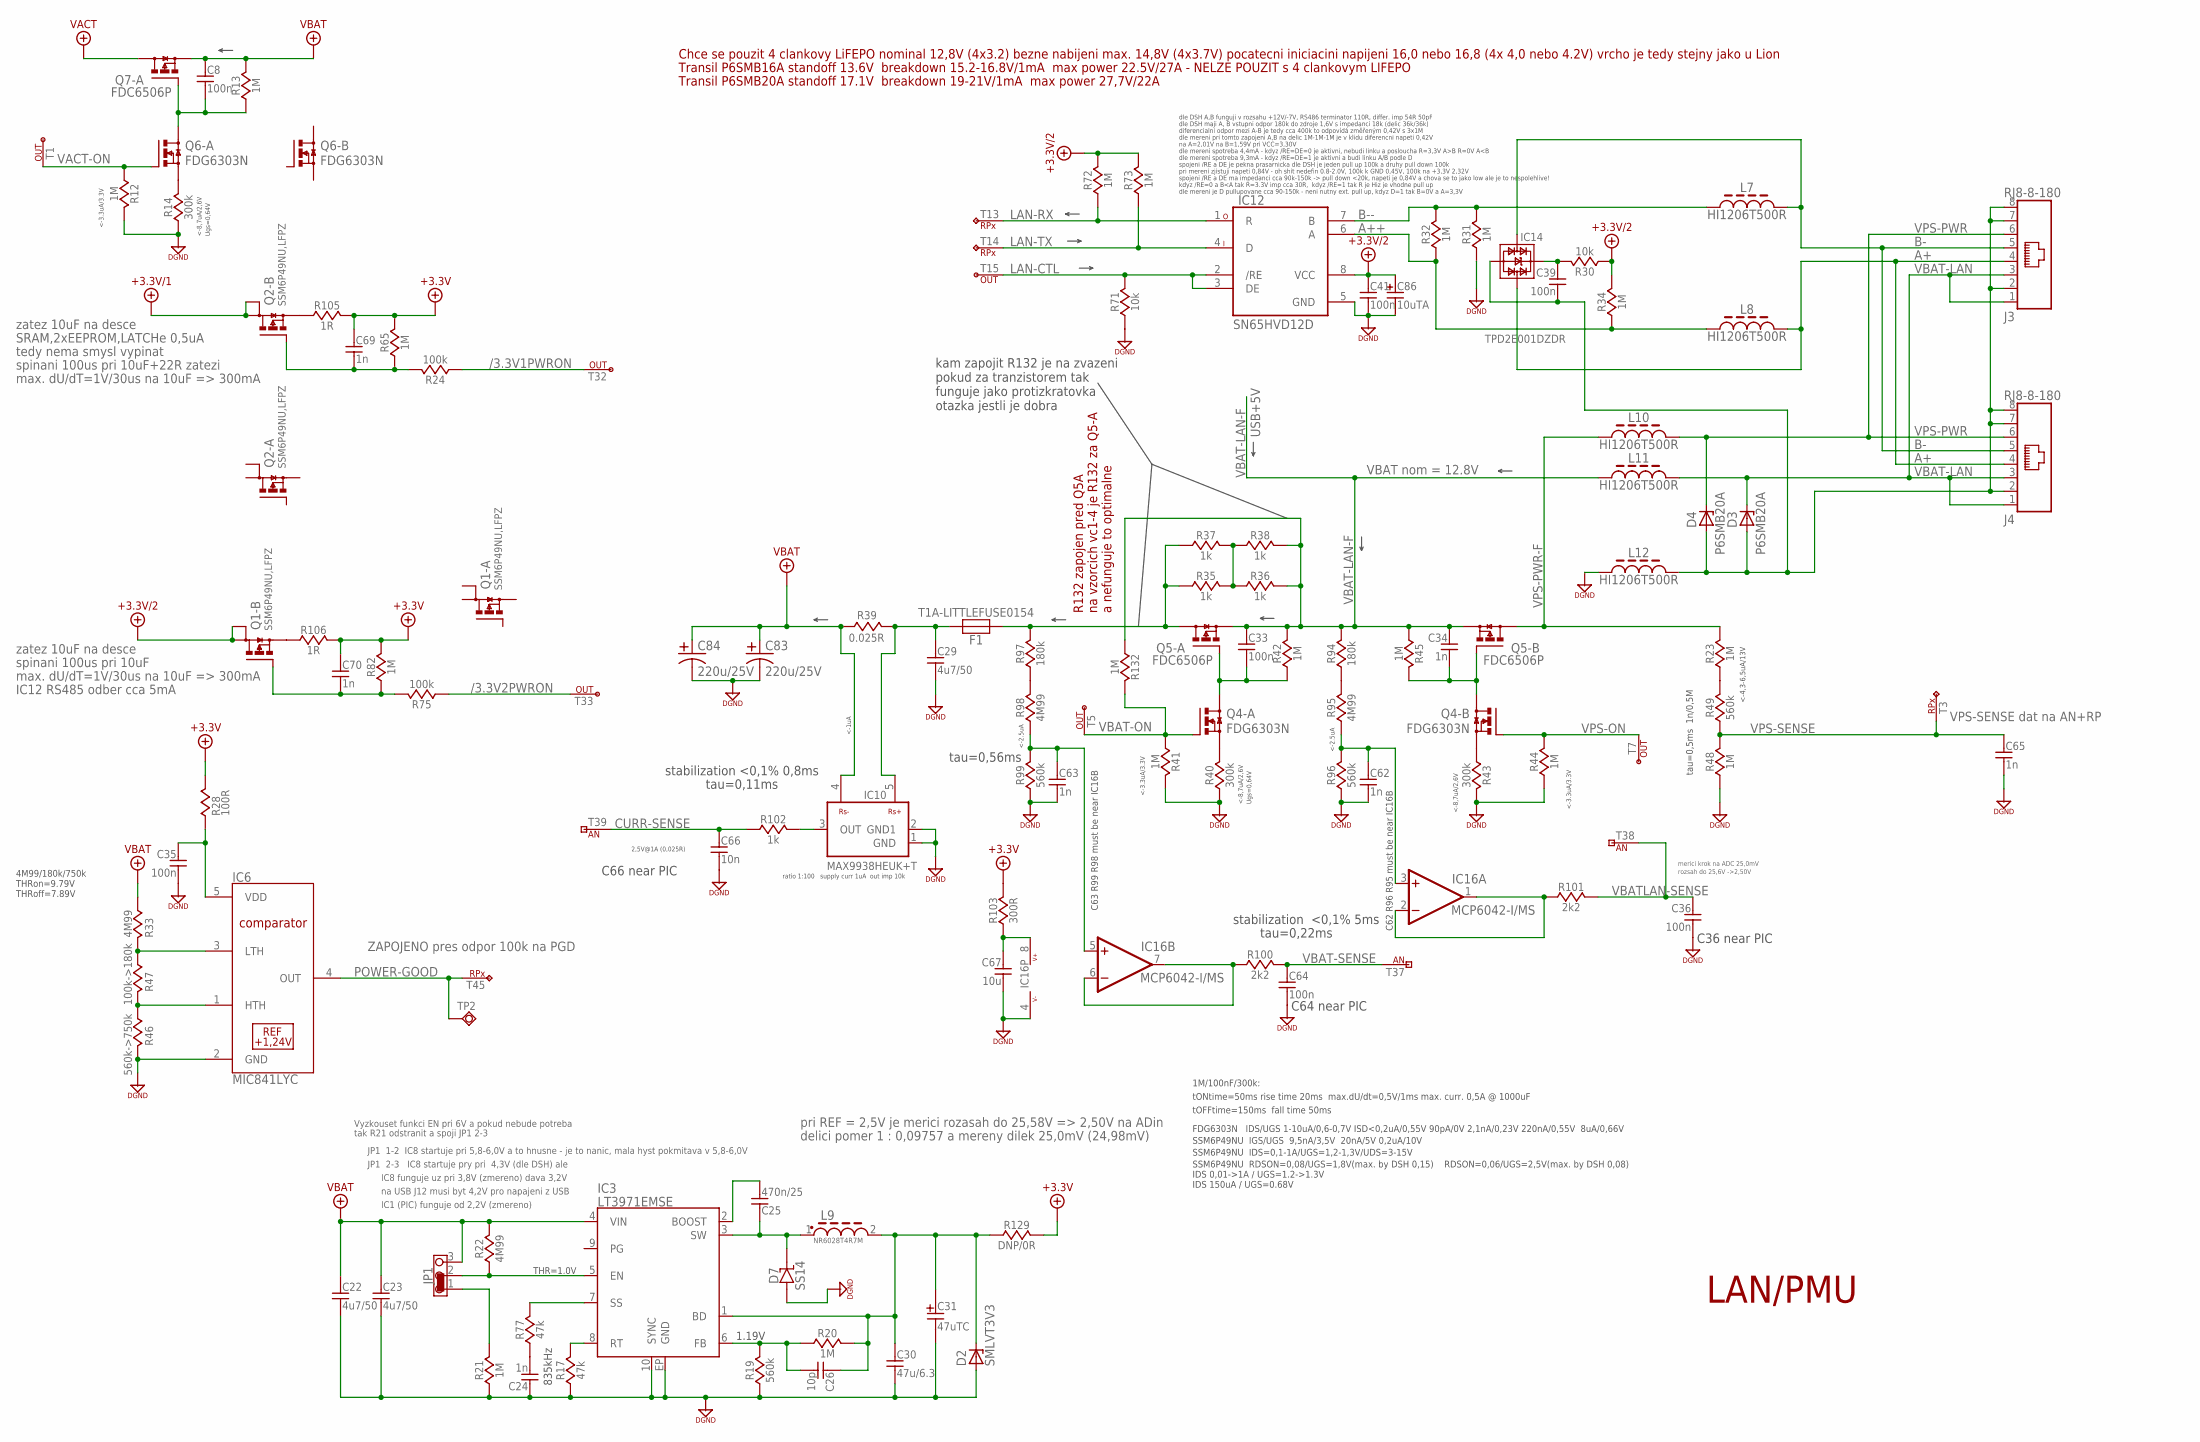
[picture p26: schematic ACB-Lite 3.2.sch, sheet 3]

Parts:
C8, C33, C35, C36, C39, C41, C64: 100n; 0603
C22, C23, C29: 4u7/50; 1206
C24, C34, C62, C63, C65, C69, C70: 1n; 0603
C25: 470n/25; 0603
C26: 10p; 0603
C30: 47u/6.3; 1206
C31: 47uTC; CT-C
C66: 10n; 0603
C67: 10u; 0603
C83, C84: 220u/25V; CAP_8MM_DIA_SMT
C86: 10uTA; 1206-POL-C
D2: SMLVT3V3; SMA
D3, D4: P6SMB20A; SMB
D7: SS14; SMA
F1: T1A-LITTLEFUSE0154; LITTLEFUSE0154
IC3: LT3971EMSE; MSOP10EXP
IC6: MIC841LYC; SC-70-5
IC10: MAX9938HEUK+T; SOT23-5
IC12: SN65HVD12D; SO08
IC14: TPD2E001DZDR; SOT-143
IC16: MCP6042-I/MS; MSOP-08
J3, J4: RJ8-8-180
JP1: JP3CLOSE12
L7, L8, L10, L11, L12: HI1206T500R; 1206
L9: NR6028T4R7M; NR6028
Q1, Q2: SSM6P49NU,LFPZ; MICRO_FET
Q4, Q6: FDG6303N; SC70-6
Q5, Q7: FDC6506P; SSOT-6
R12, R13, R20, R21, R23, R31, R32, R34, R41, R42, R44, R45, R48, R65, R72, R73, R82, R132: 1M; 0603
R14, R40, R43: 300k; 0603
R17, R77: 47k; 0603
R19, R49, R96, R99: 560k; 0603
R22, R33, R95, R98: 4M99; 0603
R24, R75: 100k; 0603
R28: 100R; 0603
R30, R71: 10k; 0603
R35, R36, R37, R38: 1k; 0805
R39: 0.025R; 0805
R46: 560k->750k; 0603
R47: 100k->180k; 0603
R94, R97: 180k; 0603
R100, R101: 2k2; 0603
R102: 1k; 0603
R103: 300R; 0603
R105, R106: 1R; 0805
R129: DNP/0R; 0603
T1, T5, T7, T15, T32, T33: PIC-OUT; TEMP-PAD
T3, T13, T14, T45: PIC-RPX; TEMP-PAD
T37, T38, T39: PIN-AN; TEMP-PAD
TP2: DNP-TestPoint; TH_ROUND_14MM08MM

Connections:
+3,3V-FILT: C35.1, IC6.5 (VDD), R28.1
+3.3V: C69.1, C70.1, R28.2, R65.1, R82.1, R103.2, R105.2, R106.2, R129.1; also elsewhere on the board
+3.3V/1: Q2.3 (D), Q2.P2 (D1); also elsewhere on the board
+3.3V/2: C41.1, C86.+, IC12.8 (VCC), Q1.3 (D), Q1.P2 (D1), R30.2, R34.1, R72.1, R73.2
/3.3V1PWRON: R24.2, T32.P$1; also elsewhere on the board
/3.3V2PWRON: R75.2, T33.P$1; also elsewhere on the board
A+: IC14.3, J3.4, J4.4, L8.2
A++: IC12.6 (A), L8.1, R32.2, R34.2
B-: IC14.2, J3.5, J4.5, L7.2
B--: IC12.7 (B), L7.1, R31.1, R32.1
CURR-SENSE: C66.1, R102.2, T39.P$1; also elsewhere on the board
DGND: C22.2, C23.2, C24.1, C29.2, C30.2, C31.-, C35.2, C36.2, C41.2, C62.2, C63.2, C64.2, C65.2, C66.2, C67.2, C83.2, C84.2, C86.-, D2.- (A), D7.A, IC3.10 (SYNC), IC3.EP (GND), IC6.2 (GND), IC10.1 (GND), IC10.2 (GND1), IC12.5 (GND), IC16.4 (V-), L12.1, R12.2, R14.1, R17.2, R19.2, R21.2, R31.2, R40.1, R41.2, R43.1, R44.2, R46.1, R48.1, R71.2, R96.2, R99.2; also elsewhere on the board
DGND-F: C39.2, D3.A, D4.A, IC14.1, J3.2, J3.7, J3.8, J4.2, J4.7, J4.8, L12.2
GATE-Q12A: C33.2, Q4.6 (D), Q5.1 (G), R42.2
GATE-Q12A1: C8.2, Q6.6 (D), Q7.1 (G), R13.2
GATE-Q12B: C34.2, Q4.3 (D), Q5.3 (G), R45.2
LAN-CTL: IC12.2 (/RE), IC12.3 (DE), R71.1, T15.P$1; also elsewhere on the board
LAN-RX: IC12.1 (R), R72.2, T13.P$1; also elsewhere on the board
LAN-TX: IC12.4 (D), R73.1, T14.P$1; also elsewhere on the board
unnamed: Q6.1 (S), R14.2
unnamed: Q4.1 (S), R40.2
unnamed: Q4.4 (S), R43.2
unnamed: C39.1, IC14.4, R30.1
unnamed: R35.2, R36.1, R37.2, R38.1
unnamed: C29.1, F1.1, IC10.5 (VIN+), R39.2
unnamed: IC6.1 (HTH), R46.2, R47.1
unnamed: IC6.3 (LTH), R33.1, R47.2
unnamed: Q1.4 (S), R106.1
unnamed: F1.2, Q5.6 (D), R35.1, R37.1, R97.1
unnamed: R94.2, R95.1
unnamed: C62.1, IC16.3 (+IN), R95.2, R96.1
unnamed: C26.2, IC3.6 (FB), R19.1, R20.2
unnamed: C24.2, R77.2
unnamed: C25.1, D7.K, IC3.3 (SW), L9.1
unnamed: IC3.8 (RT), R17.1
unnamed: IC3.7 (SS), R77.1
unnamed: IC3.5 (EN), JP1.2, R22.2
unnamed: Q2.4 (S), R105.1
unnamed: C25.2, IC3.2 (BOOST)
unnamed: R97.2, R98.1
unnamed: R23.1, R49.2
unnamed: C63.1, IC16.5 (+IN), R98.2, R99.1
unnamed: IC16.6 (-IN), IC16.7 (OUT), R100.2
unnamed: C67.1, IC16.8 (V+), R103.1
unnamed: IC16.1 (OUT), IC16.2 (-IN), R101.2
unnamed: C69.2, Q2.5 (G), R24.1, R65.2
unnamed: IC10.3 (OUT), R102.1
unnamed: C70.2, Q1.5 (G), R75.1, R82.2
unnamed: JP1.1, R21.1
OUT+3.3V: C26.1, C30.1, C31.+, D2.+ (C), IC3.1 (BD), L9.2, R20.1, R129.2
POWER-GOOD: IC6.4 (OUT), T45.P$1, TP2.P$1; also elsewhere on the board
VACT: Q7.6 (D); also elsewhere on the board
VACT-ON: Q6.2 (G), R12.1, T1.P$1
VBAT: C8.1, C22.1, C23.1, C83.1, C84.1, IC3.4 (VIN), IC10.4 (VIN-), JP1.3, Q7.5 (S), R13.1, R22.1, R33.2, R39.1; also elsewhere on the board
VBAT-LAN: D3.C, J3.1, J3.3, J4.1, J4.3, L11.2
VBAT-LAN-F: C33.1, C34.1, L11.1, Q5.2 (S), Q5.5 (S), R36.2, R38.2, R42.1, R45.1, R94.1, R132.1; also elsewhere on the board
VBAT-ON: Q4.2 (G), R41.1, R132.2, T5.P$1; also elsewhere on the board
VBAT-SENSE: C64.1, R100.1, T37.P$1; also elsewhere on the board
VBATLAN-SENSE: C36.1, R101.1, T38.P$1; also elsewhere on the board
VPS-ON: Q4.5 (G), R44.1, T7.P$1; also elsewhere on the board
VPS-PWR: D4.C, J3.6, J4.6, L10.2
VPS-PWR-F: L10.1, Q5.4 (D), R23.2
VPS-SENSE: C65.1, R48.2, R49.1, T3.P$1; also elsewhere on the board

Notes on the sheet:
<-8,7uA/2,6V
Ugs=0,64V
<-4,3-6,5uA/13V
<-3.3uA/3.3V
tau=0,5ms 1n/0,5M
Chce se pouzit 4 clankovy LiFEPO nominal 12,8V (4x3.2) bezne nabijeni max. 14,8V (4x3.7V) pocatecni iniciacini napijeni 16,0 nebo 16,8 (4x 4,0 nebo 4.2V) vrcho je tedy stejny jako u Lion
Transil P6SMB16A standoff 13.6V breakdown 15.2-16.8V/1mA max power 22.5V/27A - NELZE POUZIT s 4 clankovym LIFEPO
Transil P6SMB20A standoff 17.1V breakdown 19-21V/1mA max power 27,7V/22A
FDG6303N IDS/UGS 1-10uA/0,6-0,7V ISD<0,2uA/0,55V 90pA/0V 2,1nA/0,23V 220nA/0,55V 8uA/0,66V
SSM6P49NU IGS/UGS 9,5nA/3,5V 20nA/5V 0,2uA/10V
SSM6P49NU IDS=0,1-1A/UGS=1,2-1,3V/UDS=3-15V
SSM6P49NU RDSON=0,08/UGS=1,8V(max. by DSH 0,15) RDSON=0,06/UGS=2,5V(max. by DSH 0,08)
tONtime=50ms rise time 20ms max.dU/dt=0,5V/1ms max. curr. 0,5A @ 1000uF
tOFFtime=150ms fall time 50ms
1M/100nF/300k:
IDS 150uA / UGS=0.68V
IDS 0,01->1A / UGS=1.2->1.3V
ratio 1:100 supply curr 1uA out imp 10k
2,5V@1A (0,025R)
VBAT nom = 12.8V
diferencialni odpor mezi A-B je tedy cca 400k to odpovídá změřeným 0,42V s 3x1M
dle mereni spotreba 4,4mA - kdyz /RE=DE=0 je aktivni, nebudi linku a posloucha R=3,3V A>B R=0V A<B
dle mereni pri tomto zapojeni A,B na delic 1M-1M-1M je v klidu diferencni napeti 0,42V
spojeni /RE a DE ma impedanci cca 90k-150k -> pull down <20k, napeti je 0,84V a chova se to jako low ale je to nespolehlive!
spojeni /RE a DE je pekna prasarnicka dle DSH je jeden pull up 100k a druhy pull down 100k
dle mereni spotreba 9,3mA - kdyz /RE=DE=1 je aktivni a budi linku A/B podle D
pri mereni zjistuji napeti 0,84V - oh shit nedefin 0.8-2.0V, 100k k GND 0,45V, 100k na +3,3V 2,32V
dle mereni je D pullupovane cca 90-150k - neni nutny ext. pull up, kdyz D=1 tak B=0V a A=3,3V
kdyz /RE=0 a B<A tak R=3.3V imp cca 30R, kdyz /RE=1 tak R je Hiz je vhodne pull up
dle DSH maji A, B vstupni odpor 180k do zdroje 1,6V s impedanci 18k (delic 36k/36k)
na A=2,01V na B=1,59V pri VCC=3,30V
835kHz
1.19V
THR=1.0V
dle DSH A,B funguji v rozsahu +12V/-7V, RS486 terminator 110R, differ. imp 54R 50pF
tau=0,22ms
tau=0,56ms
stabilization <0,1% 5ms
tau=0,11ms
stabilization <0,1% 0,8ms
<-2.5uA
<-1uA
C63 R99 R98 must be near IC16B
C64 near PIC
VPS-SENSE dat na AN+RP
ZAPOJENO pres odpor 100k na PGD
pri REF = 2,5V je merici rozasah do 25,58V => 2,50V na ADin
delici pomer 1 : 0,09757 a mereny dilek 25,0mV (24,98mV)
rozsah do 25,6V ->2,50V
merici krok na ADC 25,0mV
JP1 1-2 IC8 startuje pri 5,8-6,0V a to hnusne - je to nanic, mala hyst pokmitava v 5,8-6,0V
JP1 2-3 IC8 startuje pry pri 4,3V (dle DSH) ale
Vyzkouset funkci EN pri 6V a pokud nebude potreba
tak R21 odstranit a spoji JP1 2-3
R132 zapojen pred Q5A na vzorcich vc1-4 je R132 za Q5-A a nefunguje to optimalne
zatez 10uF na desce
SRAM,2xEEPROM,LATCHe 0,5uA
spinani 100us pri 10uF+22R zatezi
max. dU/dT=1V/30us na 10uF => 300mA
spinani 100us pri 10uF
IC12 RS485 odber cca 5mA
IC8 funguje uz pri 3,8V (zmereno) dava 3,2V
IC1 (PIC) funguje od 2,2V (zmereno)
na USB J12 musi byt 4,2V pro napajeni z USB
tedy nema smysl vypinat
USB+5V
C36 near PIC
C66 near PIC
C62 R96 R95 must be near IC16B
4M99/180k/750k THRon=9.79V THRoff=7.89V
kam zapojit R132 je na zvazeni pokud za tranzistorem tak funguje jako protizkratovka otazka jestli je dobra
LAN/PMU

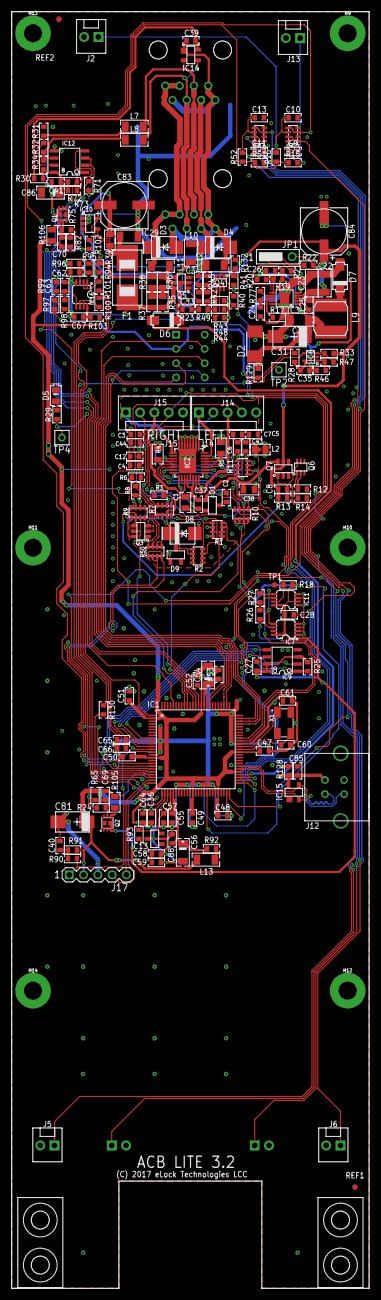
[picture p27: board ACB-Lite 3.2.brd from above]

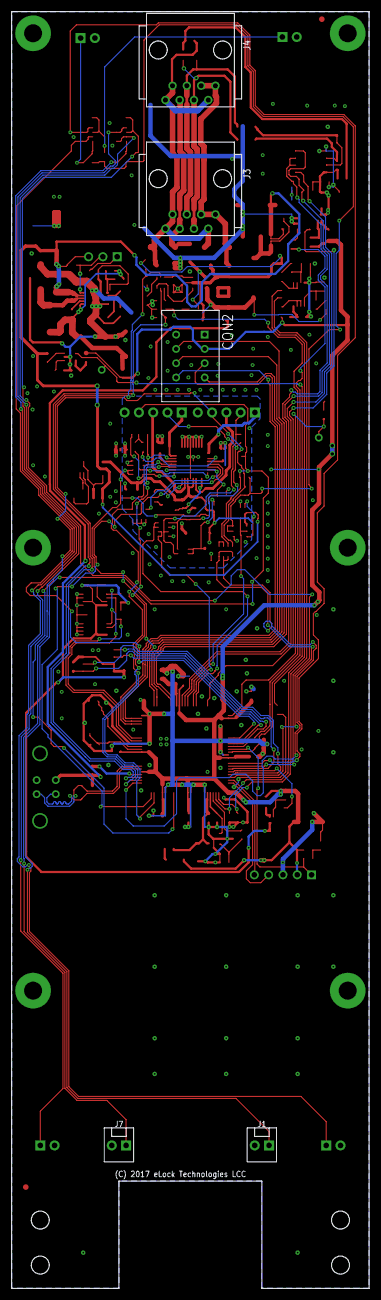
[picture p28: board ACB-Lite 3.2.brd from below]

Board: 2 copper layers, 63.5 x 226.8 mm, 246 parts (5 on the bottom side), 133 nets.

Other parts of the board:
H1, H2: CAM-HOLDER
