alleybeachelectric/Gen6/ACB/ignore/boardACBlight/boardACBlight/PCB_eLock_G592_J1_only_actuators.brd

## EAGLE design ACB/ignore/boardACBlight/boardACBlight/PCB_eLock_G592_J1_only_actuators.brd (2018-02-23)

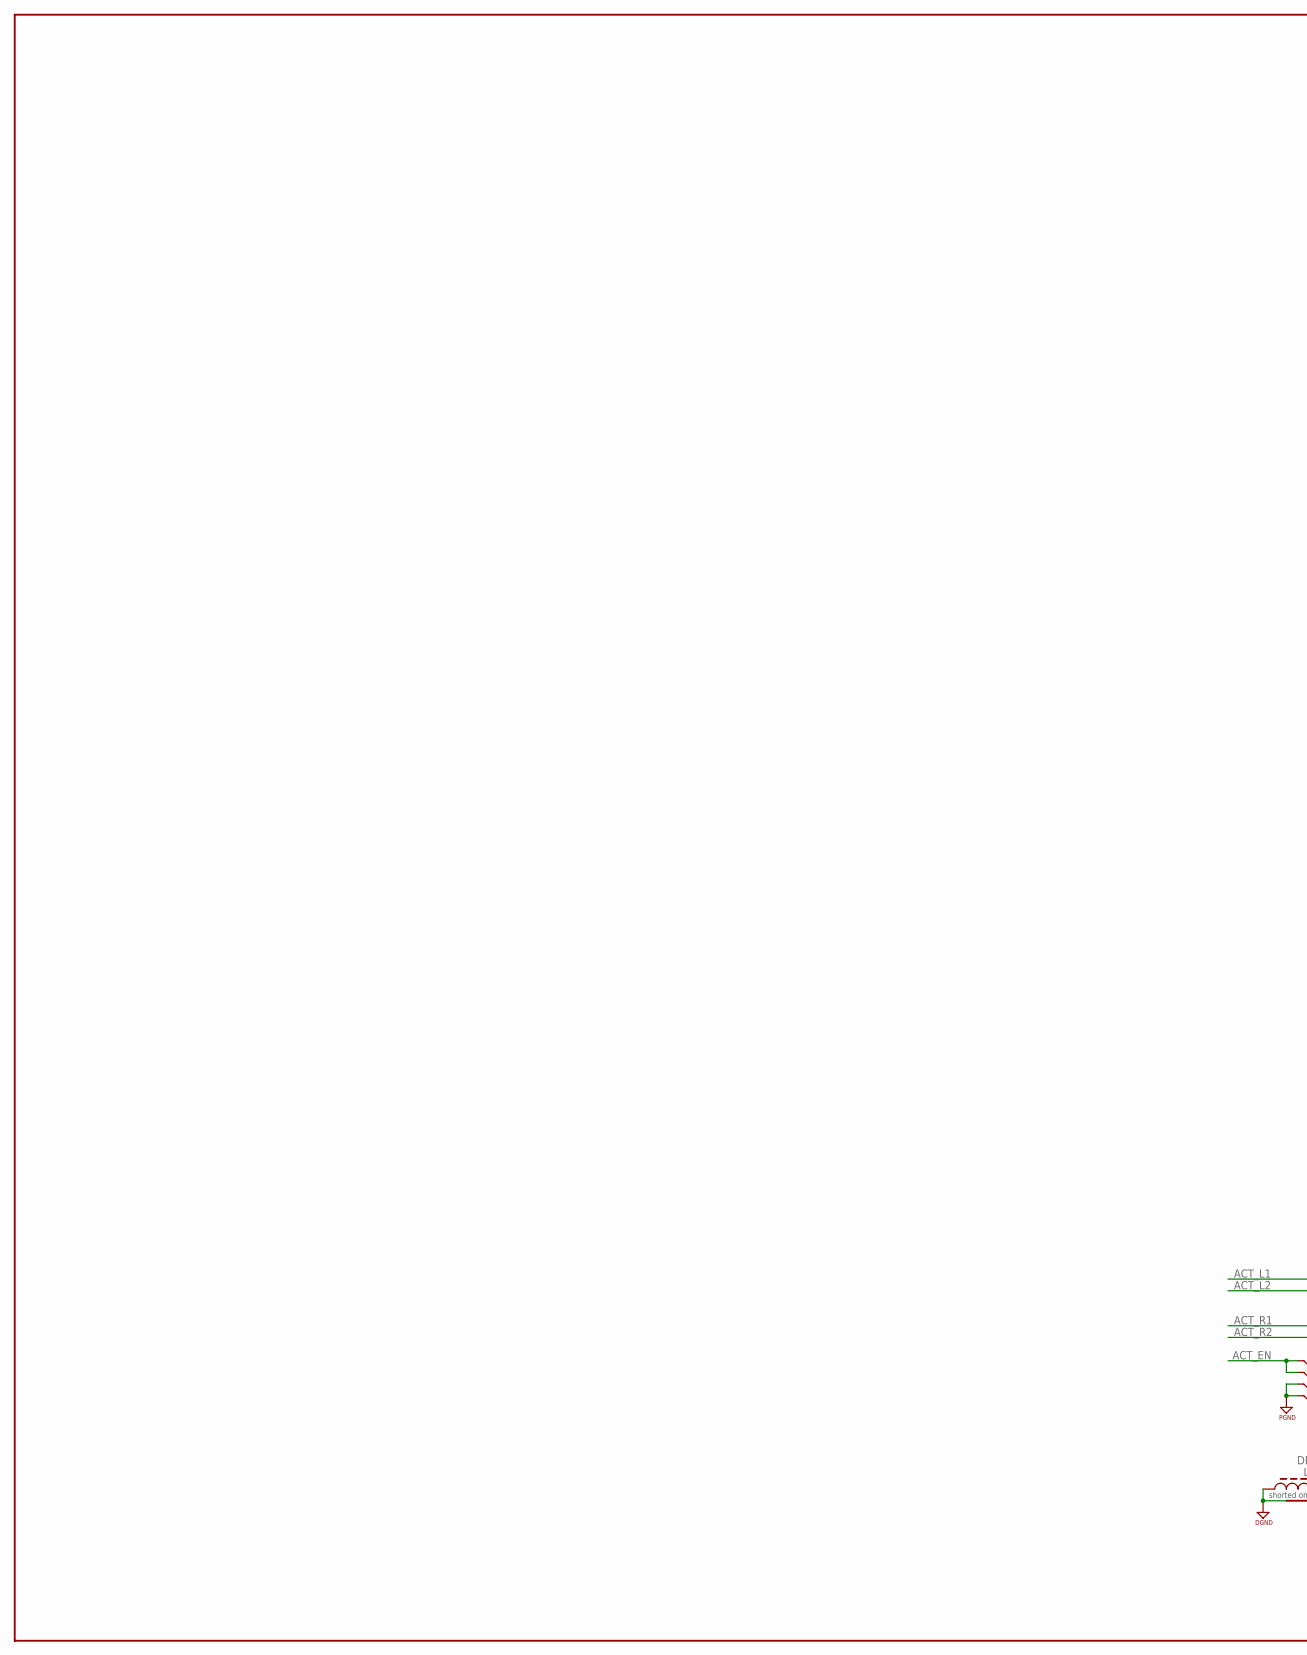
[picture p29: schematic PCB_eLock_G592_J1_only_actuators.sch, part in row 1, column 1]

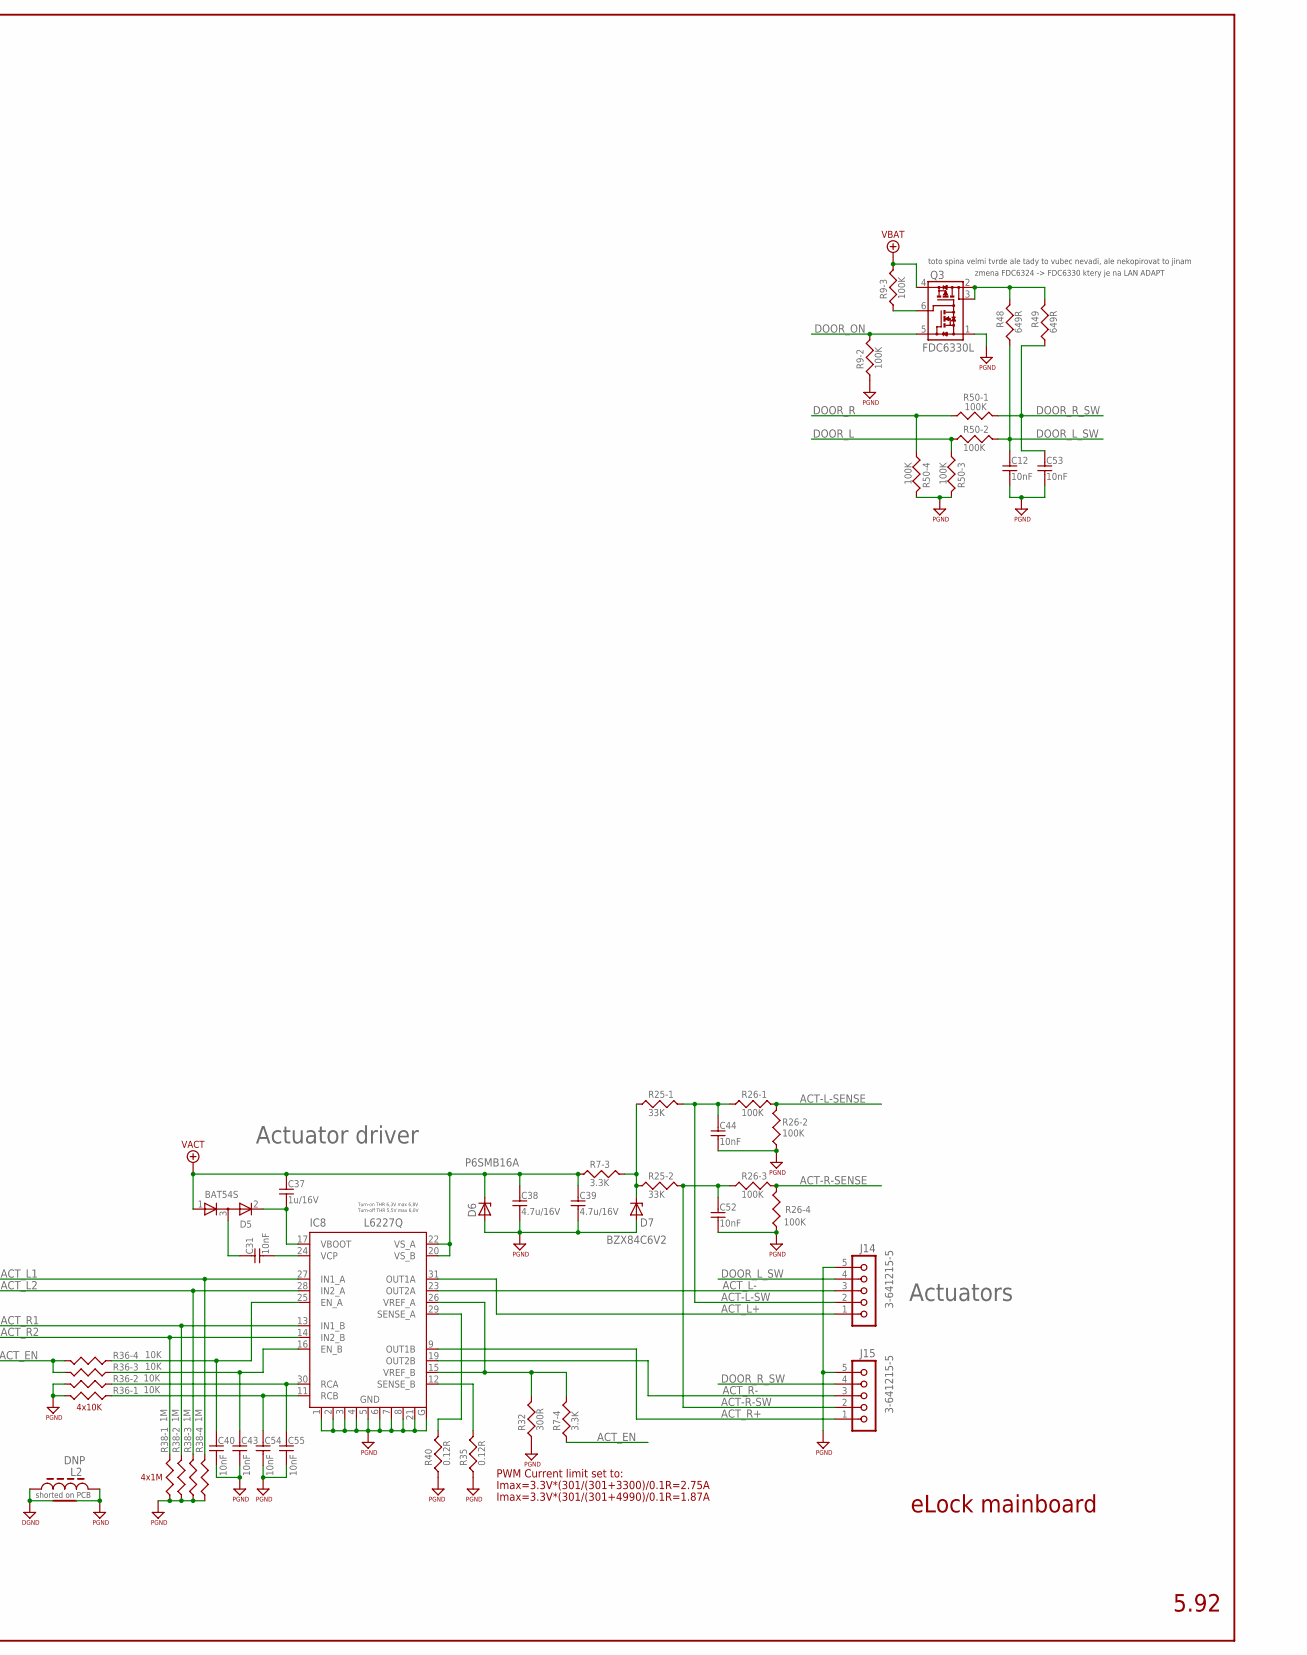
[picture p30: schematic PCB_eLock_G592_J1_only_actuators.sch, part in row 1, column 2]

Parts:
C12, C31, C40, C43, C44, C52, C53, C54, C55: 10nF; 0603
C37: 1u/16V; 0603
C38, C39: 4.7u/16V; 0805
D5: BAT54S; SOT-23
D6: P6SMB16A; SMB
D7: BZX84C6V2; SOT-23
IC8: L6227Q; SQFP-S-5X5-32
J14, J15: 3-641215-5
L2: DNP; 0805-0RTOP
Q3: FDC6330L; SSOT-6
R7: 3.3K; 0603-ARRAY
R9, R26, R50: 100K; 0603-ARRAY
R25: 33K; 0603-ARRAY
R32: 300R; 0603
R35, R40: 0.12R; 0805
R36: 10K; 0603-ARRAY
R38: 1M; 0603-ARRAY
R48, R49: 649R; 0603

Connections:
ACT-L-SENSE: R26.7 (2), R26.8 (2)
ACT-L-SW: C44.1, J14.2, R25.8 (2), R26.1
ACT-R-SENSE: R26.5 (2), R26.6 (2)
ACT-R-SW: C52.1, J15.2, R25.7 (2), R26.3 (1)
ACT_EN: R7.4 (1), R36.5 (2), R36.6 (2)
ACT_L1: IC8.27 (IN1_A), R38.5 (2)
ACT_L2: IC8.28 (IN2_A), R38.6 (2)
ACT_L+: IC8.31 (OUT1A), J14.1
ACT_L-: IC8.23 (OUT2A), J14.3
ACT_R1: IC8.13 (IN1_B), R38.7 (2)
ACT_R2: IC8.14 (IN2_B), R38.8 (2)
ACT_R+: IC8.9 (OUT1B), J15.1
ACT_R-: IC8.19 (OUT2B), J15.3
DGND: L2.2
DOOR_L: R50.2 (1), R50.3 (1)
DOOR_L_SW: C12.1, J14.4, R48.2, R50.7 (2)
DOOR_ON: Q3.5 (Q1G), R9.7 (2)
DOOR_R: R50.1, R50.4 (1)
DOOR_R_SW: C53.1, J15.4, R49.2, R50.8 (2)
unnamed: C31.2, IC8.24 (VCP)
unnamed: C31.1, D5.3 (KA)
unnamed: D7.3 (C), R7.6 (2), R25.1, R25.2 (1)
unnamed: IC8.12 (SENSE_B), R35.2
unnamed: Q3.6 (Q2G), R9.3 (1)
unnamed: Q3.2 (Q2D1), Q3.3 (Q2D2), R48.1, R49.1
unnamed: IC8.29 (SENSE_A), R40.2
unnamed: C37.2, D5.2 (K), IC8.17 (VBOOT)
unnamed: C54.1, IC8.11 (RCB), R36.1
unnamed: C40.1, IC8.25 (EN_A), R36.4 (1)
unnamed: C43.1, IC8.16 (EN_B), R36.3 (1)
unnamed: C55.1, IC8.30 (RCA), R36.2 (1)
unnamed: IC8.15 (VREF_B), IC8.26 (VREF_A), R7.5 (2), R32.2
PGND: C12.2, C38.2, C39.2, C40.2, C43.2, C44.2, C52.2, C53.2, C54.2, C55.2, D6.A, D7.1 (A), IC8.1 (GND1), IC8.2 (GND2), IC8.3 (GND3), IC8.4 (GND4), IC8.5 (GND5), IC8.6 (GND6), IC8.7 (GND7), IC8.8 (GND8), IC8.21 (GND21), IC8.G (GNEXP), J14.5, J15.5, L2.1, Q3.1 (Q1S), R9.2 (1), R26.2 (1), R26.4 (1), R32.1, R35.1, R36.7 (2), R36.8 (2), R38.1, R38.2 (1), R38.3 (1), R38.4 (1), R40.1, R50.5 (2), R50.6 (2)
VACT: C37.1, C38.1, C39.1, D5.1 (A), D6.C, IC8.20 (VS_B), IC8.22 (VS_A), R7.3 (1)
VBAT: Q3.4 (Q2S), R9.6 (2)

Notes on the sheet:
Actuator driver
Actuators
4x10K
4x1M
5.92
eLock mainboard
PWM Current limit set to:
Imax=3.3V*(301/(301+3300)/0.1R=2.75A
Imax=3.3V*(301/(301+4990)/0.1R=1.87A
Turn-on THR 6,3V max 6,8V
Turn-off THR 5,5V max 6,0V
toto spina velmi tvrde ale tady to vubec nevadi, ale nekopirovat to jinam
zmena FDC6324 -> FDC6330 ktery je na LAN ADAPT
shorted on PCB

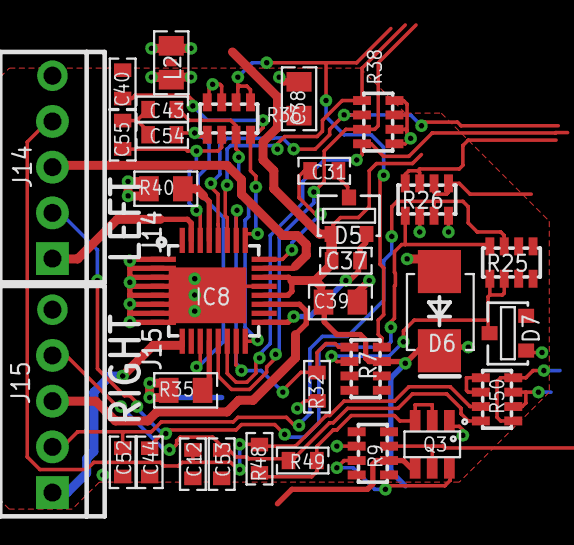
[picture p31: board PCB_eLock_G592_J1_only_actuators.brd from above]

Board: 2 copper layers, 32 parts (0 on the bottom side), 34 nets.
