alleybeachelectric/Gen6/ACB/ACB/ACB-R1.0-43-CH09/ACB(old)/vps-r2.0-20-with-description.brd

## EAGLE design ACB/ACB/ACB-R1.0-43-CH09/ACB(old)/vps-r2.0-20-with-description.brd (2018-02-02, an earlier design)

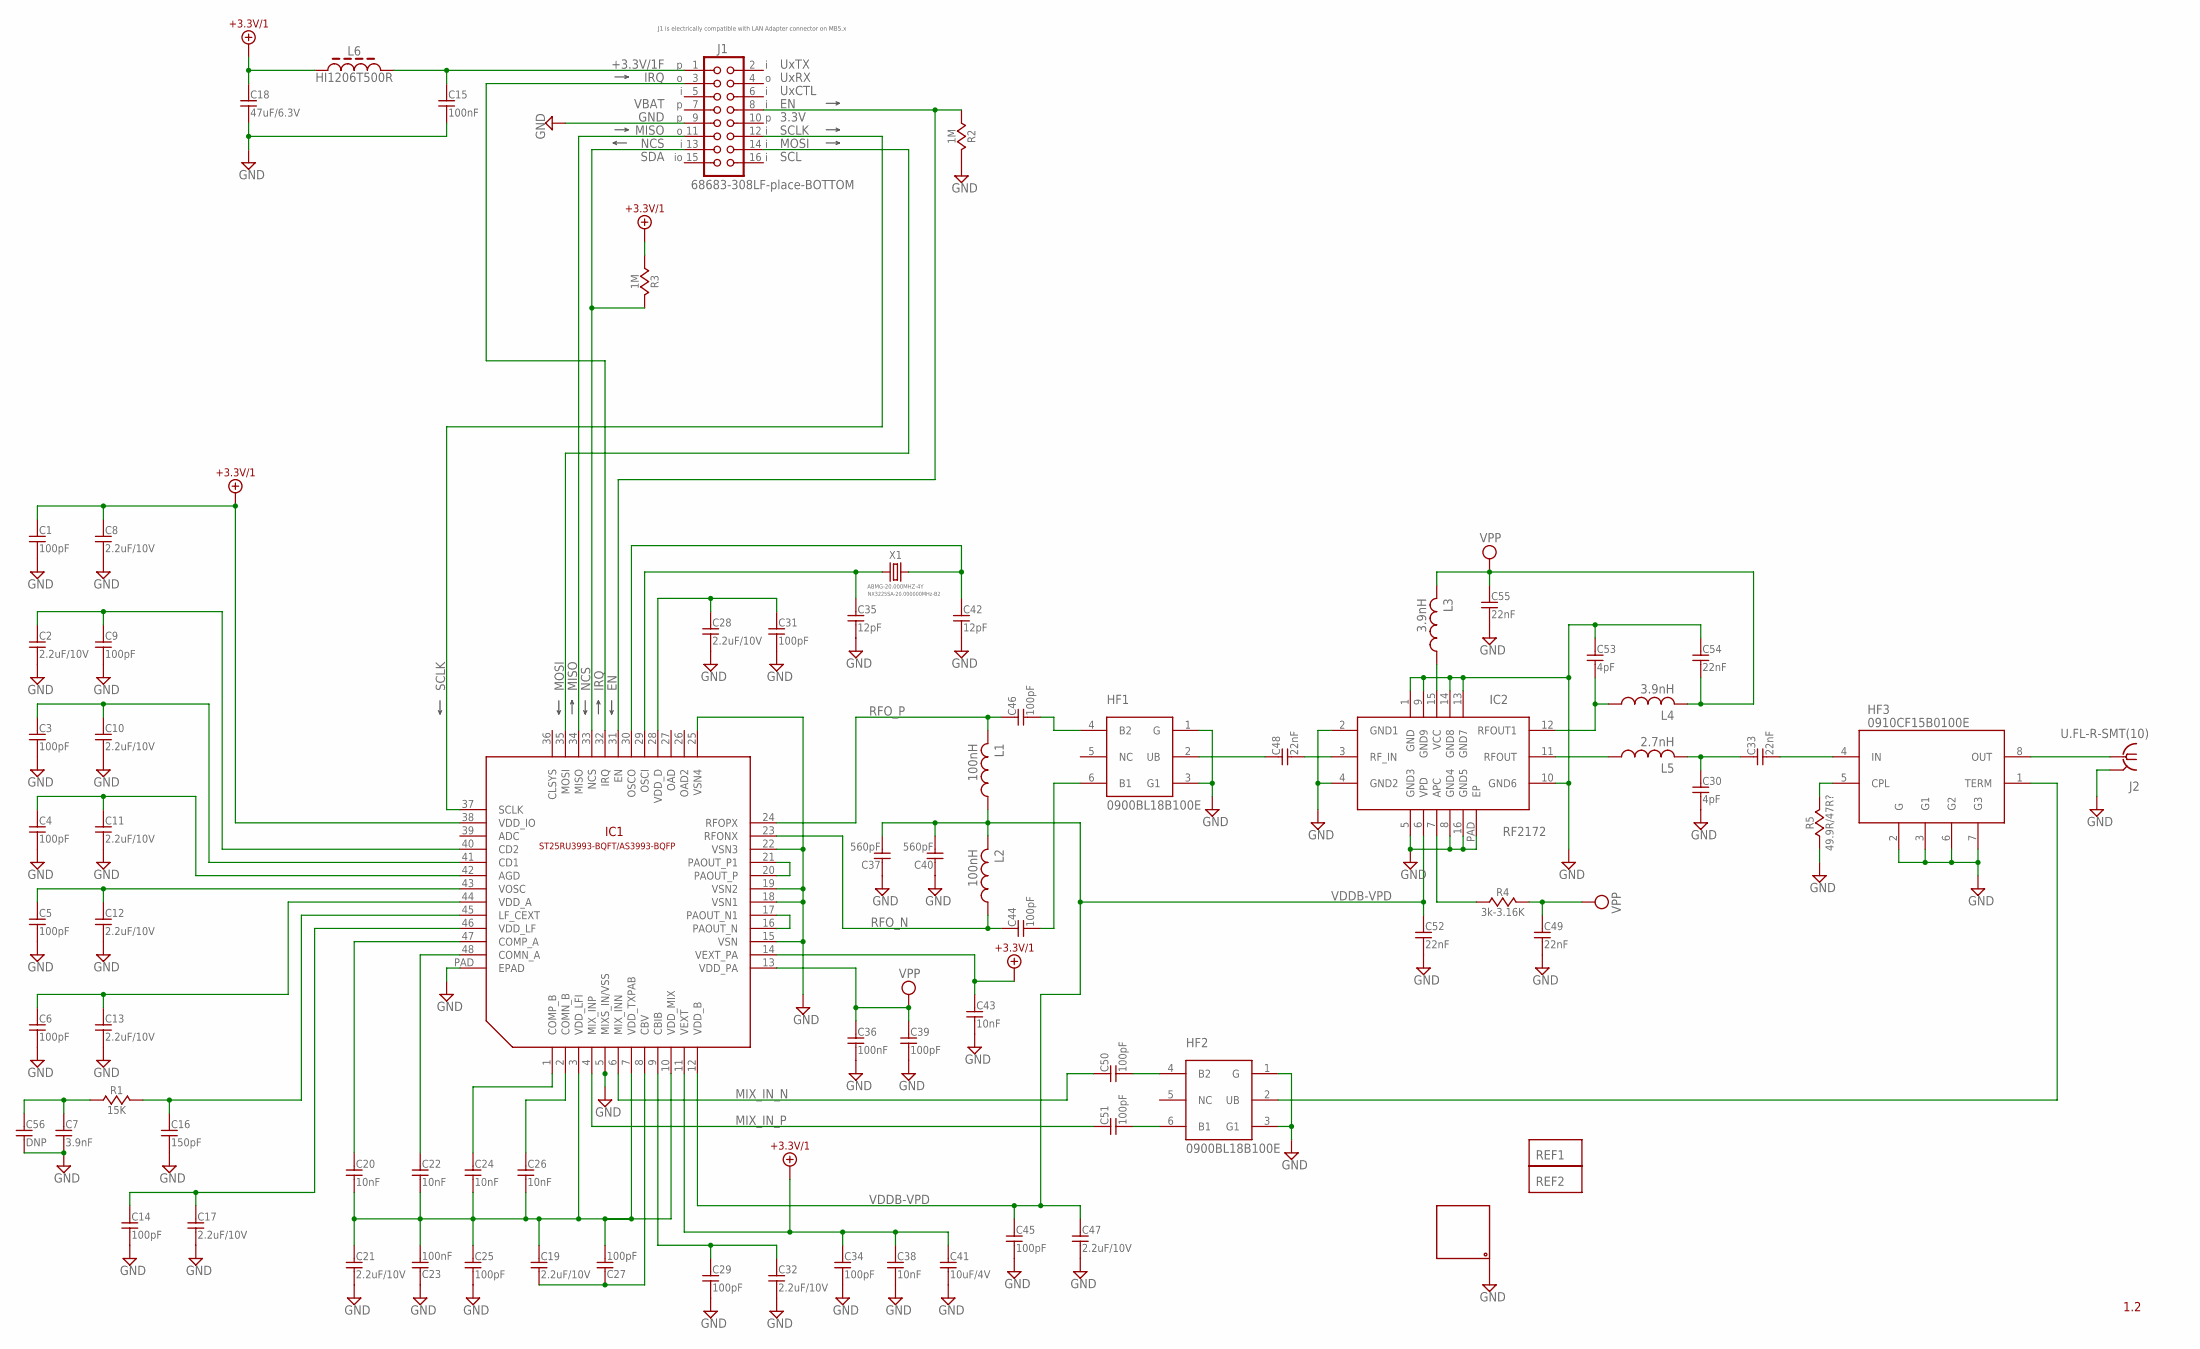
[picture p32: schematic vps-r2.0-20-with-description.sch]

Parts:
C1, C3, C4, C5, C6, C9, C14, C25, C27, C29, C31, C34, C39, C44, C45, C46, C50, C51: 100pF; 0603
C2, C8, C10, C11, C12, C13, C17, C19, C21, C28, C32, C47: 2.2uF/10V; 0603
C7: 3.9nF; 0603
C15, C23, C36: 100nF; 0603
C16: 150pF; 0603
C18: 47uF/6.3V; 1206
C20, C22, C24, C26, C38, C43: 10nF; 0603
C30, C53: 4pF; 0603
C33, C48, C49, C52, C54, C55: 22nF; 0603
C35, C42: 12pF; 0603
C37, C40: 560pF; 0603
C41: 10uF/4V; 0603
C56: DNP; 0603
HF1, HF2: 0900BL18B100E; JTIBALUN; MPN 0900BL18B100E; DIGIKEY 712-1023-1-ND
HF3: 0910CF15B0100E; JTICPL
IC1: ST25RU3993-BQFT/AS3993-BQFP; LFCSP_7X7_48
IC2: RF2172; QFN164X4
J1: 68683-308LF-place-BOTTOM; MA08-2
J2: U.FL-R-SMT(10); MC-921
L1, L2: 100nH; L0603
L3, L4: 3.9nH; L0603
L5: 2.7nH; L0603
L6: HI1206T500R; 1206
PCB1: PCB-VPS-1; PCB-VPS
R1: 15K; 0603
R2, R3: 1M; 0603
R4: 3k-3.16K; 0603
R5: 49.9R/47R?; 0603
REF1, REF2: REF
X1: ABMG-20.000MHZ-4Y; 7M

Connections:
+3.3V/1: C1.1, C8.1, C18.1, C34.1, C38.1, C41.1, C43.1, IC1.11 (VEXT), IC1.14 (VEXT_PA), IC1.38 (VDD_IO), L6.1, R3.1
+3.3V/1F: C15.1, J1.1, L6.2
APC: IC2.7 (APC), R4.1
EN: IC1.31 (EN), J1.8, R2.1
GND: C1.2, C2.2, C3.2, C4.2, C5.2, C6.2, C7.2, C8.2, C9.2, C10.2, C11.2, C12.2, C13.2, C14.2, C15.2, C16.2, C17.2, C18.2, C21.2, C23.1, C25.2, C28.2, C29.2, C30.2, C31.2, C32.2, C34.2, C35.2, C36.2, C37.1, C38.2, C39.2, C40.1, C41.2, C42.2, C43.2, C45.2, C47.2, C49.2, C52.2, C53.1, C54.1, C55.2, C56.2, HF1.1 (G), HF1.3 (G1), HF2.1 (G), HF2.3 (G1), HF3.2 (G), HF3.3 (G1), HF3.6 (G2), HF3.7 (G3), IC1.5 (MIXS_IN/VSS), IC1.15 (VSN), IC1.18 (VSN1), IC1.19 (VSN2), IC1.22 (VSN3), IC1.25 (VSN4), IC1.PAD (EPAD), IC2.1 (GND), IC2.2 (GND1), IC2.4 (GND2), IC2.5 (GND3), IC2.8 (GND4), IC2.9 (GND9), IC2.10 (GND6), IC2.13 (GND7), IC2.14 (GND8), IC2.16 (GND5), IC2.PAD (EP), J1.9, J2.2@1 (GND), J2.2@2 (GND), PCB1.VPS_PCB_1, R2.2, R5.1
IRQ: IC1.32 (IRQ), J1.3
MISO: IC1.34 (MISO), J1.11
MIX_IN_N: C50.1, IC1.6 (MIX_INN)
MIX_IN_P: C51.1, IC1.4 (MIX_INP)
MOSI: IC1.35 (MOSI), J1.14
unnamed: C7.1, C56.1, R1.1
unnamed: C16.1, IC1.45 (LF_CEXT), R1.2
unnamed: C20.1, IC1.47 (COMP_A)
unnamed: C22.1, IC1.48 (COMN_A)
unnamed: C24.1, IC1.1 (COMP_B)
unnamed: C26.1, IC1.2 (COMN_B)
unnamed: C6.1, C13.1, IC1.44 (VDD_A)
unnamed: C5.1, C12.1, IC1.43 (VOSC)
unnamed: C19.2, C27.1, IC1.8 (CBV)
unnamed: C4.1, C11.1, IC1.42 (AGD)
unnamed: C14.1, C17.1, IC1.46 (VDD_LF)
unnamed: C3.1, C10.1, IC1.41 (CD1)
unnamed: C2.1, C9.1, IC1.40 (CD2)
unnamed: C51.2, HF2.6 (B1)
unnamed: C29.1, C32.1, IC1.9 (CBIB)
unnamed: C35.1, IC1.29 (OSCI), X1.1
unnamed: C42.1, IC1.30 (OSCO), X1.3 (2)
unnamed: IC1.20 (PAOUT_P), IC1.21 (PAOUT_P1)
unnamed: IC1.16 (PAOUT_N), IC1.17 (PAOUT_N1)
unnamed: C30.1, C33.1, L5.2
unnamed: C33.2, HF3.4 (IN)
unnamed: C46.2, HF1.4 (B2)
unnamed: HF3.5 (CPL), R5.2
unnamed: C44.2, HF1.6 (B1)
unnamed: C48.1, HF1.2 (UB)
unnamed: HF2.2 (UB), HF3.1 (TERM)
unnamed: HF3.8 (OUT), J2.1
unnamed: C28.1, C31.1, IC1.28 (VDD_D)
unnamed: C50.2, HF2.4 (B2)
NCS: IC1.33 (NCS), J1.13, R3.2
RFIN: C48.2, IC2.3 (RF_IN)
RFOUT: IC2.11 (RFOUT), L5.1
RFOUT1: C53.2, IC2.12 (RFOUT1), L4.1
RFO_N: C44.1, IC1.23 (RFONX), L2.1
RFO_P: C46.1, IC1.24 (RFOPX), L1.2
SCLK: IC1.37 (SCLK), J1.12
VDD-FLI-MIX-TXPAB: C19.1, C20.2, C21.1, C22.2, C23.2, C24.2, C25.1, C26.2, C27.2, IC1.3 (VDD_LFI), IC1.7 (VDD_TXPAB), IC1.10 (VDD_MIX)
VDDB-VPD: C37.2, C40.2, C45.1, C47.1, C52.1, IC1.12 (VDD_B), IC2.6 (VPD), L1.1, L2.2
VPP: C36.1, C39.1, C49.1, C54.2, C55.1, IC1.13 (VDD_PA), L3.2, L4.2, R4.2
VPP3,9NH: IC2.15 (VCC), L3.1

Notes on the sheet:
1.2
J1 is electrically compatible with LAN Adapter connector on MB5.x
SCL
SDA
VBAT
UxTX
UxRX
3.3V
UxCTL
NX3225SA-20.000000MHz-B2

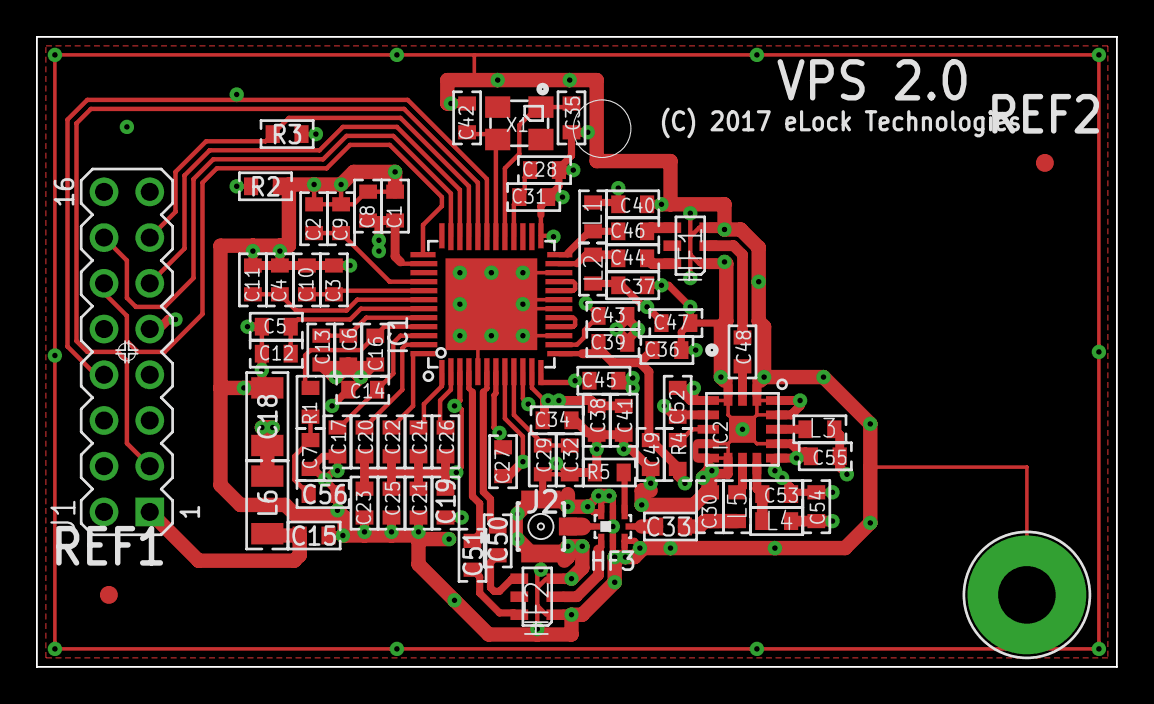
[picture p33: board vps-r2.0-20-with-description.brd from above]

Board: 4 copper layers, 60.0 x 35.0 mm, 78 parts (0 on the bottom side), 50 nets.
