alleybeachelectric/Gen6/ACB/ignore/boardACBlight/boardACBlight/PCB_eLock_G592_J1.brd

## EAGLE design ACB/ignore/boardACBlight/boardACBlight/PCB_eLock_G592_J1.brd (2018-02-23)

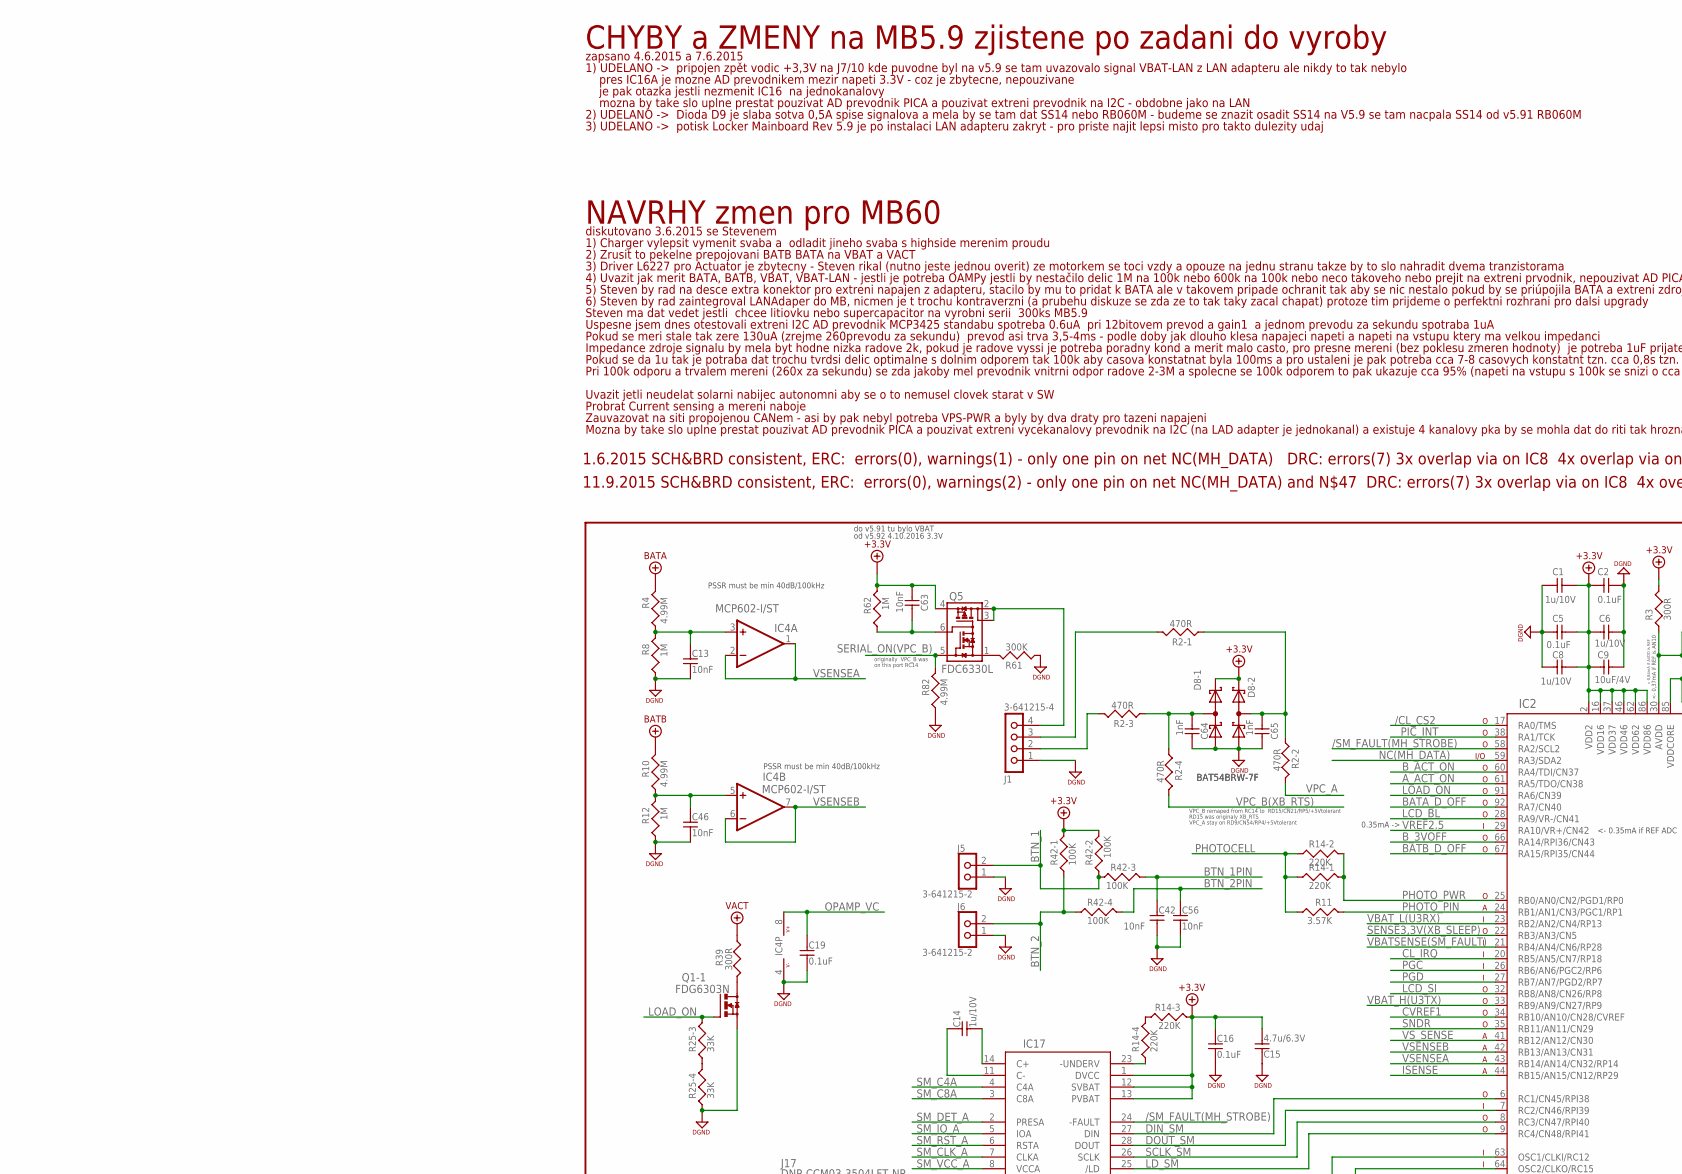
[picture p34: schematic PCB_eLock_G592_J1.sch, part in row 1, column 1]

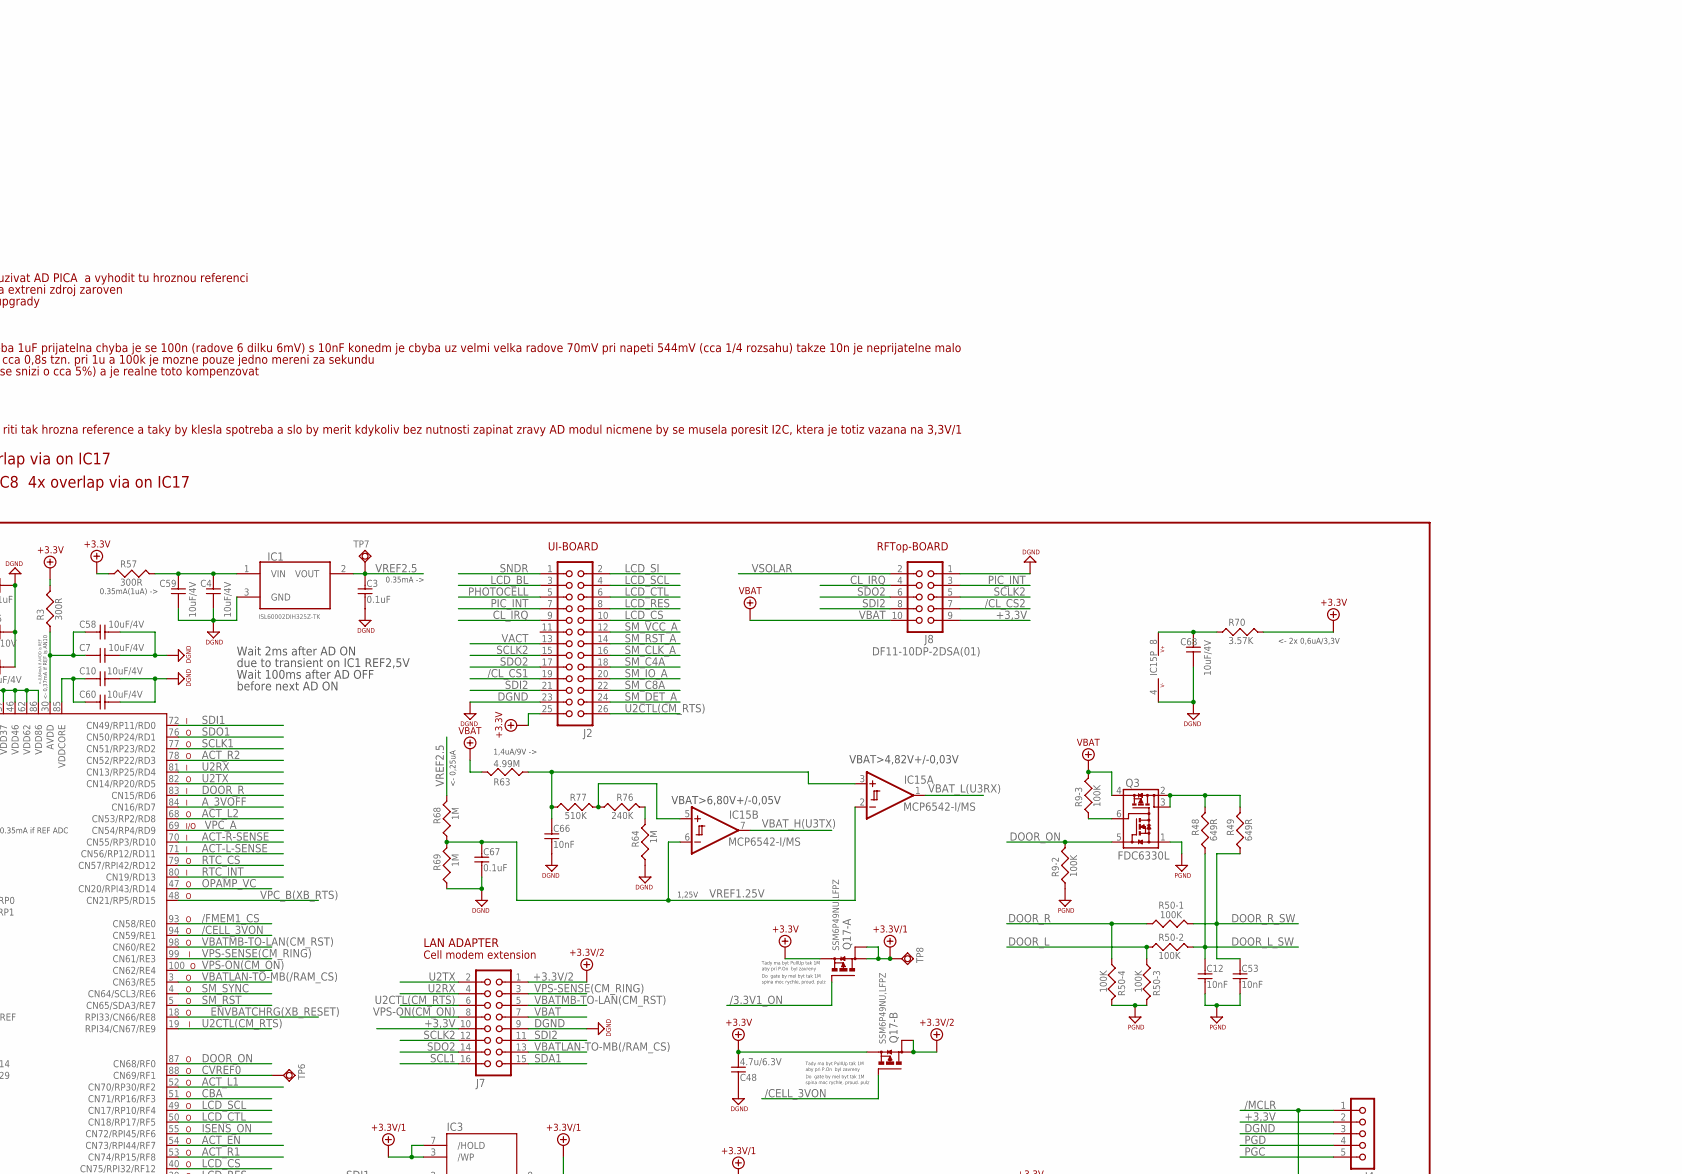
[picture p35: schematic PCB_eLock_G592_J1.sch, part in row 1, column 2]

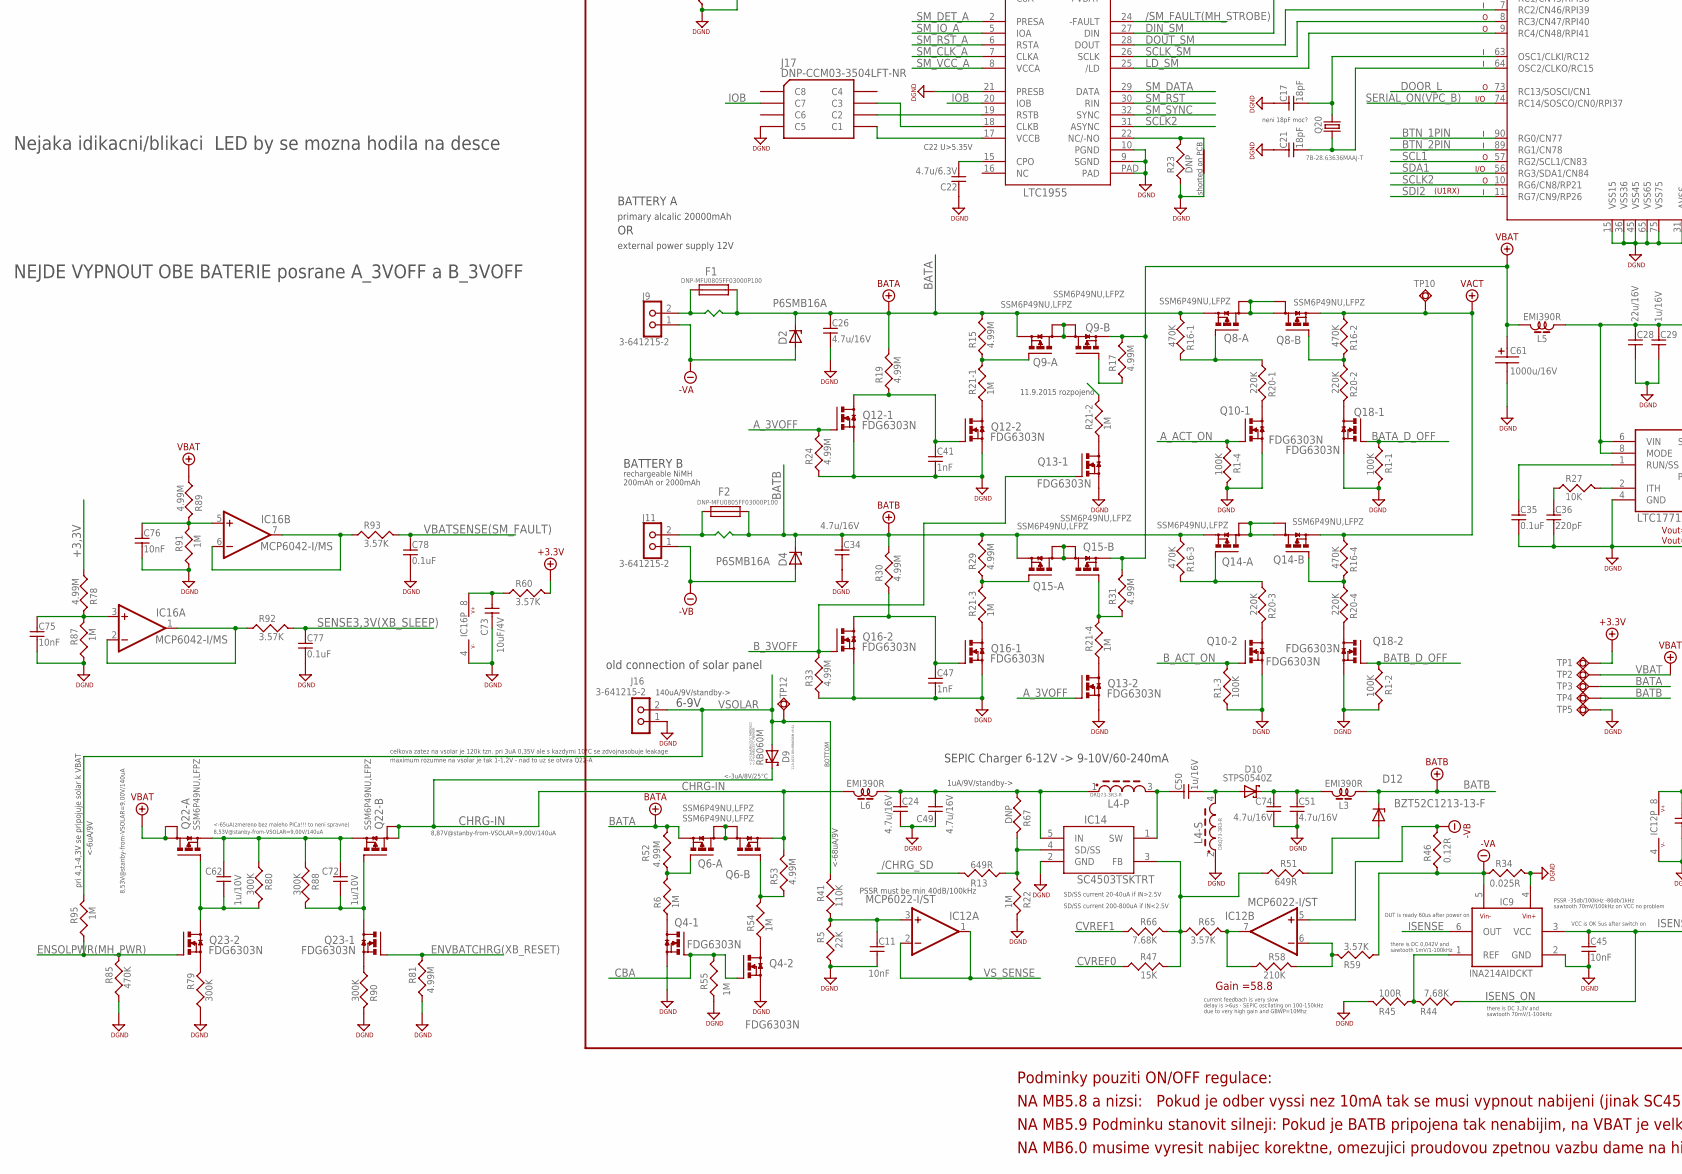
[picture p36: schematic PCB_eLock_G592_J1.sch, part in row 2, column 1]

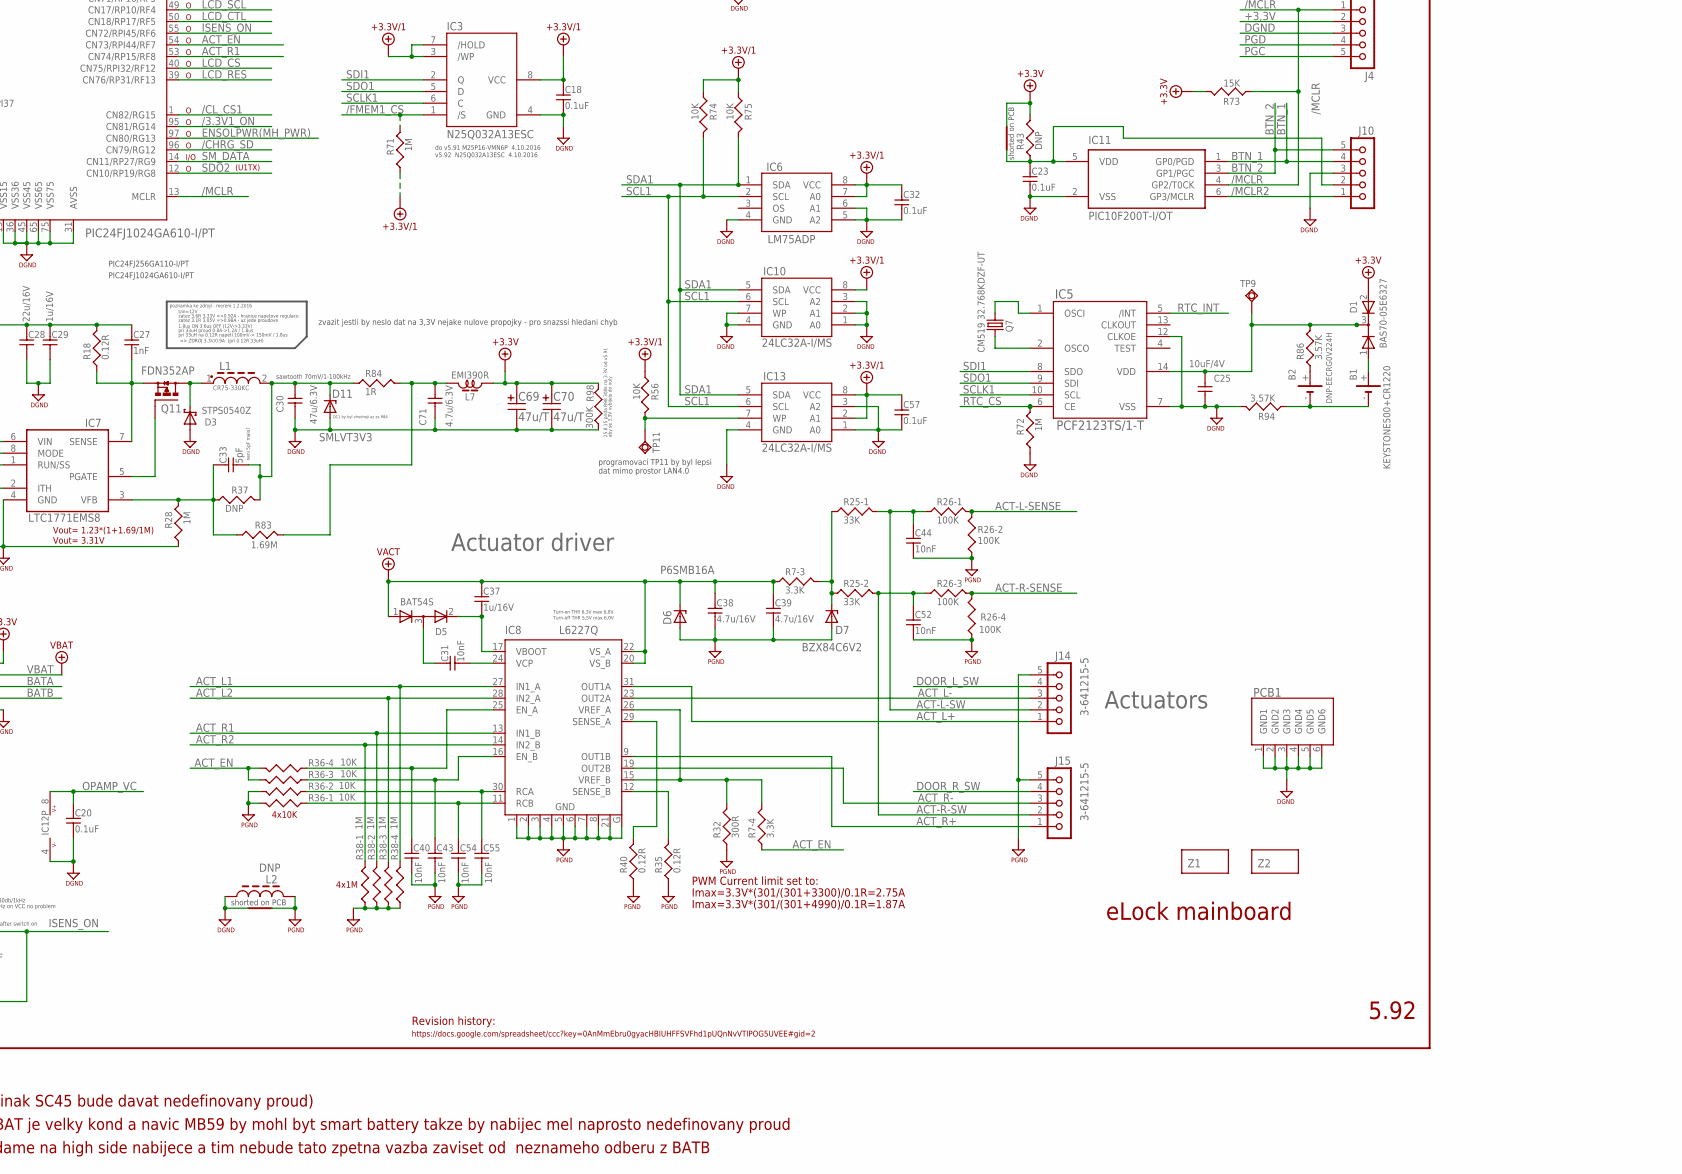
[picture p37: schematic PCB_eLock_G592_J1.sch, part in row 2, column 2]

Parts:
B1: KEYSTONE500+CR1220; KEYSTONE500
B2: DNP-EECRG0V224H; EECRG0V224H
C1, C6, C8, C14, C62, C72: 1u/10V; 0603
C2, C3, C5, C16, C18, C19, C20, C23, C32, C35, C57, C67, C77, C78: 0.1uF; 0603
C4, C7, C9, C10, C25, C58, C59, C60, C68, C73: 10uF/4V; 0603
C11, C12, C13, C31, C40, C42, C43, C44, C45, C46, C52, C53, C54, C55, C56, C63, C66, C75, C76: 10nF; 0603
C15, C22, C48, C71: 4.7u/6.3V; 0603
C17, C21: 18pF; 0603
C24, C26, C34, C38, C39, C49, C51, C74: 4.7u/16V; 0805
C27, C41, C47, C64, C65: 1nF; 0603
C28: 22u/16V; 1210
C29, C37, C50: 1u/16V; 0603
C30: 47u/6.3V; 1210
C33: 5pF; 0603
C36: 220pF; 0603
C61: 1000u/16V; CE5/13
C69, C70: 47u/T; CT-C
D1: BAS70-05E6327; SOT-23
D2, D4, D6: P6SMB16A; SMB
D3, D10: STPS0540Z; SOD-123
D5: BAT54S; SOT-23
D7: BZX84C6V2; SOT-23
D8: BAT54BRW-7F; SOT-363
D9: RB060M; SOD-123
D11: SMLVT3V3; SMA
D12: BZT52C1213-13-F; SOD-123
F1, F2: DNP-MFU0805FF03000P100; 0805
IC1: ISL60002DIH325Z-TK; SOT-23
IC2: PIC24FJ1024GA610-I/PT; SQFP-S-12X12-100
IC3: N25Q032A13ESC; SO-08
IC4: MCP602-I/ST; TSSOP8
IC5: PCF2123TS/1-T; TSSOP014
IC6: LM75ADP; TSSOP08-3
IC7: LTC1771EMS8; MSOP-08
IC8: L6227Q; SQFP-S-5X5-32
IC9: INA214AIDCKT; SC70-6
IC10, IC13: 24LC32A-I/MS; MSOP-08
IC11: PIC10F200T-I/OT; SOT23-6
IC12: MCP6022-I/ST; TSSOP8
IC14: SC4503TSKTRT; SOT23-5
IC15: MCP6542-I/MS; MSOP-08
IC16: MCP6042-I/MS; MSOP-08
IC17: LTC1955; LFCSP_5X5_032
J1: 3-641215-4
J2: PBC13DABN-2x13pinAu-5.8/2.5/5.8; MA13-2
J4, J10: DNP; MA05-1
J5, J6, J9, J11, J16: 3-641215-2
J7: 8x2pin-Au-6/2,5/3; MA08-2
J8: DF11-10DP-2DSA(01); DF11-10DP-2DSA
J14, J15: 3-641215-5
J17: DNP-CCM03-3504LFT-NR; CCM03-3504LFT-NR
L1: CR75-330KC; CR75
L2: DNP; 0805-0RTOP
L3, L5, L6, L7: EMI390R; 1206
L4: DRQ73-3R3-R; DRQ73
PCB1: PCB-MB59
Q1, Q4, Q10, Q12, Q13, Q16, Q18, Q23: FDG6303N; SC70-6
Q3, Q5: FDC6330L; SSOT-6
Q6, Q8, Q9, Q14, Q15, Q17, Q22: SSM6P49NU,LFPZ; MICRO_FET
Q7: CM519 32.768KDZF-UT; CM519
Q11: FDN352AP; SOT-23
Q20: 7B-28.63636MAAJ-T; 7B
R1, R9, R26, R42, R50: 100K; 0603-ARRAY
R2: 470R; 0603-ARRAY
R3, R32, R39, R57: 300R; 0603
R4, R10, R15, R17, R19, R24, R29, R30, R31, R33, R52, R53, R63, R78, R81, R82, R89: 4.99M; 0603
R5: 22K; 0603
R6, R8, R12, R22, R28, R54, R55, R62, R64, R68, R69, R71, R72, R87, R91, R95: 1M; 0603
R7: 3.3K; 0603-ARRAY
R11, R59, R60, R65, R70, R86, R92, R93, R94: 3.57K; 0603
R13, R48, R49, R51: 649R; 0603
R14, R20: 220K; 0603-ARRAY
R16: 470K; 0603-ARRAY
R18, R35, R40, R46: 0.12R; 0805
R21, R38: 1M; 0603-ARRAY
R23, R43: DNP; 0603-0RTOP
R25: 33K; 0603-ARRAY
R27, R56, R74, R75: 10K; 0603
R34: 0.025R; 0805
R36: 10K; 0603-ARRAY
R37, R67: DNP; 0603
R41: 110K; 0603
R44, R66: 7.68K; 0603
R45: 100R; 0603
R47, R73: 15K; 0603
R58: 210K; 0603
R61, R79, R80, R88, R90, R98: 300K; 0603
R76: 240K; 0603
R77: 510K; 0603
R83: 1.69M; 0603
R84: 1R; 0805
R85: 470K; 0603
TP1, TP2, TP3, TP4, TP5, TP6, TP7, TP8, TP9, TP10, TP11, TP12: DNP-TestPoint; SMD_ROUND_1MM
Z1, Z2: DNP-FiducialMark; REF

Connections:
3.3V-CMP-FILTERED: C68.1, IC15.8 (V+), R70.1
+3,3V: C1.1, C2.1, C5.1, C6.1, C8.1, C9.1, C15.2, C16.1, C48.2, C63.1, C69.+, C70.+, D1.2 (A2), D8.4 (K), D8.5 (K), IC2.2 (VDD2), IC2.16 (VDD16), IC2.37 (VDD37), IC2.46 (VDD46), IC2.62 (VDD62), IC2.86 (VDD86), IC17.1 (DVCC), IC17.12 (SVBAT), IC17.13 (PVBAT), J2.25, J4.2, J7.10, J8.9, L7.2, Q5.4 (Q2S), Q17.1 (S), Q17.4 (S), R3.2, R14.3 (1), R42.7 (2), R42.8 (2), R43.2, R57.1, R60.2, R62.1, R70.2, R73.2, R78.2, R98.1, TP1.P$1
+3.3V/1: C18.1, C32.1, C57.1, IC3.3 (/WP), IC3.7 (/HOLD), IC3.8 (VCC), IC6.7 (A0), IC6.8 (VCC), IC10.8 (VCC), IC13.2 (A1), IC13.8 (VCC), Q17.6 (D), Q17.P1 (D1), R56.1, R71.2, R74.1, R75.1, TP8.P$1
+3.3V/2: J7.1, Q17.3 (D), Q17.P2 (D1)
-VA: D2.A, IC9.5 (VIN-), J9.1, R34.1, R46.1, R59.2
-VB: D4.A, IC12.5 (+IN), J11.1, R46.2
/3.3V1_ON: IC2.95 (CN81/RG14), Q17.2 (G)
/CELL_3VON: IC2.94 (CN59/RE1), Q17.5 (G)
/CHRG_SD: IC2.96 (CN79/RG12), R13.1
/CL_CS1: IC2.1 (CN82/RG15), J2.19
/CL_CS2: IC2.17 (RA0/TMS), J8.7
/FMEM1_CS: IC2.93 (CN58/RE0), IC3.1 (/S), R71.1
/MCLR: IC2.13 (MCLR), IC11.4 (GP2/T0CK), J4.1, R73.1
/MCLR2: IC11.6 (GP3/MCLR), J10.1
/SM_FAULT(MH_STROBE): IC2.58 (RA2/SCL2), IC17.24 (-FAULT)
ACT-L-SENSE: IC2.71 (CN56/RP12/RD11), R26.7 (2), R26.8 (2)
ACT-L-SW: C44.1, J14.2, R25.8 (2), R26.1
ACT-R-SENSE: IC2.70 (CN55/RP3/RD10), R26.5 (2), R26.6 (2)
ACT-R-SW: C52.1, J15.2, R25.7 (2), R26.3 (1)
ACT_EN: IC2.54 (CN73/RPI44/RF7), R7.4 (1), R36.5 (2), R36.6 (2)
ACT_L1: IC2.52 (CN70/RP30/RF2), IC8.27 (IN1_A), R38.5 (2)
ACT_L2: IC2.68 (CN53/RP2/RD8), IC8.28 (IN2_A), R38.6 (2)
ACT_L+: IC8.31 (OUT1A), J14.1
ACT_L-: IC8.23 (OUT2A), J14.3
ACT_R1: IC2.53 (CN74/RP15/RF8), IC8.13 (IN1_B), R38.7 (2)
ACT_R2: IC2.78 (CN52/RP22/RD3), IC8.14 (IN2_B), R38.8 (2)
ACT_R+: IC8.9 (OUT1B), J15.1
ACT_R-: IC8.19 (OUT2B), J15.3
AVDD: C7.1, C58.1, IC2.30 (AVDD), R3.1
A_3VOFF: IC2.84 (CN16/RD7), Q12.2 (G), Q13.5 (G), R24.2
A_ACT_ON: IC2.61 (RA5/TDO/CN38), Q10.2 (G), R1.4 (1)
BATA: C26.1, D2.C, F1.1, F1.2, J9.2, Q6.1 (S), Q8.1 (S), Q9.1 (S), R4.1, R15.2, R16.1, R19.2, R52.2, TP3.P$1
BATA_D_OFF: IC2.92 (RA7/CN40), Q18.2 (G), R1.1
BATB: C34.1, D4.C, D12.1+ (C), F2.1, F2.2, J11.2, L3.2, Q14.1 (S), Q15.1 (S), R10.1, R16.3 (1), R29.2, R30.2, TP4.P$1
BATB_D_OFF: IC2.67 (RA15/RPI35/CN44), Q18.5 (G), R1.2 (1)
BTN_1: IC11.1 (GP0/PGD), J5.2, J10.4, R42.2 (1), R42.3 (1)
BTN_1PIN: C42.1, IC2.90 (RG0/CN77), R42.6 (2)
BTN_2: IC11.3 (GP1/PGC), J6.2, J10.5, R42.1, R42.4 (1)
BTN_2PIN: C56.1, IC2.89 (RG1/CN78), R42.5 (2)
B_3VOFF: IC2.66 (RA14/RPI36/CN43), Q13.2 (G), Q16.5 (G), R33.2
B_ACT_ON: IC2.60 (RA4/TDI/CN37), Q10.5 (G), R1.6 (2)
CBA: IC2.51 (CN71/RP16/RF3), Q4.2 (G), Q4.5 (G), R55.2
CHRG-IN: D9.K, L6.1, Q6.4 (S), Q22.3 (D), Q22.P2 (D1), R53.2
CL_IRQ: IC2.20 (RB5/AN5/CN7/RP18), J2.9, J8.4
CMP-HI-LEVEL: IC15.5 (+IN), R76.2, R77.1
CMP-LO-LEVEL: C66.1, IC15.3 (+IN), R63.2, R77.2
CVREF0: IC2.88 (CN69/RF1), R47.2, TP6.P$1
CVREF1: IC2.34 (RB10/AN10/CN28/CVREF), R66.2
DGND: C1.2, C2.2, C3.2, C4.2, C5.2, C6.2, C7.2, C8.2, C9.2, C10.1, C11.2, C13.2, C15.1, C16.2, C17.1, C18.2, C19.2, C20.2, C21.1, C22.1, C23.2, C24.2, C25.2, C26.2, C28.2, C29.2, C30.2, C32.2, C34.2, C35.2, C36.2, C41.2, C42.2, C45.2, C46.2, C47.2, C48.1, C49.2, C51.2, C56.2, C57.2, C58.2, C59.2, C60.1, C61.-, C64.2, C65.2, C66.2, C67.2, C68.2, C69.-, C70.-, C71.2, C73.2, C74.2, C75.2, C76.2, C77.2, C78.2, D3.A, D8.1 (A), D8.2 (A), D11.- (A), IC1.3 (GND), IC2.15 (VSS15), IC2.31 (AVSS), IC2.36 (VSS36), IC2.45 (VSS45), IC2.65 (VSS65), IC2.75 (VSS75), IC3.4 (GND), IC4.4 (V-), IC5.7 (VSS), IC5.12 (CLKOE), IC6.4 (GND), IC6.5 (A2), IC6.6 (A1), IC7.4 (GND), IC9.2 (GND), IC9.4 (VIN+), IC10.1 (A0), IC10.2 (A1), IC10.3 (A2), IC10.4 (GND), IC10.7 (WP), IC11.2 (VSS), IC12.4 (V-), IC13.1 (A0), IC13.3 (A2), IC13.4 (GND), IC14.2 (GND), IC15.4 (V-), IC16.4 (V-), IC17.9 (SGND), IC17.10 (PGND), IC17.21 (PRESB), IC17.PAD, J1.1, J2.23, J4.3, J5.1, J6.1, J7.9, J8.1, J10.3, J16.1, J17.C5, L2.2, L4.2 (1), PCB1.1 (GND1), PCB1.2 (GND2), PCB1.3 (GND3), PCB1.4 (GND4), PCB1.5 (GND5), PCB1.6 (GND6), Q1.1 (S), Q4.1 (S), Q4.4 (S), Q10.1 (S), Q10.4 (S), Q12.1 (S), Q12.4 (S), Q13.1 (S), Q13.4 (S), Q16.1 (S), Q16.4 (S), Q18.1 (S), Q18.4 (S), R1.3 (1), R1.5 (2), R1.7 (2), R1.8 (2), R5.2, R8.2, R12.2, R22.1, R23.1, R24.1, R25.4 (1), R28.2, R33.1, R34.2, R45.1, R55.1, R61.2, R64.2, R69.2, R72.2, R79.1, R81.2, R82.2, R85.2, R87.2, R90.1, R91.2, R94.2, R98.2, TP5.P$1
DIN_SM: IC2.6 (RC1/CN45/RPI38), IC17.27 (DIN)
DOOR_L: IC2.73 (RC13/SOSCI/CN1), R50.2 (1), R50.3 (1)
DOOR_L_SW: C12.1, J14.4, R48.2, R50.7 (2)
DOOR_ON: IC2.87 (CN68/RF0), Q3.5 (Q1G), R9.7 (2)
DOOR_R: IC2.83 (CN15/RD6), R50.1, R50.4 (1)
DOOR_R_SW: C53.1, J15.4, R49.2, R50.8 (2)
DOUT_SM: IC2.7 (RC2/CN46/RPI39), IC17.28 (DOUT)
ENSOLPWR(MH_PWR): IC2.97 (CN80/RG13), Q23.5 (G), R85.1, R95.2
ENVBATCHRG(XB_RESET): IC2.18 (RPI33/CN66/RE8), Q23.2 (G), R81.1
IOB: IC17.20 (IOB), J17.C7
IREF: IC9.1 (REF), R44.1, R45.2
ISENSE: IC2.44 (RB15/AN15/CN12/RP29), IC9.6 (OUT)
ISENS_ON: C45.1, IC2.55 (CN72/RPI45/RF6), IC9.3 (VCC), R44.2
LCD_BL: IC2.28 (RA9/VR-/CN41), J2.3
LCD_CS: IC2.40 (CN75/RPI32/RF12), J2.10
LCD_CTL: IC2.50 (CN18/RP17/RF5), J2.6
LCD_RES: IC2.39 (CN76/RP31/RF13), J2.8
LCD_SCL: IC2.49 (CN17/RP10/RF4), J2.4
LCD_SI: IC2.32 (RB8/AN8/CN26/RP8), J2.2
LD_SM: IC2.9 (RC4/CN48/RPI41), IC17.25 (/LD)
LOAD_ON: IC2.91 (RA6/CN39), Q1.2 (G), R25.6 (2)
unnamed: B1.-, B2.-, R94.1
unnamed: C22.2, IC17.15 (CPO)
unnamed: B1.+, D1.1 (A1)
unnamed: Q18.6 (D), R20.7 (2)
unnamed: C4.1, C59.1, IC1.1 (VIN), R57.2
unnamed: C31.2, IC8.24 (VCP)
unnamed: IC17.19 (RSTB), J17.C2
unnamed: C21.2, IC2.64 (OSC2/CLKO/RC15), Q20.1
unnamed: Q8.3 (D), Q8.6 (D), Q8.P1 (D1), Q8.P2 (D1)
unnamed: Q14.3 (D), Q14.6 (D), Q14.P1 (D1), Q14.P2 (D1)
unnamed: R25.3 (1), R25.5 (2)
unnamed: C13.1, IC4.3 (+IN), R4.2, R8.1
unnamed: C14.1, IC17.11 (C-)
unnamed: C14.2, IC17.14 (C+)
unnamed: C46.1, IC4.5 (+IN), R10.2, R12.1
unnamed: C25.1, D1.3 (K), IC5.14 (VDD), R86.2, TP9.P$1
unnamed: Q10.6 (D), R20.8 (2)
unnamed: IC17.23 (-UNDERV), R14.4 (1)
unnamed: C31.1, D5.3 (KA)
unnamed: Q10.3 (D), R20.6 (2)
unnamed: C33.1, IC7.3 (VFB), R28.1, R37.2, R83.2
unnamed: IC5.1 (OSCI), Q7.2
unnamed: IC5.2 (OSCO), Q7.1
unnamed: Q14.5 (G), R16.5 (2), R20.4 (1)
unnamed: IC17.22 (NC/-NO), R23.2
unnamed: Q18.3 (D), R20.5 (2)
unnamed: Q8.5 (G), R16.7 (2), R20.2 (1)
unnamed: IC17.18 (CLKB), J17.C3
unnamed: D7.3 (C), R7.6 (2), R25.1, R25.2 (1)
unnamed: D12.2 (A), R51.1
unnamed: IC8.12 (SENSE_B), R35.2
unnamed: Q1.6 (D), R39.1
unnamed: IC14.4 (SD/SS), R13.2, R22.2, R67.1
unnamed: IC17.17 (VCCB), J17.C1
unnamed: Q3.6 (Q2G), R9.3 (1)
unnamed: C17.2, IC2.63 (OSC1/CLKI/RC12), Q20.3 (2)
unnamed: C30.1, C33.2, D11.+ (C), L1.2, R37.1, R84.1
unnamed: Q8.2 (G), R16.8 (2), R20.1
unnamed: Q6.2 (G), R6.2, R52.1
unnamed: Q3.2 (Q2D1), Q3.3 (Q2D2), R48.1, R49.1
unnamed: IC8.29 (SENSE_A), R40.2
unnamed: Q14.2 (G), R16.6 (2), R20.3 (1)
unnamed: C23.1, IC11.5 (VDD), J10.2, R43.1
unnamed: R14.5 (2), R14.6 (2)
unnamed: Q6.3 (D), Q6.6 (D), Q6.P1 (D1), Q6.P2 (D1)
unnamed: Q6.5 (G), R53.1, R54.2
unnamed: C37.2, D5.2 (K), IC8.17 (VBOOT)
unnamed: Q4.6 (D), R6.1
unnamed: Q9.2 (G), R15.1, R21.8 (2)
unnamed: C54.1, IC8.11 (RCB), R36.1
unnamed: Q15.2 (G), R21.6 (2), R29.1
unnamed: Q4.3 (D), R54.1
unnamed: Q12.3 (D), R21.1
unnamed: C41.1, Q12.5 (G), Q12.6 (D), R19.1
unnamed: IC13.7 (WP), R56.2, TP11.P$1
unnamed: IC12.6 (-IN), R58.1, R59.1
unnamed: Q13.6 (D), R21.2 (1)
unnamed: C47.1, Q16.2 (G), Q16.3 (D), R30.1
unnamed: C40.1, IC8.25 (EN_A), R36.4 (1)
unnamed: Q9.3 (D), Q9.6 (D), Q9.P1 (D1), Q9.P2 (D1)
unnamed: R64.1, R76.1
unnamed: Q15.3 (D), Q15.6 (D), Q15.P1 (D1), Q15.P2 (D1)
unnamed: Q23.4 (S), R79.2
unnamed: C71.1, L7.1, R83.1, R84.2
unnamed: J1.4, Q5.2 (Q2D1), Q5.3 (Q2D2)
unnamed: C63.2, Q5.6 (Q2G), R62.2
unnamed: J1.2, R2.6 (2)
unnamed: Q5.1 (Q1S), R61.1
unnamed: C43.1, IC8.16 (EN_B), R36.3 (1)
unnamed: C55.1, IC8.30 (RCA), R36.2 (1)
unnamed: C62.2, Q22.2 (G), Q23.3 (D), R80.2
unnamed: C50.1, IC14.1 (SW), L4.3 (2)
unnamed: C64.1, D8.6 (AK), R2.3 (1), R2.4 (1)
unnamed: IC7.5 (PGATE), Q11.1 (G)
unnamed: C50.2, D10.A, L4.4 (2)
unnamed: IC7.2 (ITH), R27.2
unnamed: IC8.15 (VREF_B), IC8.26 (VREF_A), R7.5 (2), R32.2
unnamed: C36.1, R27.1
unnamed: C35.1, IC7.1 (RUN/SS)
unnamed: IC14.3 (FB), R47.1, R51.2, R65.2, R66.1
unnamed: C27.2, IC7.7 (SENSE), Q11.2 (S), R18.1
unnamed: D3.C (K), L1.1, Q11.3 (D)
unnamed: C62.1, C72.1, Q22.1 (S), Q22.4 (S), R80.1, R88.1
unnamed: J1.3, R2.8 (2)
unnamed: C65.1, D8.3 (AK), R2.1, R2.2 (1)
unnamed: B2.+, R86.1
unnamed: C75.1, IC16.3 (+IN), R78.1, R87.1
unnamed: C72.2, Q22.5 (G), Q23.6 (D), R88.2
unnamed: C51.1, C74.1, D10.C (K), L3.1
unnamed: Q23.1 (S), R90.2
unnamed: Q16.6 (D), R21.3 (1)
unnamed: Q13.3 (D), R21.4 (1)
unnamed: C27.1, C28.1, C29.1, IC7.6 (VIN), IC7.8 (MODE), L5.2, R18.2
unnamed: C11.1, IC12.3 (+IN), R5.1, R41.2
unnamed: C24.1, C49.1, IC14.5 (IN), L4.1, L6.2, R67.2
unnamed: IC16.1 (OUT), IC16.2 (-IN), R92.1
unnamed: Q9.5 (G), R17.1
unnamed: C73.1, IC16.8 (V+), R60.1
unnamed: C76.1, IC16.5 (+IN), R89.1, R91.1
unnamed: Q15.5 (G), R21.5 (2), R31.1
unnamed: IC16.6 (-IN), IC16.7 (OUT), R93.1
NC(MH_DATA): IC2.59 (RA3/SDA2)
OPAMP_VC: C19.1, C20.1, IC2.47 (CN20/RPI43/RD14), IC4.8 (V+), IC12.8 (V+)
PGC: IC2.26 (RB6/AN6/PGC2/RP6), J4.5
PGD: IC2.27 (RB7/AN7/PGD2/RP7), J4.4
PGND: C12.2, C38.2, C39.2, C40.2, C43.2, C44.2, C52.2, C53.2, C54.2, C55.2, D6.A, D7.1 (A), IC8.1 (GND1), IC8.2 (GND2), IC8.3 (GND3), IC8.4 (GND4), IC8.5 (GND5), IC8.6 (GND6), IC8.7 (GND7), IC8.8 (GND8), IC8.21 (GND21), IC8.G (GNEXP), J14.5, J15.5, L2.1, Q3.1 (Q1S), R9.2 (1), R26.2 (1), R26.4 (1), R32.1, R35.1, R36.7 (2), R36.8 (2), R38.1, R38.2 (1), R38.3 (1), R38.4 (1), R40.1, R50.5 (2), R50.6 (2)
PHOTOCELL: J2.5, R11.2, R14.1, R14.2 (1)
PHOTO_PIN: IC2.24 (RB1/AN1/CN3/PGC1/RP1), R11.1
PHOTO_PWR: IC2.25 (RB0/AN0/CN2/PGD1/RP0), R14.7 (2), R14.8 (2)
PIC_INT: IC2.38 (RA1/TCK), J2.7, J8.3
RTC_CS: IC2.79 (CN57/RPI42/RD12), IC5.6 (CE), R72.1
RTC_INT: IC2.80 (CN19/RD13), IC5.5 (/INT)
SCL1: IC2.57 (RG2/SCL1/CN83), IC6.2 (SCL), IC10.6 (SCL), IC13.6 (SCL), J7.16, R74.2
SCLK1: IC2.77 (CN51/RP23/RD2), IC3.6 (C), IC5.10 (SCL)
SCLK2: IC2.10 (RG6/CN8/RP21), IC17.31 (ASYNC), J2.15, J7.12, J8.5
SCLK_SM: IC2.8 (RC3/CN47/RPI40), IC17.26 (SCLK)
SDA1: IC2.56 (RG3/SDA1/CN84), IC6.1 (SDA), IC10.5 (SDA), IC13.5 (SDA), J7.15, R75.2
SDI1: IC2.72 (CN49/RP11/RD0), IC3.2 (Q), IC5.8 (SDO)
SDI2: IC2.11 (RG7/CN9/RP26), J2.21, J7.11, J8.8
SDO1: IC2.76 (CN50/RP24/RD1), IC3.5 (D), IC5.9 (SDI)
SDO2: IC2.12 (CN10/RP19/RG8), J2.17, J7.14, J8.6
SENSE3,3V(XB_SLEEP): C77.1, IC2.22 (RB3/AN3/CN5), R92.2
SERIAL_ON(VPC_B): IC2.74 (RC14/SOSCO/CN0/RPI37), Q5.5 (Q1G), R82.1
SM_C4A: IC17.4 (C4A), J2.18
SM_C8A: IC17.3 (C8A), J2.22
SM_CLK_A: IC17.7 (CLKA), J2.16
SM_DATA: IC2.14 (CN11/RP27/RG9), IC17.29 (DATA)
SM_DET_A: IC17.2 (PRESA), J2.24
SM_IO_A: IC17.5 (IOA), J2.20
SM_RST: IC2.5 (CN65/SDA3/RE7), IC17.30 (RIN)
SM_RST_A: IC17.6 (RSTA), J2.14
SM_SYNC: IC2.4 (CN64/SCL3/RE6), IC17.32 (SYNC)
SM_VCC_A: IC17.8 (VCCA), J2.12
SNDR: IC2.35 (RB11/AN11/CN29), J2.1
U2CTL(CM_RTS): IC2.19 (RPI34/CN67/RE9), J2.26, J7.6
U2RX: IC2.81 (CN13/RP25/RD4), J7.4
U2TX: IC2.82 (CN14/RP20/RD5), J7.2
V-ISEN: IC12.7 (OUT), R58.2, R65.1
VACT: C37.1, C38.1, C39.1, D5.1 (A), D6.C, IC8.20 (VS_B), IC8.22 (VS_A), J2.13, Q8.4 (S), Q14.4 (S), R7.3 (1), R16.2 (1), R16.4 (1), R39.2, TP10.P$1
VBAT: C61.+, J7.7, J8.10, L5.1, Q3.4 (Q2S), Q9.4 (S), Q15.4 (S), Q22.6 (D), Q22.P1 (D1), R9.6 (2), R17.2, R31.2, R63.1, R89.2, TP2.P$1
VBATLAN-TO-MB(/RAM_CS): IC2.3 (CN63/RE5), J7.13
VBATMB-TO-LAN(CM_RST): IC2.98 (CN60/RE2), J7.5
VBATSENSE(SM_FAULT): C78.1, IC2.21 (RB4/AN4/CN6/RP28), R93.2
VBAT_H(U3TX): IC2.33 (RB9/AN9/CN27/RP9), IC15.7 (OUT)
VBAT_L(U3RX): IC2.23 (RB2/AN2/CN4/RP13), IC15.1 (OUT)
VDDCOE: C10.2, C60.2, IC2.85 (VDDCORE)
VPC_A: IC2.69 (CN54/RP4/RD9), R2.7 (2)
VPC_B(XB_RTS): IC2.48 (CN21/RP5/RD15), R2.5 (2)
VPS-ON(CM_ON): IC2.100 (CN62/RE4), J7.8
VPS-SENSE(CM_RING): IC2.99 (CN61/RE3), J7.3
VREF1.25V: C67.1, IC15.2 (-IN), IC15.6 (-IN), R68.2, R69.1
VREF2.5: C3.1, IC1.2 (VOUT), IC2.29 (RA10/VR+/CN42), R68.1, TP7.P$1
VSENSEA: IC2.43 (RB14/AN14/CN32/RP14), IC4.1 (OUT), IC4.2 (-IN)
VSENSEB: IC2.42 (RB13/AN13/CN31), IC4.6 (-IN), IC4.7 (OUT)
VSOLAR: D9.A, J8.2, J16.2, R41.1, R95.1, TP12.P$1
VS_SENSE: IC2.41 (RB12/AN12/CN30), IC12.1 (OUT), IC12.2 (-IN)

Notes on the sheet:
Actuator driver
Actuators
Cell modem extension
4x10K
4x1M
Vout= 1.23*(1+1.69/1M)
Vout= 3.31V
I/O
5.92
eLock mainboard
PWM Current limit set to:
Imax=3.3V*(301/(301+3300)/0.1R=2.75A
Imax=3.3V*(301/(301+4990)/0.1R=1.87A
Gain =58.8
(U1RX)
(U1TX)
Revision history:
https://docs.google.com/spreadsheet/ccc?key=0AnMmEbru0gyacHBIUHFFSVFhd1pUQnNvVTlPOG5UVEE#gid=2
PSSR -35db/100kHz -80db/1kHz
sawtooth 70mV/100kHz on VCC no problem
OUT is ready 60us after power on
VCC is OK 5us after switch on
sawtooth 70mV/1-100kHz
there is DC 3,3V and
there is DC 0,042V and
sawtooth 1mV/1-100kHz
Wait 2ms after AD ON
due to transient on IC1 REF2,5V
Wait 100ms after AD OFF
before next AD ON
<- 0,37mA if REF is AN10
0.35mA ->
<- 0.35mA if REF ADC
0.35mA(1uA) ->
PSSR must be min 40dB/100kHz
current feedbach is very slow
due to very high gain and GBWP=10Mhz
delay is >6us - SEPIC oscilating on 100-150kHz
BATTERY A
primary alcalic 20000mAh
BATTERY B
rechargeable NiMH
200mAh or 2000mAh
old connection of solar panel
external power supply 12V
6-9V
SEPIC Charger 6-12V -> 9-10V/60-240mA
LAN ADAPTER
VPC_B remaped from RC14 to RD15/CN21/RP5/+5Vtolerant
VPC_A stay on RD9/CN54/RP4/+5Vtolerant
originally VPC_B was
RD15 was originaly XB_RTS
on this port RC14
VBAT>4,82V+/-0,03V
VBAT>6,80V+/-0,05V
1,25V
RFTop-BOARD
UI-BOARD
Turn-on THR 6,3V max 6,8V
Turn-off THR 5,5V max 6,0V
<- 0,25uA
1,4uA/9V ->
<- 2x 0,6uA/3,3V
<-0,84mA if AVDD is REF
NA MB5.8 a nizsi: Pokud je odber vyssi nez 10mA tak se musi vypnout nabijeni (jinak SC45 bude davat nedefinovany proud)
NA MB5.9 Podminku stanovit silneji: Pokud je BATB pripojena tak nenabijim, na VBAT je velky kond a navic MB59 by mohl byt smart battery takze by nabijec mel naprosto nedefinovany proud
NA MB6.0 musime vyresit nabijec korektne, omezujici proudovou zpetnou vazbu dame na high side nabijece a tim nebude tato zpetna vazba zaviset od neznameho odberu z BATB
Podminky pouziti ON/OFF regulace:
pri 4,1-4,3V se pripojuje solar k VBAT
1.6.2015 SCH&BRD consistent, ERC: errors(0), warnings(1) - only one pin on net NC(MH_DATA) DRC: errors(7) 3x overlap via on IC8 4x overlap via on IC17
C22 U>5.35V
CHYBY a ZMENY na MB5.9 zjistene po zadani do vyroby
1) UDELANO -> pripojen zpět vodic +3,3V na J7/10 kde puvodne byl na v5.9 se tam uvazovalo signal VBAT-LAN z LAN adapteru ale nikdy to tak nebylo
2) UDELANO -> Dioda D9 je slaba sotva 0,5A spise signalova a mela by se tam dat SS14 nebo RB060M - budeme se znazit osadit SS14 na V5.9 se tam nacpala SS14 od v5.91 RB060M
zapsano 4.6.2015 a 7.6.2015
3) UDELANO -> potisk Locker Mainboard Rev 5.9 je po instalaci LAN adapteru zakryt - pro priste najit lepsi misto pro takto dulezity udaj
pres IC16A je mozne AD prevodnikem mezir napeti 3.3V - coz je zbytecne, nepouzivane
je pak otazka jestli nezmenit IC16 na jednokanalovy
mozna by take slo uplne prestat pouzivat AD prevodnik PICA a pouzivat extreni prevodnik na I2C - obdobne jako na LAN
NAVRHY zmen pro MB60
diskutovano 3.6.2015 se Stevenem
1) Charger vylepsit vymenit svaba a odladit jineho svaba s highside merenim proudu
2) Zrusit to pekelne prepojovani BATB BATA na VBAT a VACT
3) Driver L6227 pro Actuator je zbytecny - Steven rikal (nutno jeste jednou overit) ze motorkem se toci vzdy a opouze na jednu stranu takze by to slo nahradit dvema tranzistorama
4) Uvazit jak merit BATA, BATB, VBAT, VBAT-LAN - jestli je potreba OAMPy jestli by nestačilo delic 1M na 100k nebo 600k na 100k nebo neco takoveho nebo prejit na extreni prvodnik, nepouzivat AD PICA a vyhodit tu hroznou referenci
5) Steven by rad na desce extra konektor pro extreni napajen z adapteru, stacilo by mu to pridat k BATA ale v takovem pripade ochranit tak aby se nic nestalo pokud by se priúpojila BATA a extreni zdroj zaroven
6) Steven by rad zaintegroval LANAdaper do MB, nicmen je t trochu kontraverzni (a prubehu diskuze se zda ze to tak taky zacal chapat) protoze tim prijdeme o perfektni rozhrani pro dalsi upgrady
Zauvazovat na siti propojenou CANem - asi by pak nebyl potreba VPS-PWR a byly by dva draty pro tazeni napajeni
Uvazit jetli neudelat solarni nabijec autonomni aby se o to nemusel clovek starat v SW
Probrat Current sensing a mereni naboje
Steven ma dat vedet jestli chcee litiovku nebo supercapacitor na vyrobni serii 300ks MB5.9
Uspesne jsem dnes otestovali extreni I2C AD prevodnik MCP3425 standabu spotreba 0.6uA pri 12bitovem prevod a gain1 a jednom prevodu za sekundu spotraba 1uA
Pokud se meri stale tak zere 130uA (zrejme 260prevodu za sekundu) prevod asi trva 3,5-4ms - podle doby jak dlouho klesa napajeci napeti a napeti na vstupu ktery ma velkou impedanci
Impedance zdroje signalu by mela byt hodne nizka radove 2k, pokud je radove vyssi je potreba poradny kond a merit malo casto, pro presne mereni (bez poklesu zmeren hodnoty) je potreba 1uF prijatelna chyba je se 100n (radove 6 dilku 6mV) s 10nF konedm je cbyba uz velmi velka radove 70mV pri napeti 5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
Pokud se da 1u tak je potraba dat trochu tvrdsi delic optimalne s dolnim odporem tak 100k aby casova konstatnat byla 100ms a pro ustaleni je pak potreba cca 7-8 casovych konstatnt tzn. cca 0,8s tzn. pri 1u a 100k je mozne pouze jedno mereni za sekundu
Pri 100k odporu a trvalem mereni (260x za sekundu) se zda jakoby mel prevodnik vnitrni odpor radove 2-3M a spolecne se 100k odporem to pak ukazuje cca 95% (napeti na vstupu s 100k se snizi o cca 5%) a je realne toto kompenzovat
<-3-4uA/8V/25°C RB060M
<-3uA/8V/25°C
celkova zatez na vsolar je 120k tzn. pri 3uA 0,35V ale s kazdymi 10°C se zdvojnasobuje leakage
maximum rozumne na vsolar je tak 1-1,2V - nad to uz se otvira Q22-A
SD/SS current 20-40uA if IN>2.5V
SD/SS current 200-800uA if IN<2.5V
Tady ma byt PullUp tak 1M
140uA/9V/standby->
<-68uA/9V
1uA/9V/standby->
<-6uA/9V
<-12-18uA/8V/25°C MBR0502
BOTTOM
8,87V@stanby-from-VSOLAR=9,00V/140uA
8,53V@stanby-from-VSOLAR=9,00V/140uA
<-65uA(zmereno bez maleho PICa!!! to neni spravne)
D11 by byl vhodneji az za R84
NEJDE VYPNOUT OBE BATERIE posrane A_3VOFF a B_3VOFF
Nejaka idikacni/blikaci LED by se mozna hodila na desce
Mozna by take slo uplne prestat pouzivat AD prevodnik PICA a pouzivat extreni vycekanalovy prevodnik na I2C (na LAD adapter je jednokanal) a existuje 4 kanalovy pka by se mohla dat do riti tak hrozna reference a taky by klesla spotreba a slo by merit kdykoliv bez nutnosti zapinat zravy AD modul nic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
11.9.2015 SCH&BRD consistent, ERC: errors(0), warnings(2) - only one pin on net NC(MH_DATA) and N$47 DRC: errors(7) 3x overlap via on IC8 4x overlap via on IC17
Uin=12V
zatez 3,6R 3,33V =>0.92A - hranice napetove regulace
zatez 3,1R 3,05V =>0.98A - uz jede proudove
1.8us ON 3.6us OFF (12V->3.33V)
pri 33uH proud 0.8A->1.2A / 1.8us
pri 33uH na 0.12R napeti 100mV-> 150mV / 1.8us
=> ZDROJ 3.3V/0.9A (pri 0.12R 33uH)
poznamka ke zdroji - mereni 1.2.2016
od v5.92 4.10.2016 3.3V
do v5.91 tu bylo VBAT
25.8.15 prida R98 300k na 3.3V od v5.91
aby se 3.3V vybijelo do nuly
11.9.2015 D9=RB0606M v5.91
11.9.2015 rozpojeno
Do gate by mel byt tak 1M
aby pri P.On byl zavreny
spina moc rychle, proud. pulz
programovaci TP11 by byl lepsi
dat mimo prostor LAN4.0
zvazit jestli by neslo dat na 3,3V nejake nulove propojky - pro snazssi hledani chyb
do v5.91 M25P16-VMN6P 4.10.2016
v5.92 N25Q032A13ESC 4.10.2016
PIC24FJ256GA110-I/PT
PIC24FJ1024GA610-I/PT
neni 5pF malo?
neni 18pF moc?
shorted on PCB

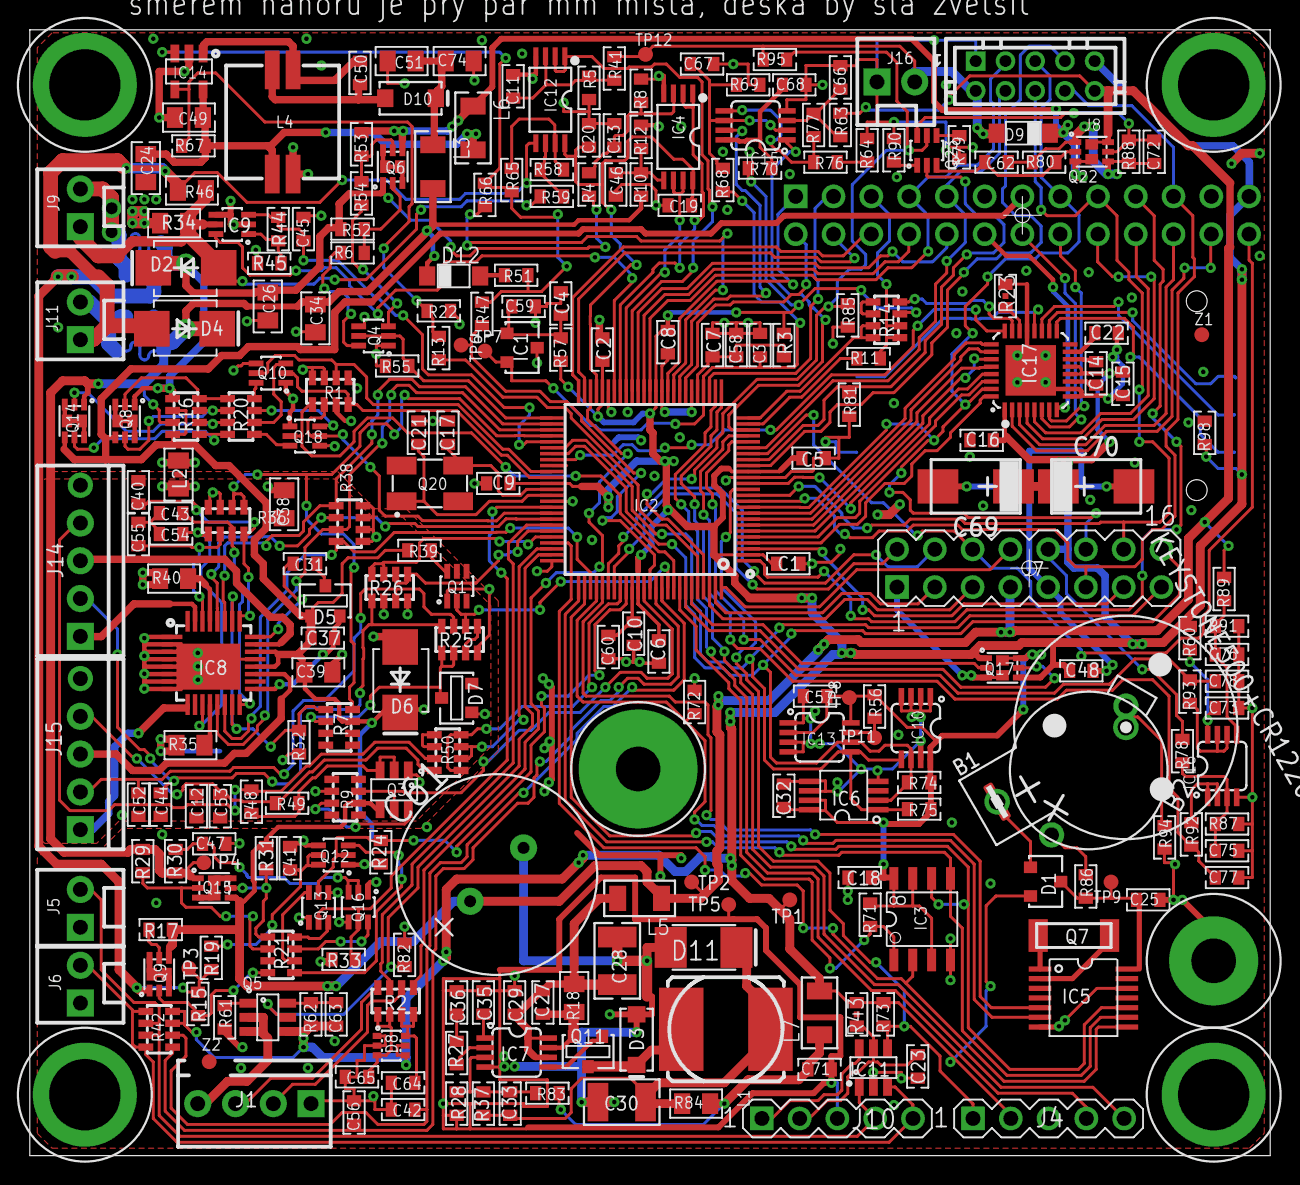
[picture p38: board PCB_eLock_G592_J1.brd from above]

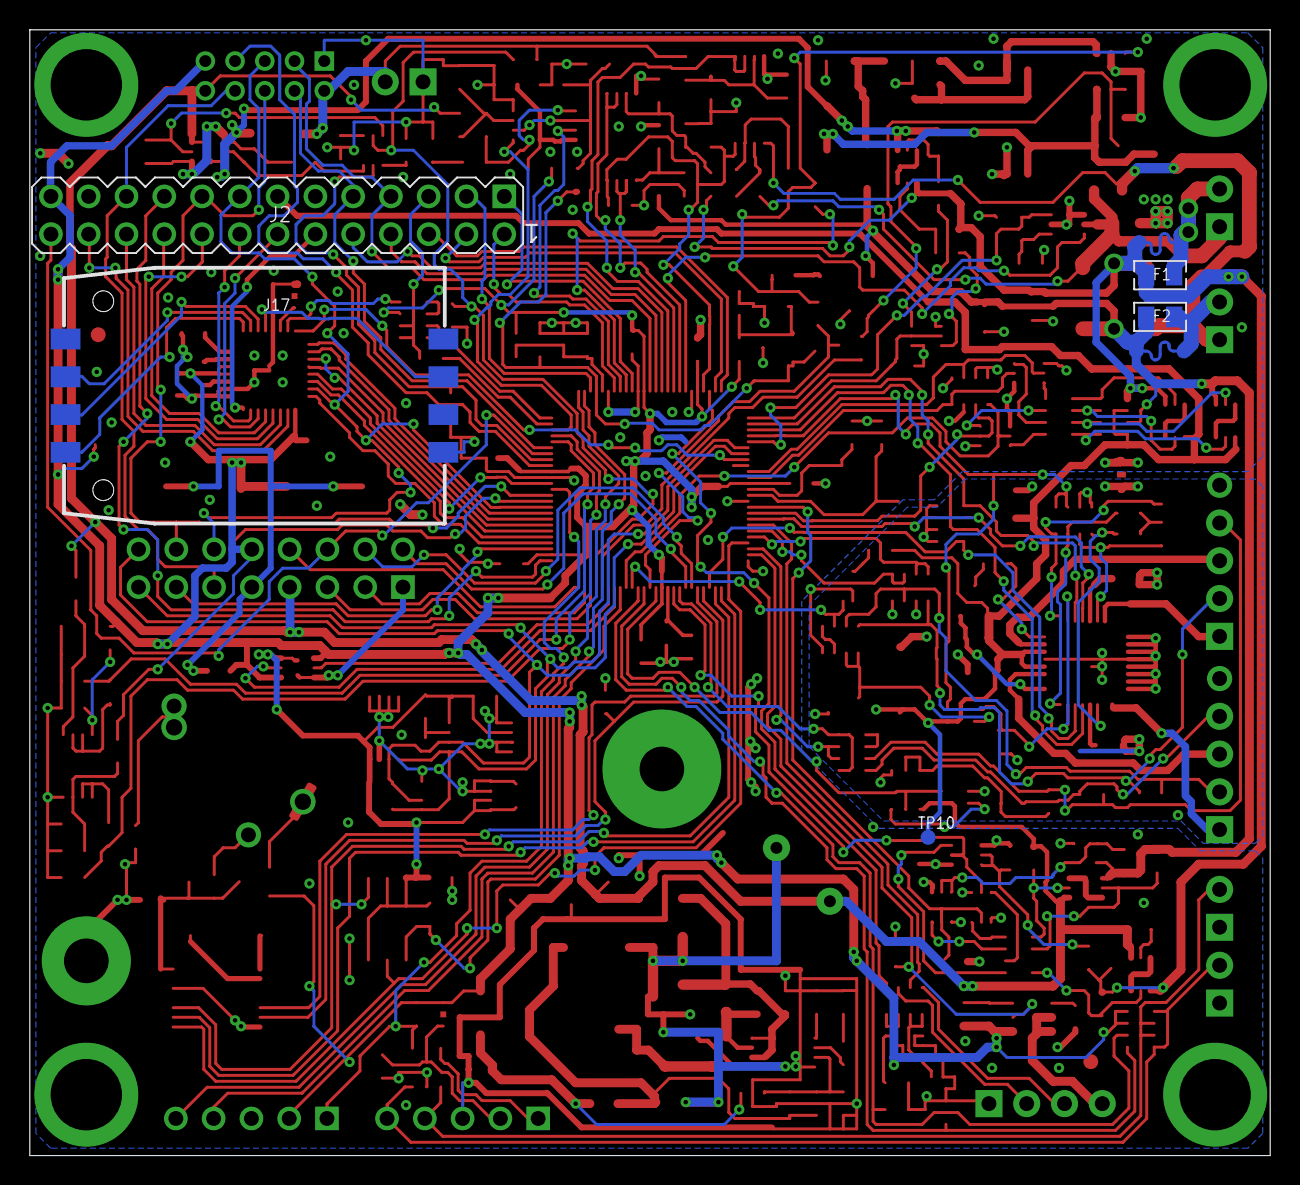
[picture p39: board PCB_eLock_G592_J1.brd from below]

Board: 2 copper layers, 83.4 x 75.7 mm, 263 parts (5 on the bottom side), 225 nets.
