alleybeachelectric/Gen6/BT BOARD/BT boards 1.0.brd

## EAGLE design BT BOARD/BT boards 1.0.brd (2018-02-28)

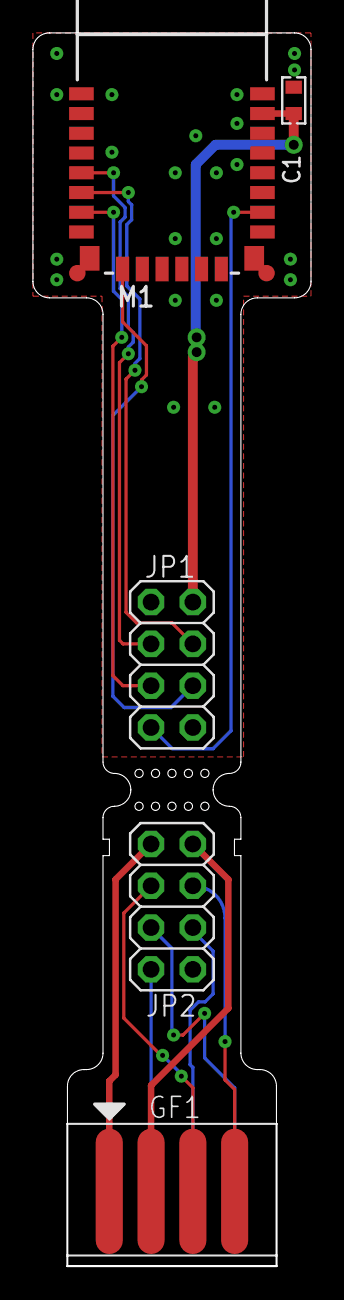
[picture p40: board BT boards 1.0.brd from above]

Board: 2 copper layers, 16.9 x 75.0 mm, 5 parts (0 on the bottom side), 14 nets.

Parts:
C1: 10u/4V; 0603
GF1: 2X4_GOLD_FINGER
JP1, JP2: 2X04
M1: RN4020; BT_MODULE

Connections:
+3.3V: C1.1, JP1.2, M1.23
+3.3V-1: GF1.3, JP2.2
BT_RTS: JP1.7, M1.18
BT_RTS-1: GF1.4, JP2.7
BT_U5RX: JP1.3, M1.5
BT_U5RX-1: GF1.5, JP2.3
BT_U5TX: JP1.4, M1.6
BT_U5TX-1: GF1.7, JP2.4
CON_LED: JP1.6, M1.10
CON_LED-1: GF1.6, JP2.6
DGND: C1.2, JP1.1, M1.1, M1.9, M1.9-1, M1.16, M1.16-1, M1.24
DGND-1: GF1.1, JP2.1
WAKE_SW: JP1.5, M1.7
WAKE_SW-1: GF1.8, JP2.5
