alleybeachelectric/Gen6/(commit log)

2017-10-26 initial push
    [Gen6 REV0.1.brd, Gen6 REV0.1.sch]
2018-02-02 organized into one location
    re init
    [ACB-R1.0-43-CH04.brd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]
2018-02-02 changed folder name
    to avoid confusion
    [ACB-R1.0-43-CH04.brd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]
2018-02-05 quick edit
    renamed some nets for the ACB
    [ACB-R1.1.sch]
2018-02-16 addedd some info to the SCH
    [ACB-R1.1.sch]
2018-02-20 routing
    a tone of routing work on the PCB, close to 35% done. camera and camera power routed, RAM routed, eeprom routed, started routing LAN.
    TODO: find new BT connector, figure out how the IR LED's will be placed on PCB (wire or second connector), route LAN and rest of power, layout and route latch and door components.
    [ACB Jr..brd, ACB Jr..sch]
2018-02-23 huge update
    Added finished schematic for ACB Lite 3.1, ready for fab after Jaroslavs review.
    [ACB Jr. r.02.brd, ACB Jr. r.02.sch, ACB Jr. r.02bad.sch, ACB Jr..brd, ACB Jr..sch, ACB Jr.3.brd, ACB Jr.3.sch, ACB Jr.6.brd]
2018-02-23 rev0.2 BT board
    [BT Carrier 0.2.brd, BT Carrier 0.2.sch, BT carrier 0.1.sch]
2018-02-24 adeded ACB LITE 3.2 with fab files
    [ACB-Lite 3.2.brd, ACB-Lite 3.2.sch, rd.ACB LITE R3.2 BOM.xlsx]
2018-02-28 added BT 2.0 carrier
    need to add panelized version with connector pcb
2018-02-28 added jaroslav's latest design.
    added jaroslav's latest design.
    [ACB-Lite-1.0-J08.brd, ACB-Lite-1.0-J08.sch]
2018-02-28 added connector board
    added connector board and routed. found allignment issue in BT board, and fixed it, need to get files approved by Petr and Jaroslav.
    [BT Carrier 0.2.brd, BT Carrier 0.2.sch]
2018-02-28 rename file
    [BT boards 1.0.brd, BT boards 1.0.sch]
2018-03-06 BT boards added
    [ACB-Lite-1.0-J08.brd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]
2018-03-08 gen6 board
    [ACB-Lite-1.0-J08.brd, ACB-R1.0-43-CH09.sch, FFC_Adapters_10.brd, FFC_Adapters_10.sch, PCB_ICBExt-R1.0-J36-CH01.brd, PCB_ICBExt-R1.0-J36-CH01.sch]
