alleybeachelectric/Gen6/(notices)

Notices in the files:
ACB/ignore/boardACBlight/boardACBlight/ACB-R1.0-43-CH13.brd:
(C) 2017 eLock Technologies LCC
ACB/ignore/boardACBlight/boardACBlight/PCB_eLock_G592_J1.brd:
Copyright (C) 2015
CONSOLE/rev1.0/PCB_ICBExt-R1.0-J36-CH01.brd:
(C) 2018 eLock Technologies LLC
parts and their libraries:
SparkFun-Hardware: Licensing: Creative Commons ShareAlike 4.0 International - https://creativecommons.org/licenses/by-sa/4.0
